bobbybudnick/SFS-Mobile-Internet-Device/WIN_20200922_145150.JPG

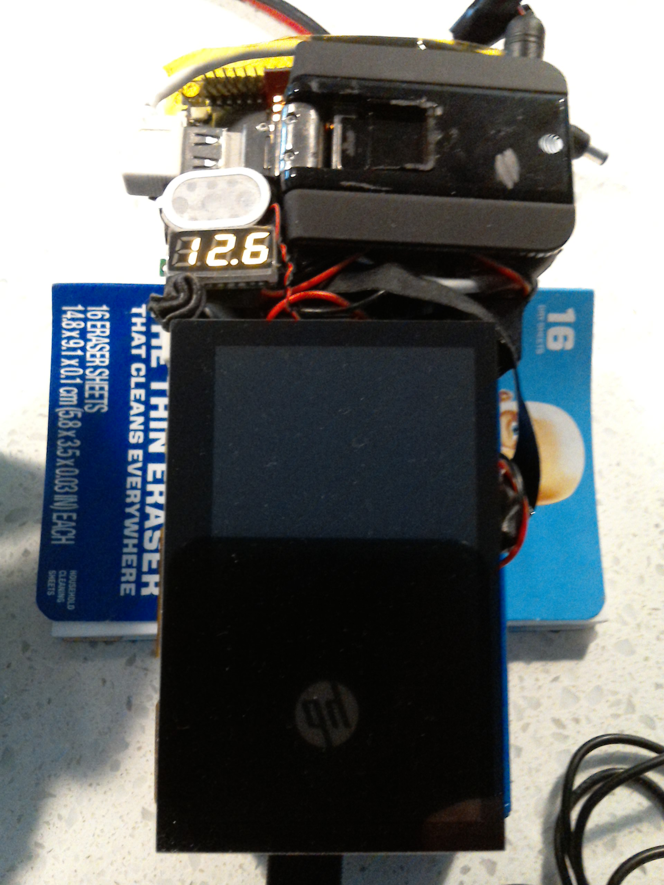
WIN_20200922_145150.JPG
