bobbybudnick/SFS-Mobile-Internet-Device/WIN_20200922_145137.JPG

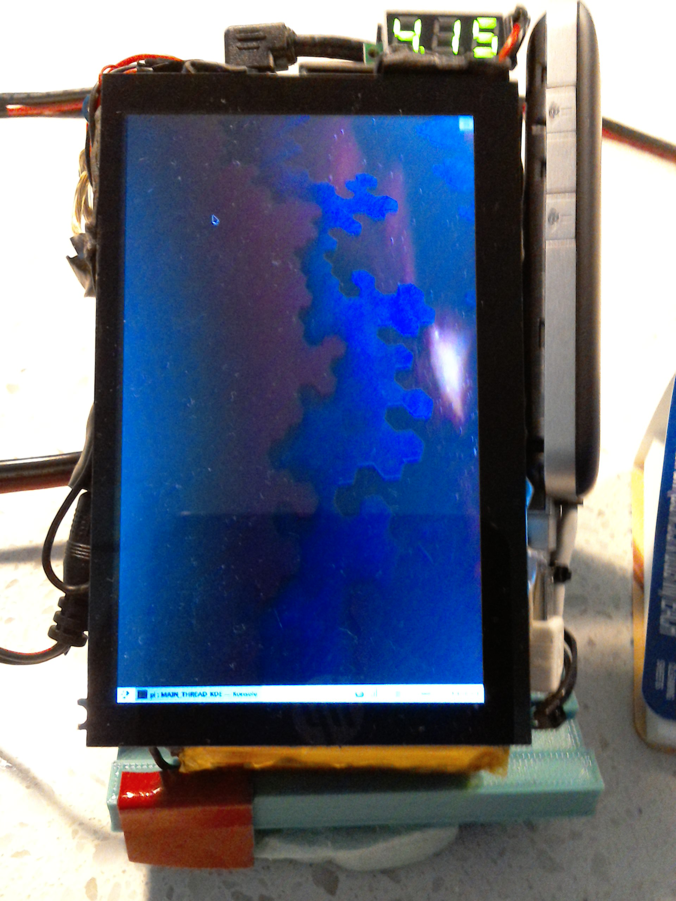
WIN_20200922_145137.JPG
