bobbybudnick/SFS-Mobile-Internet-Device/DIAGRAM1.jpg

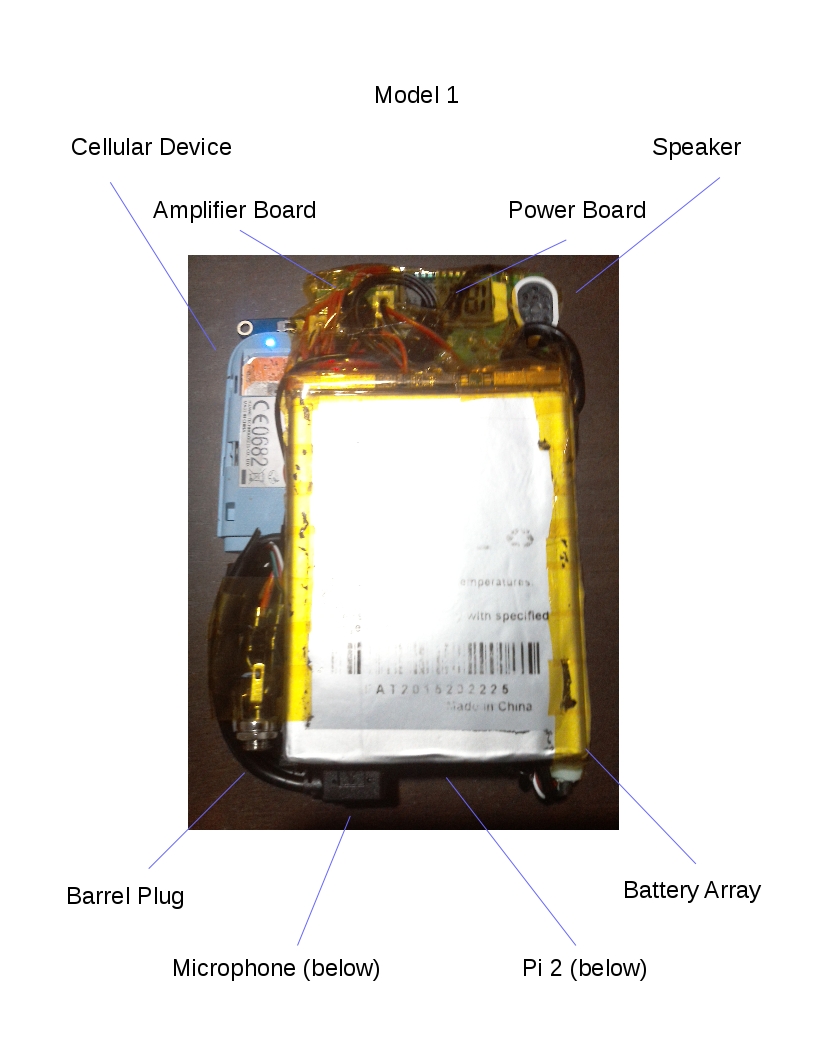
DIAGRAM1.jpg
