bobbybudnick/SFS-Mobile-Internet-Device/DIAGRAM2.jpg

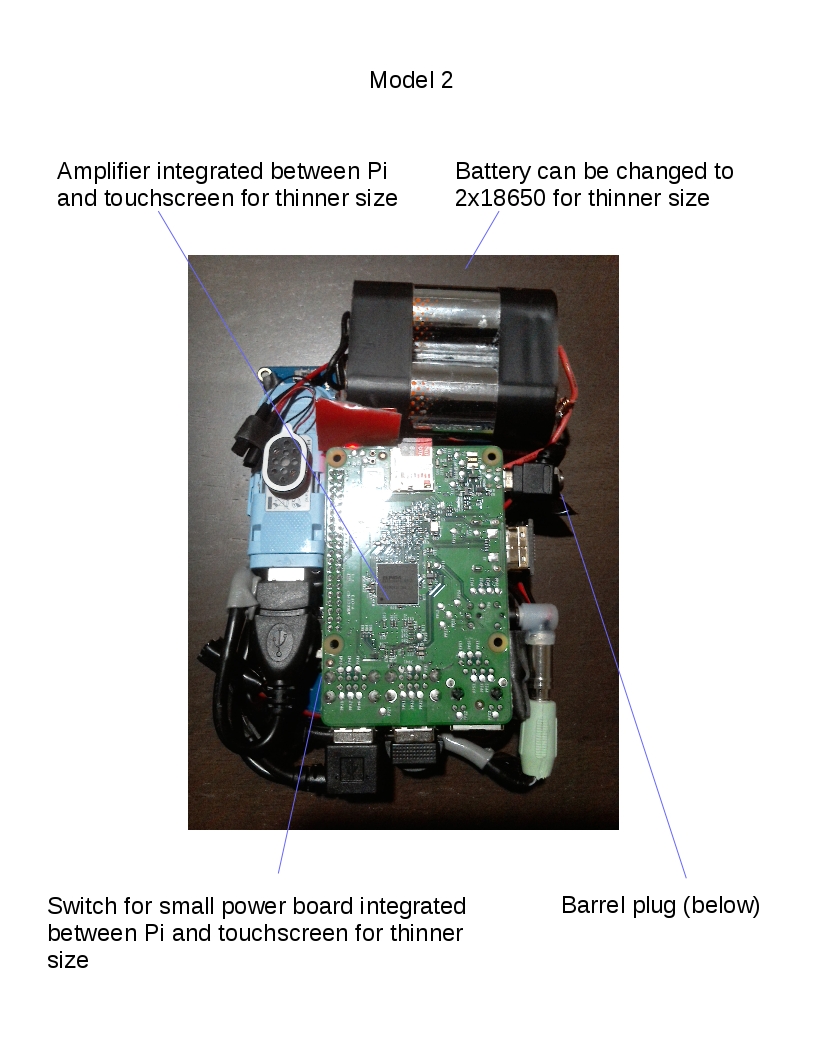
DIAGRAM2.jpg
