bobbybudnick/SFS-Mobile-Internet-Device/DIAGRAM3.jpg

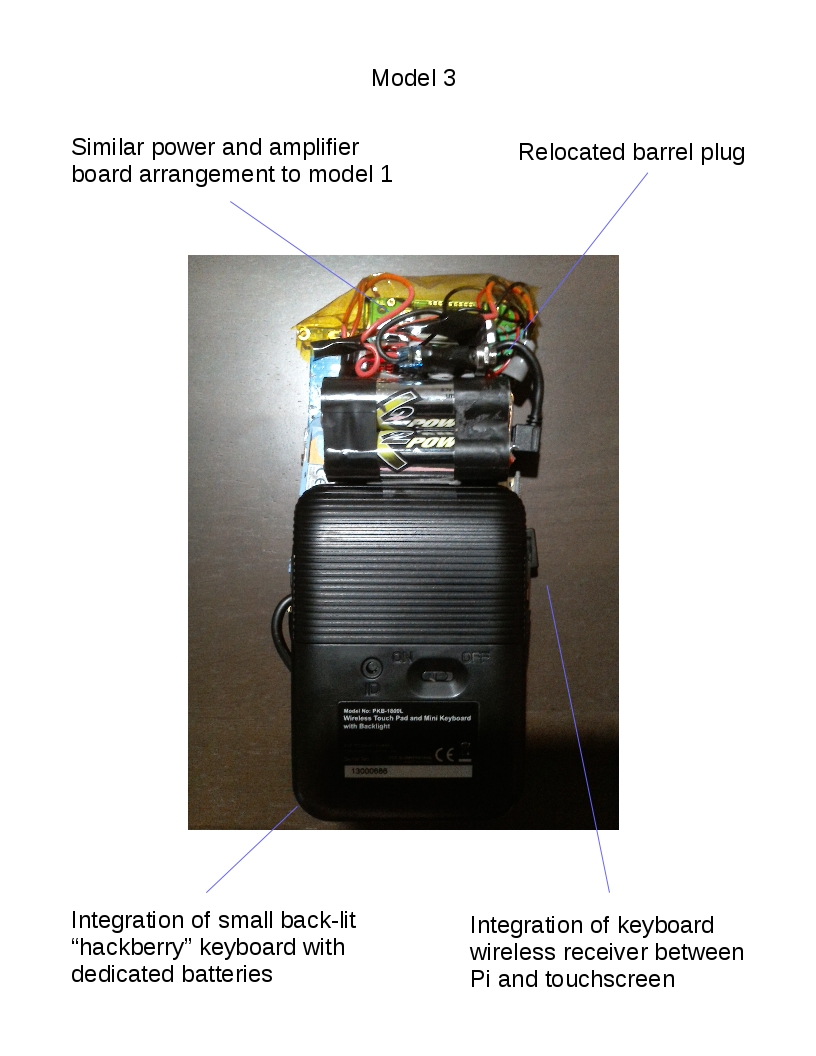
DIAGRAM3.jpg
