bobbybudnick/SFS-Mobile-Internet-Device/DIAGRAM4.jpg

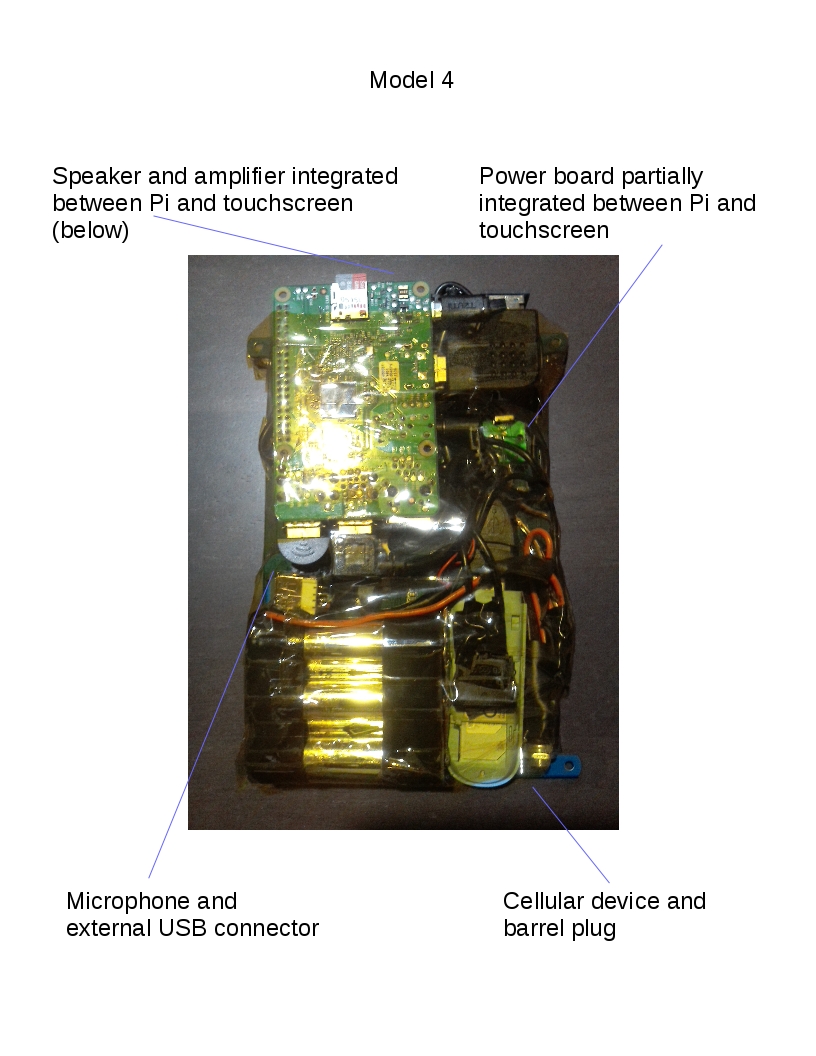
DIAGRAM4.jpg
