bobbybudnick/SFS-Mobile-Internet-Device/DIAGRAM5.jpg

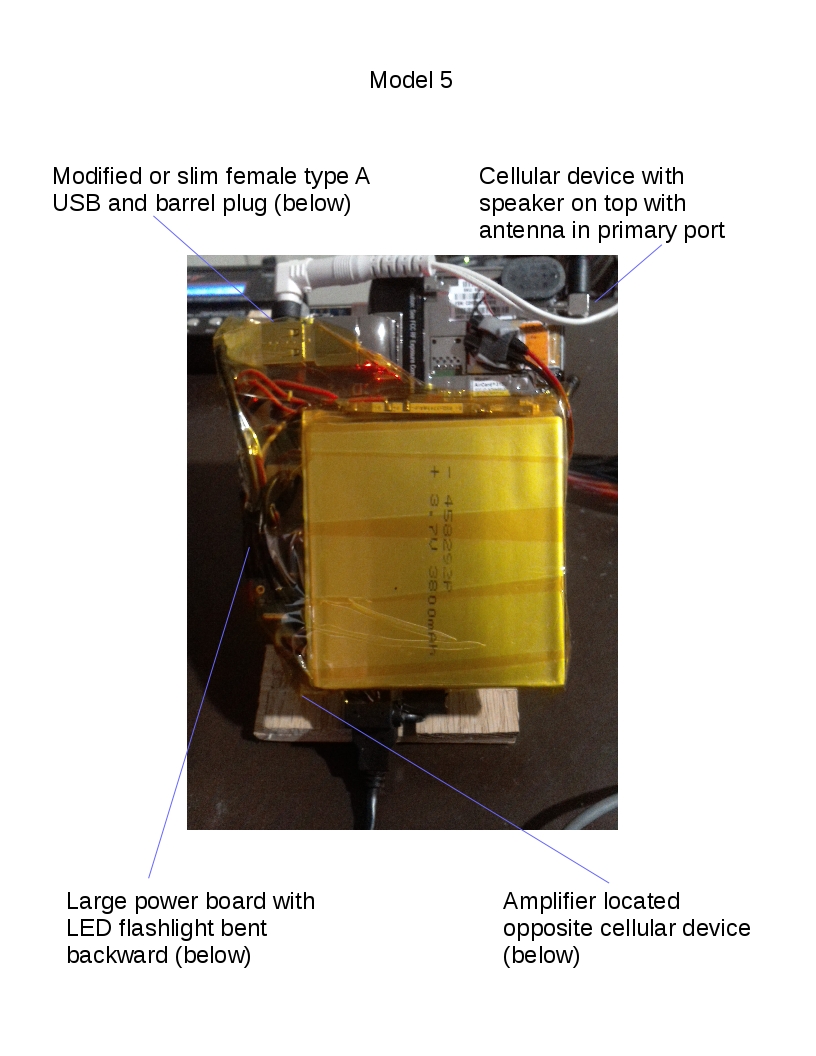
DIAGRAM5.jpg
