bobbybudnick/SFS-Mobile-Internet-Device/DIAGRAM6.jpg

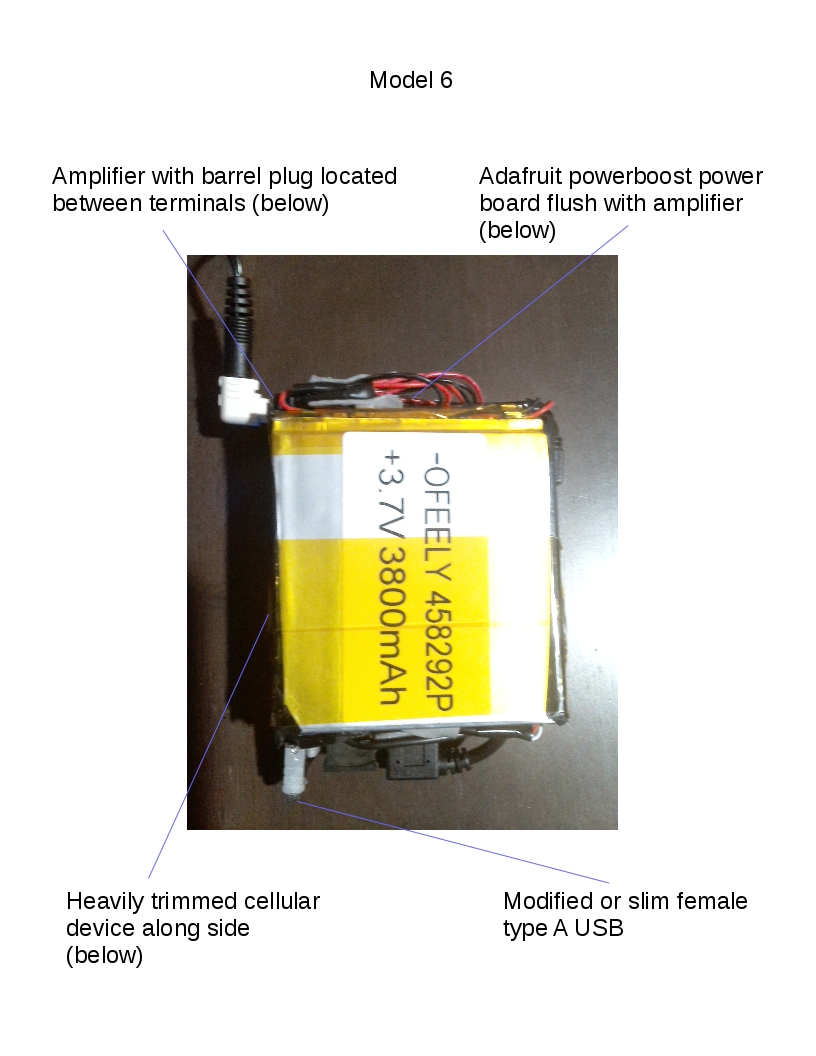
DIAGRAM6.jpg
