bobbybudnick/SFS-Mobile-Internet-Device/DIAGRAM7.jpg

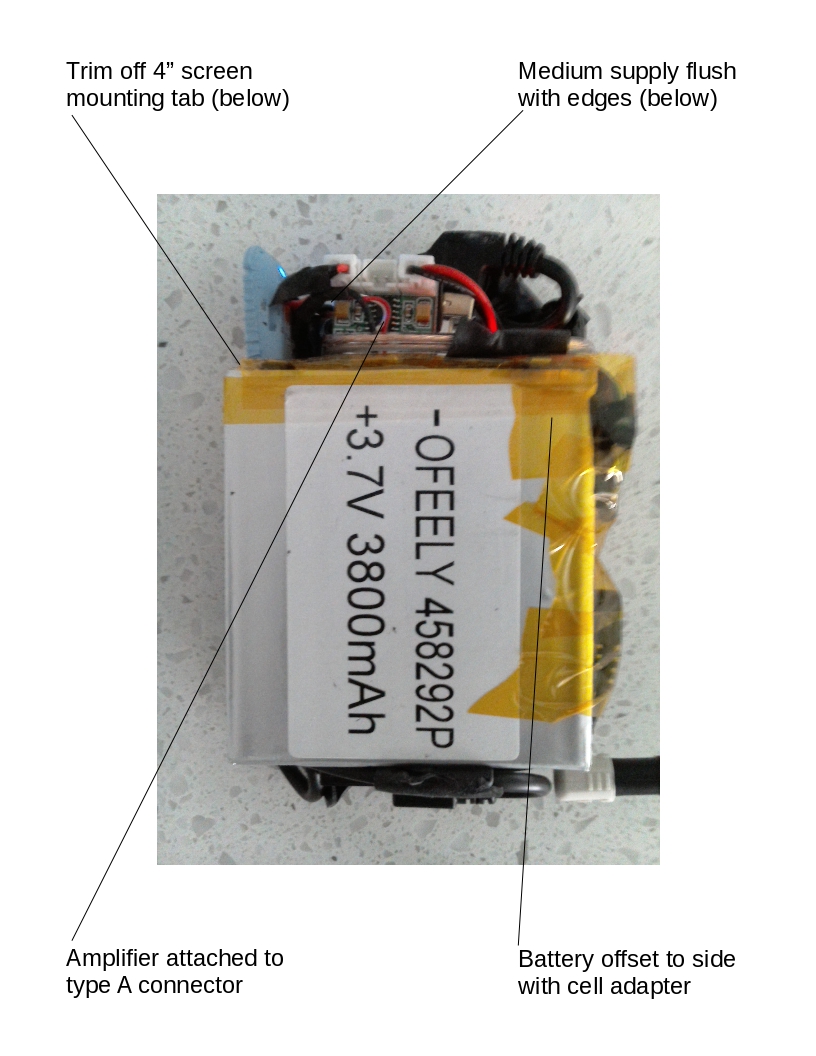
DIAGRAM7.jpg
