bobbybudnick/SFS-Mobile-Internet-Device/DIAGRAM8.jpg

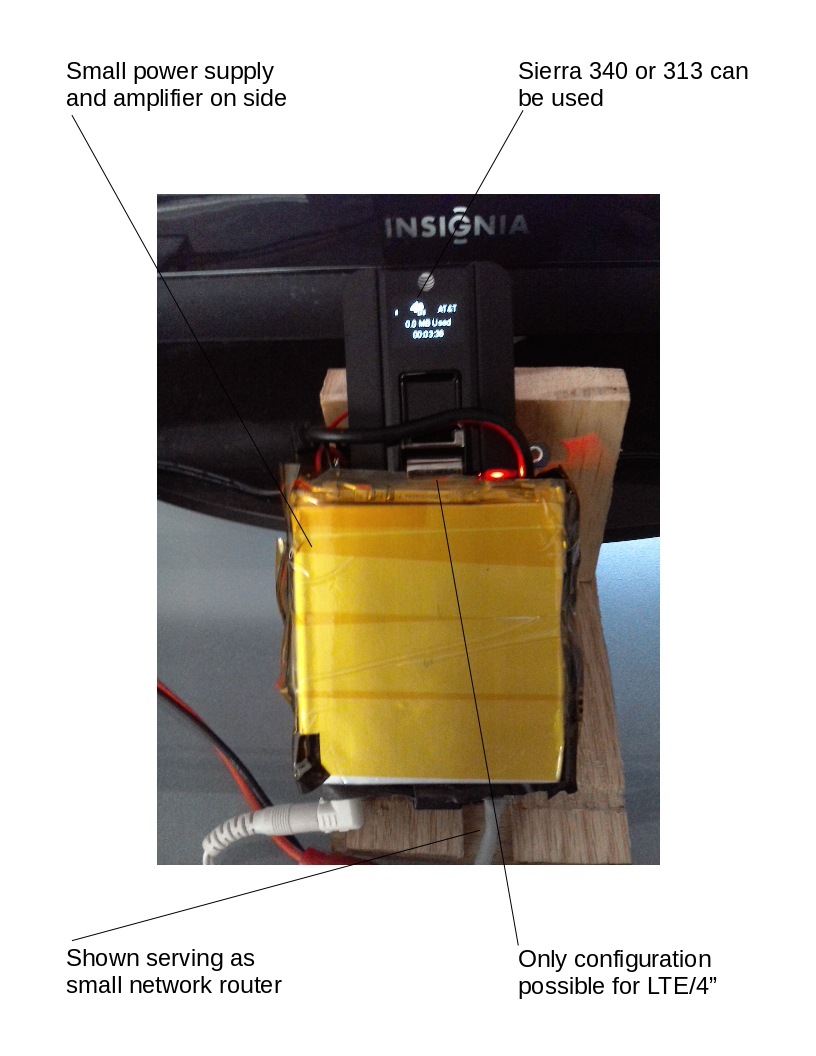
DIAGRAM8.jpg
