bobbybudnick/SFS-Mobile-Internet-Device/IMG_20220620_1944124.jpg

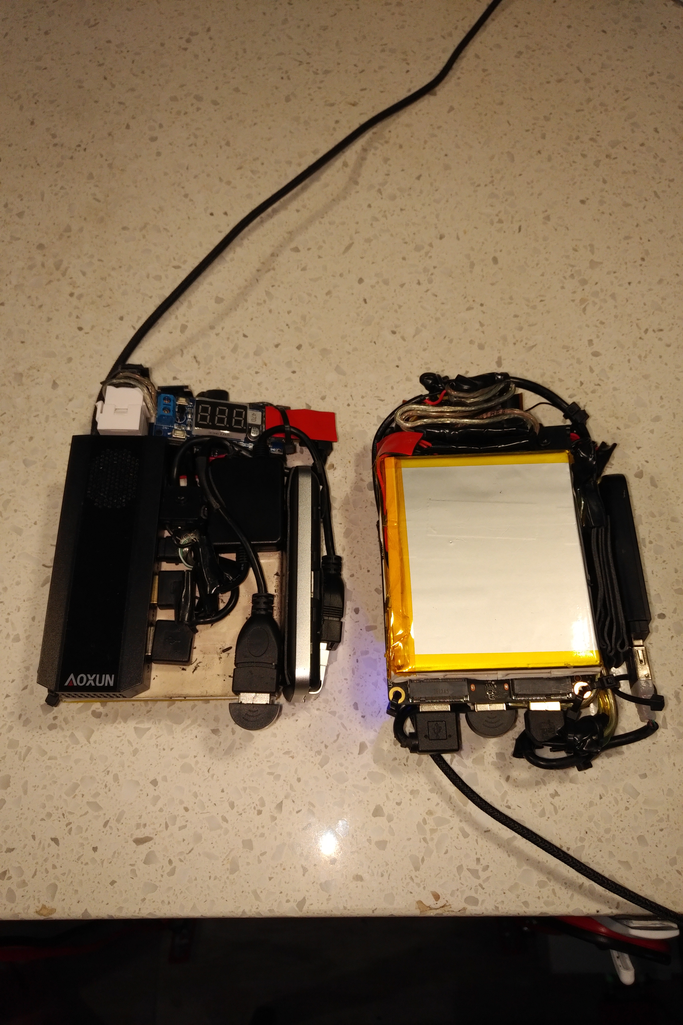
IMG_20220620_1944124.jpg
