bobbybudnick/SFS-Mobile-Internet-Device/IMG_20220621_1832572.jpg

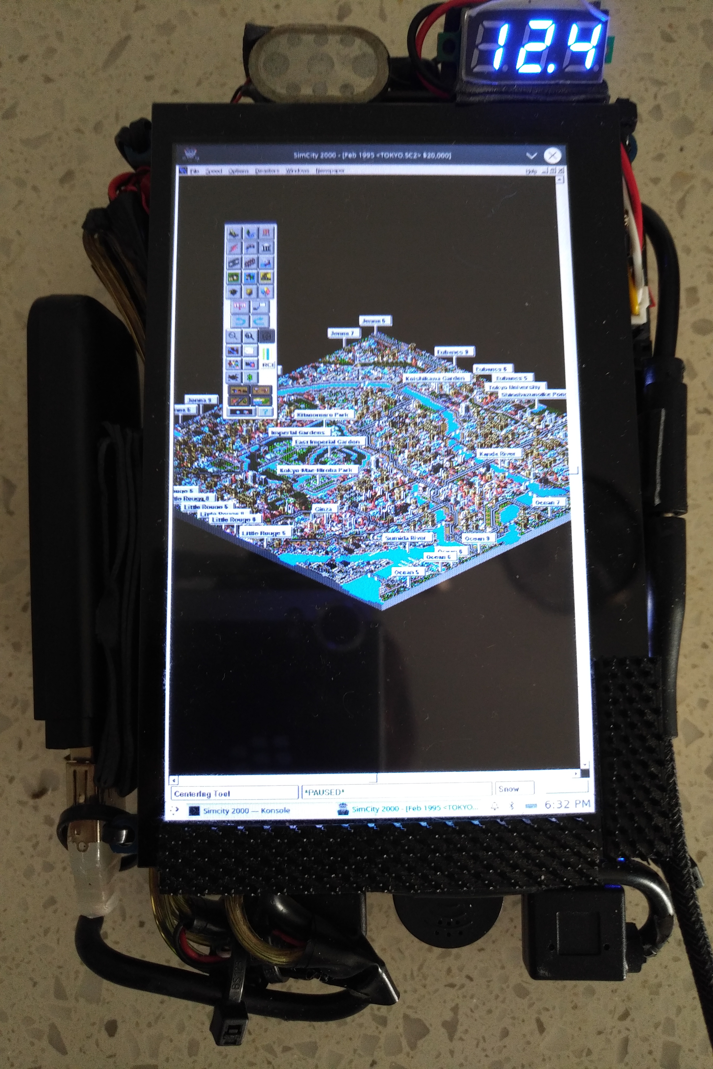
IMG_20220621_1832572.jpg
