bobbybudnick/SFS-Mobile-Internet-Device/IMG_20220621_1836071.jpg

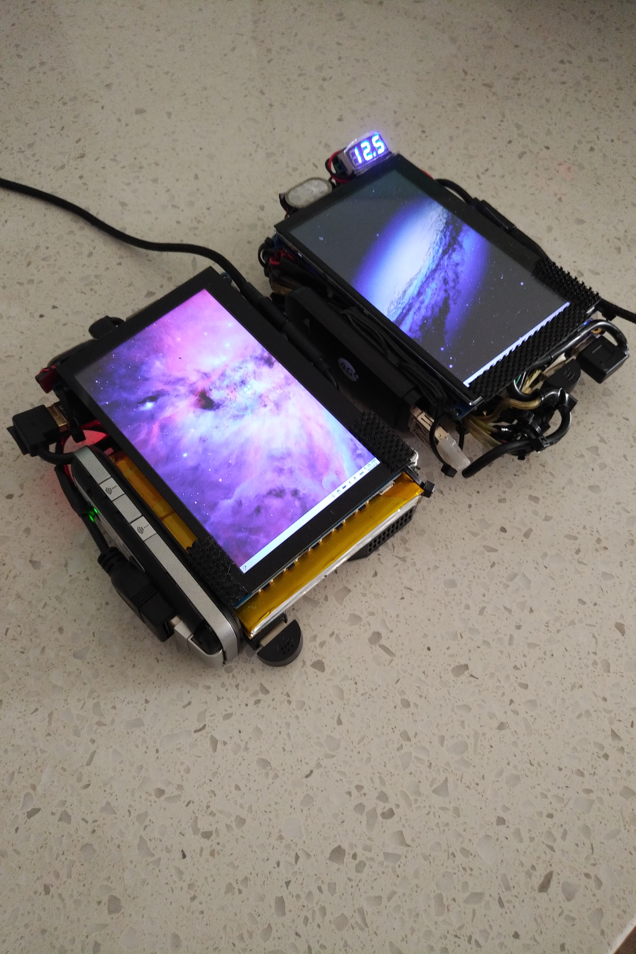
IMG_20220621_1836071.jpg
