bobbybudnick/SFS-Mobile-Internet-Device/IMG_20221021_1317442.jpg

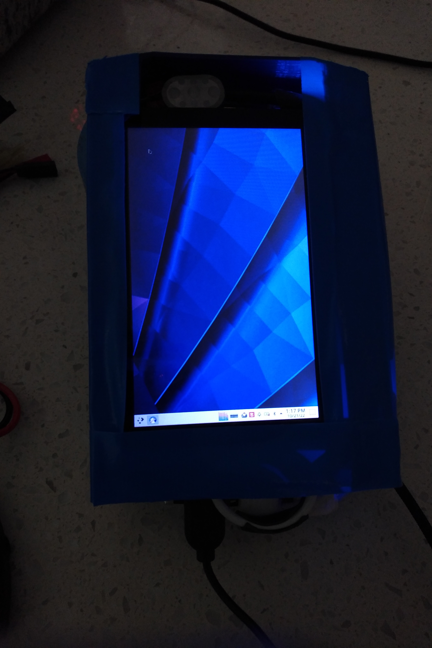
IMG_20221021_1317442.jpg
