bobbybudnick/SFS-Mobile-Internet-Device/IMG_20221023_1338296.jpg

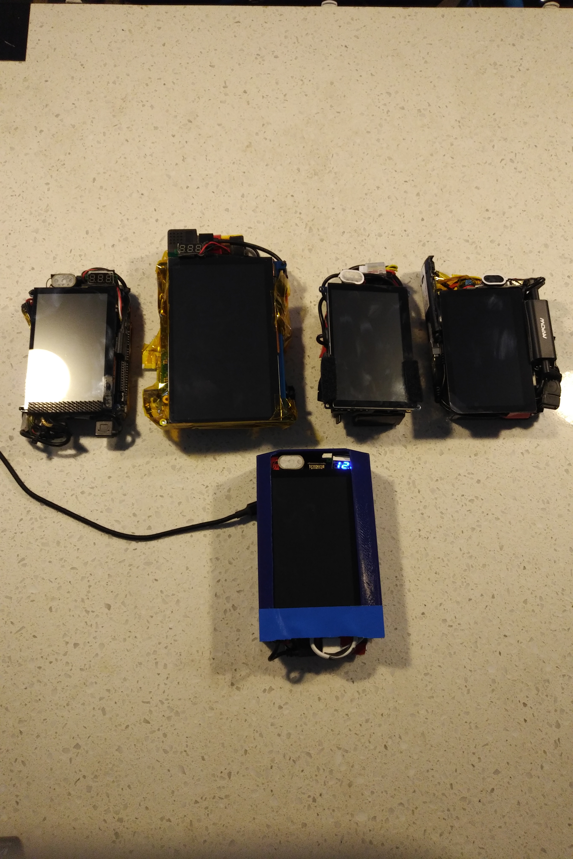
IMG_20221023_1338296.jpg
