bobbybudnick/SFS-Mobile-Internet-Device/IMG_20221023_1338296_CROPPED.jpg

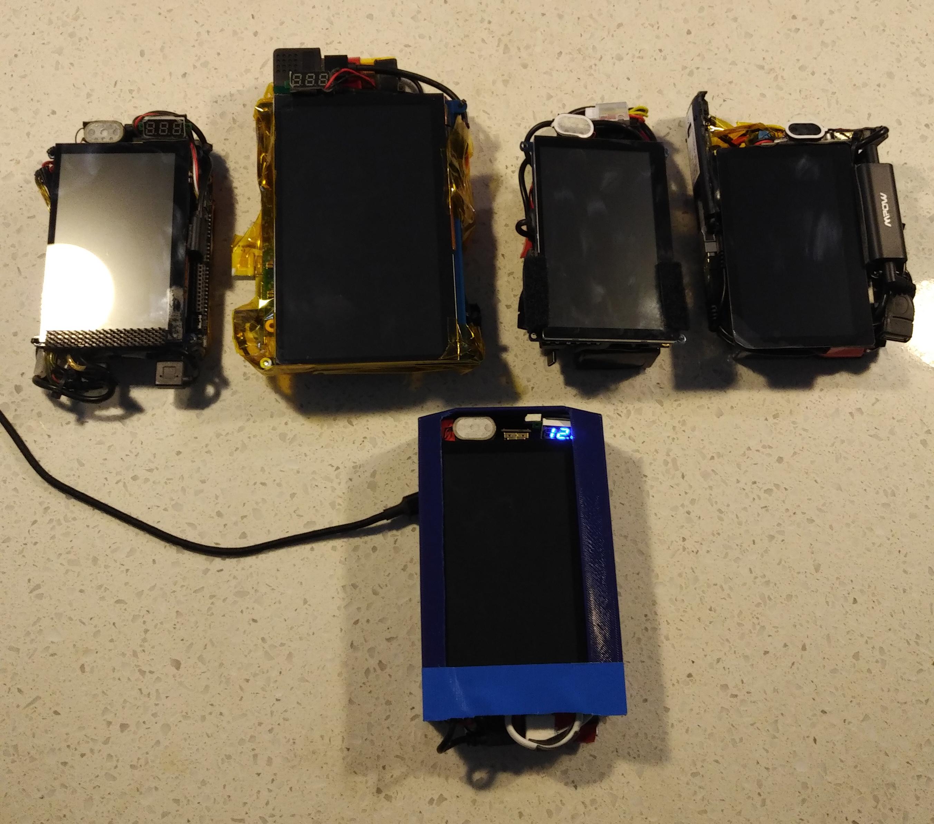
IMG_20221023_1338296_CROPPED.jpg
