bobbybudnick/SFS-Mobile-Internet-Device/IMG_20221023_1340297.jpg

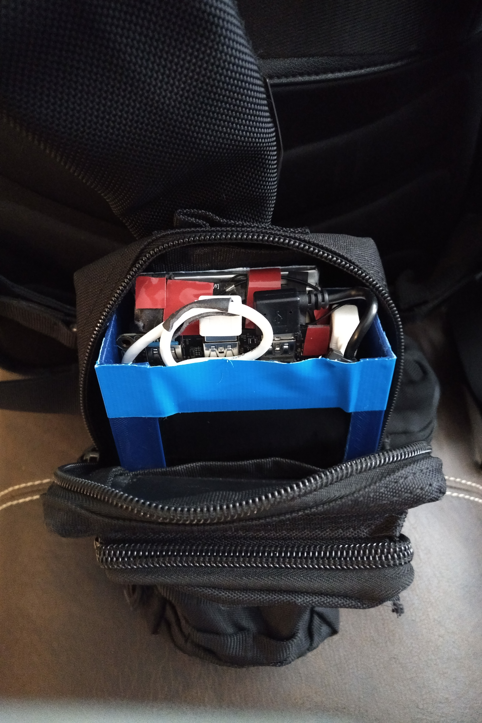
IMG_20221023_1340297.jpg
