bobbybudnick/SFS-Mobile-Internet-Device/IMG_20221023_1343329.jpg

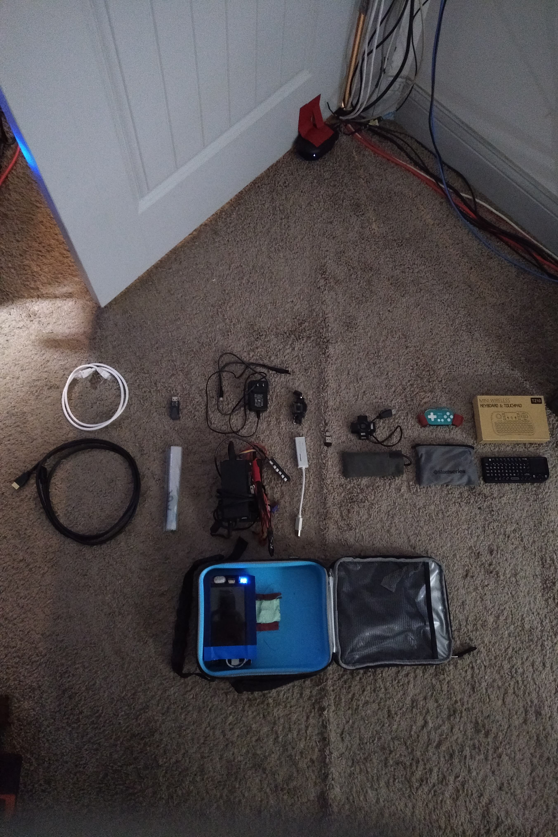
IMG_20221023_1343329.jpg
