bobbybudnick/SFS-Mobile-Internet-Device/IMG_20221023_1811454.jpg

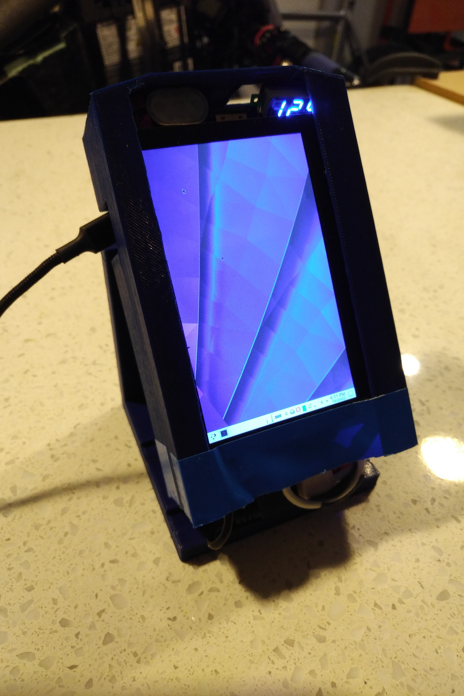
IMG_20221023_1811454.jpg
