bobbybudnick/SFS-Mobile-Internet-Device/IMG_20221119_1745131.jpg

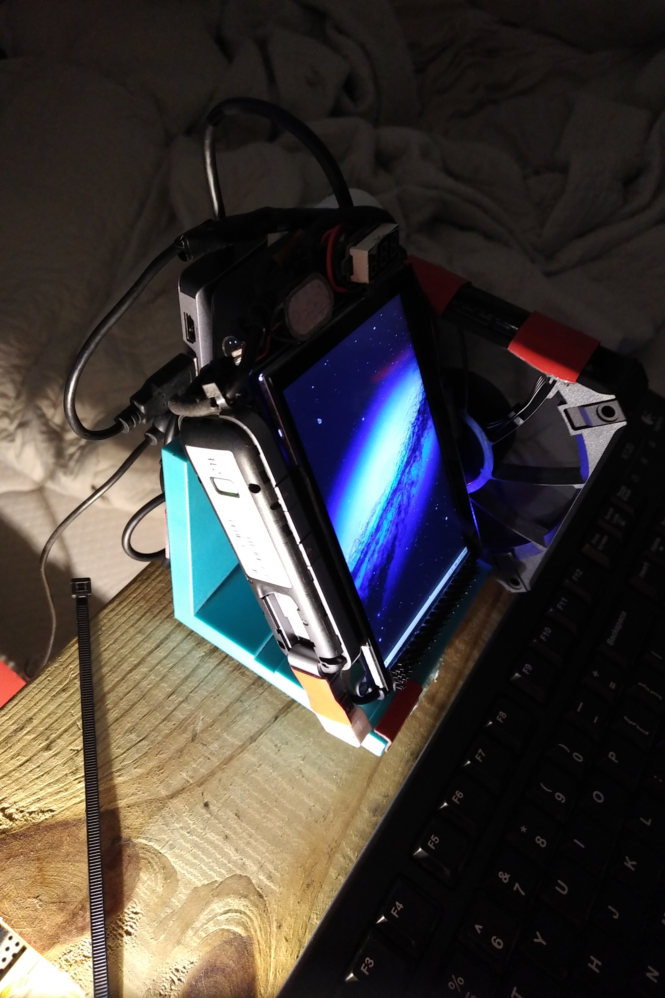
IMG_20221119_1745131.jpg
