bobbybudnick/SFS-Mobile-Internet-Device/IMG_20221130_1039581.jpg

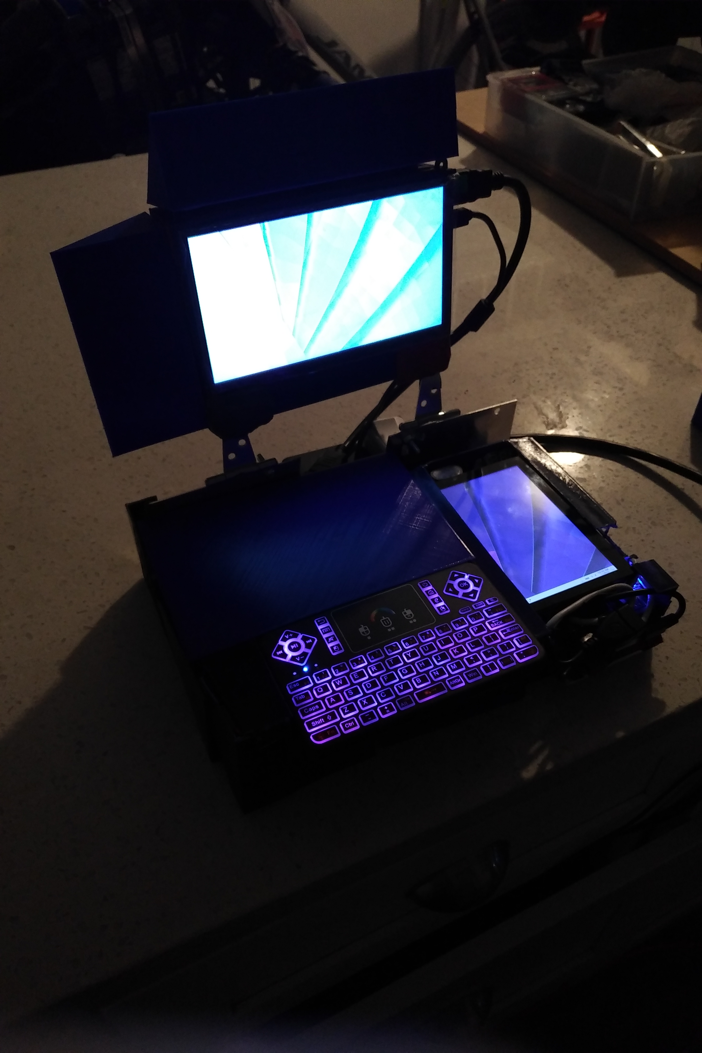
IMG_20221130_1039581.jpg
