bobbybudnick/SFS-Mobile-Internet-Device/IMG_20221130_1324098.jpg

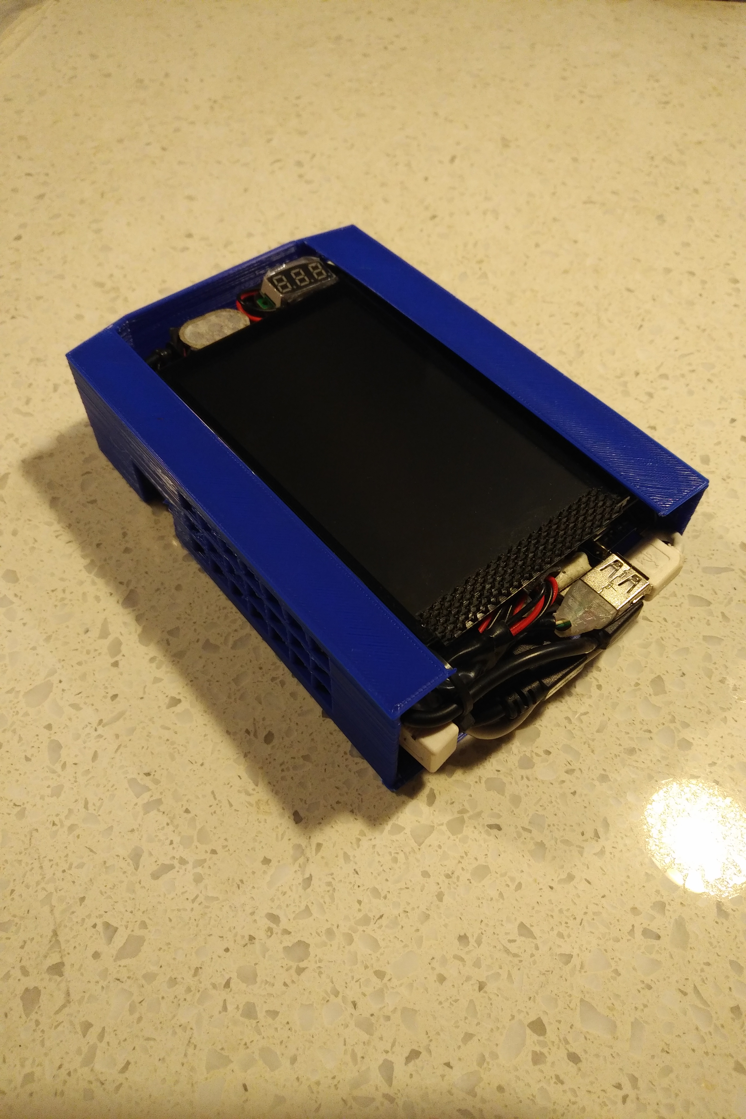
IMG_20221130_1324098.jpg
