bobbybudnick/SFS-Mobile-Internet-Device/IMG_20230730_1251246.jpg

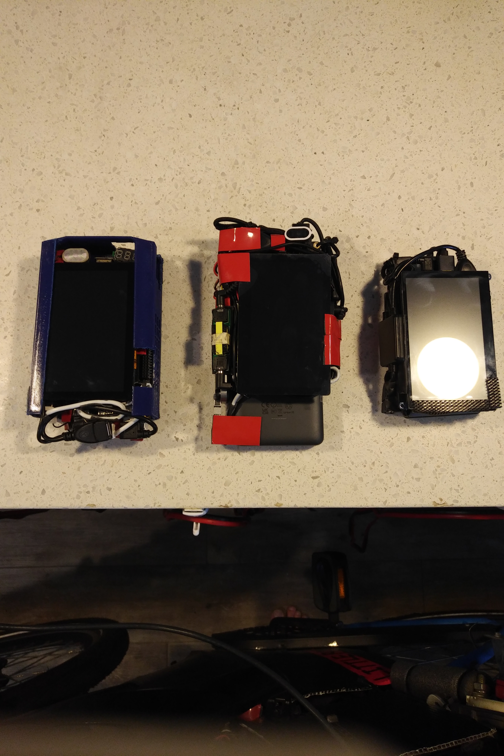
IMG_20230730_1251246.jpg
