bobbybudnick/SFS-Mobile-Internet-Device/IMG_20230730_1541438.jpg

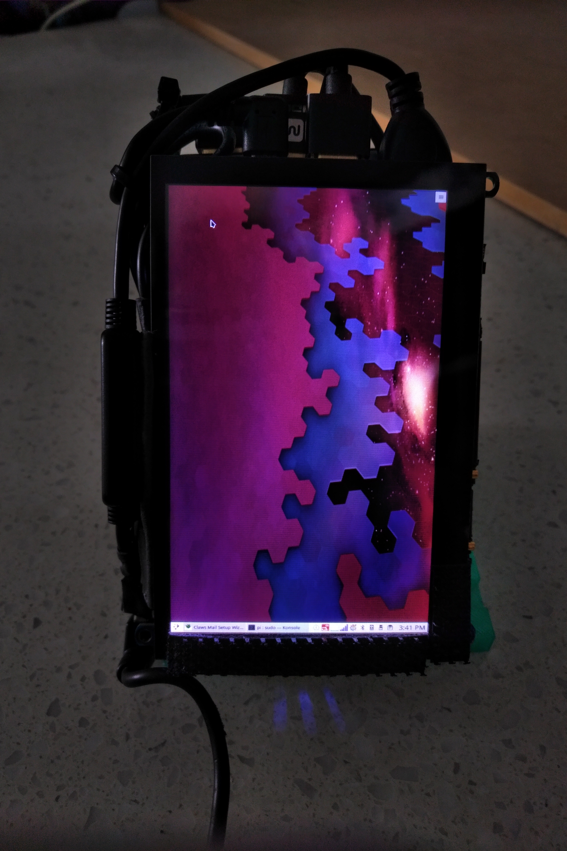
IMG_20230730_1541438.jpg
