bobbybudnick/SFS-Mobile-Internet-Device/IMG_20230812_1313022.jpg

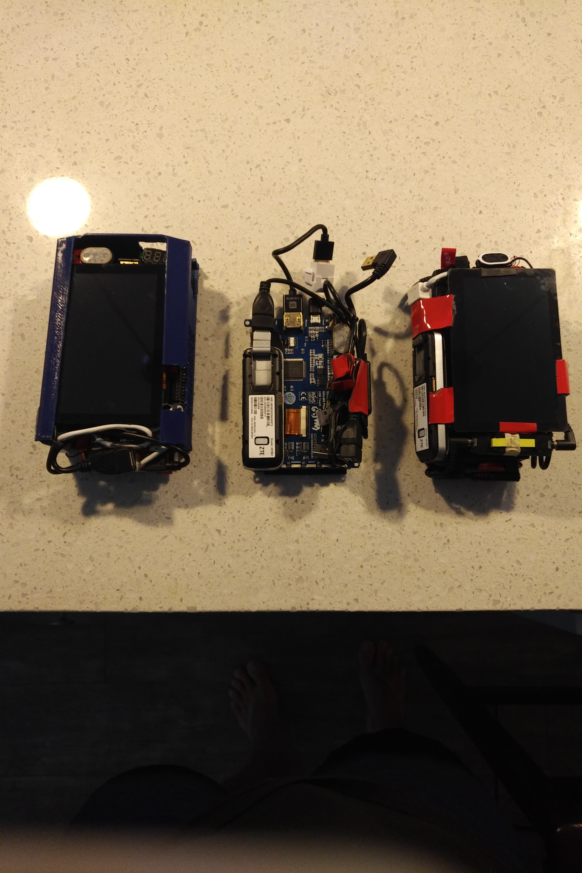
IMG_20230812_1313022.jpg
