bobbybudnick/SFS-Mobile-Internet-Device/IMG_20230812_1506374.jpg

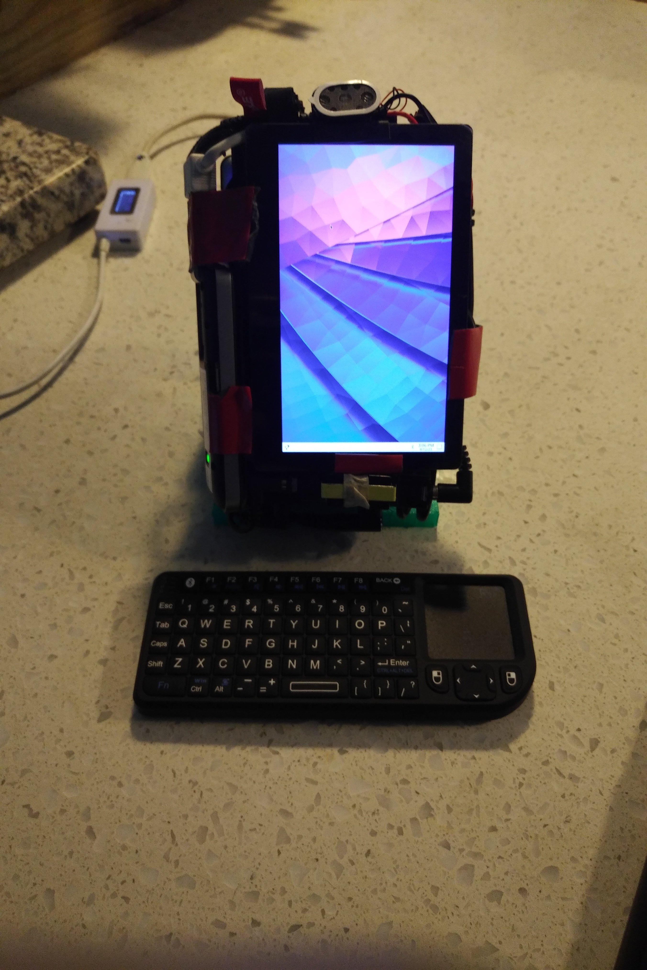
IMG_20230812_1506374.jpg
