bobbybudnick/SFS-Mobile-Internet-Device/MODEL_9.jpg

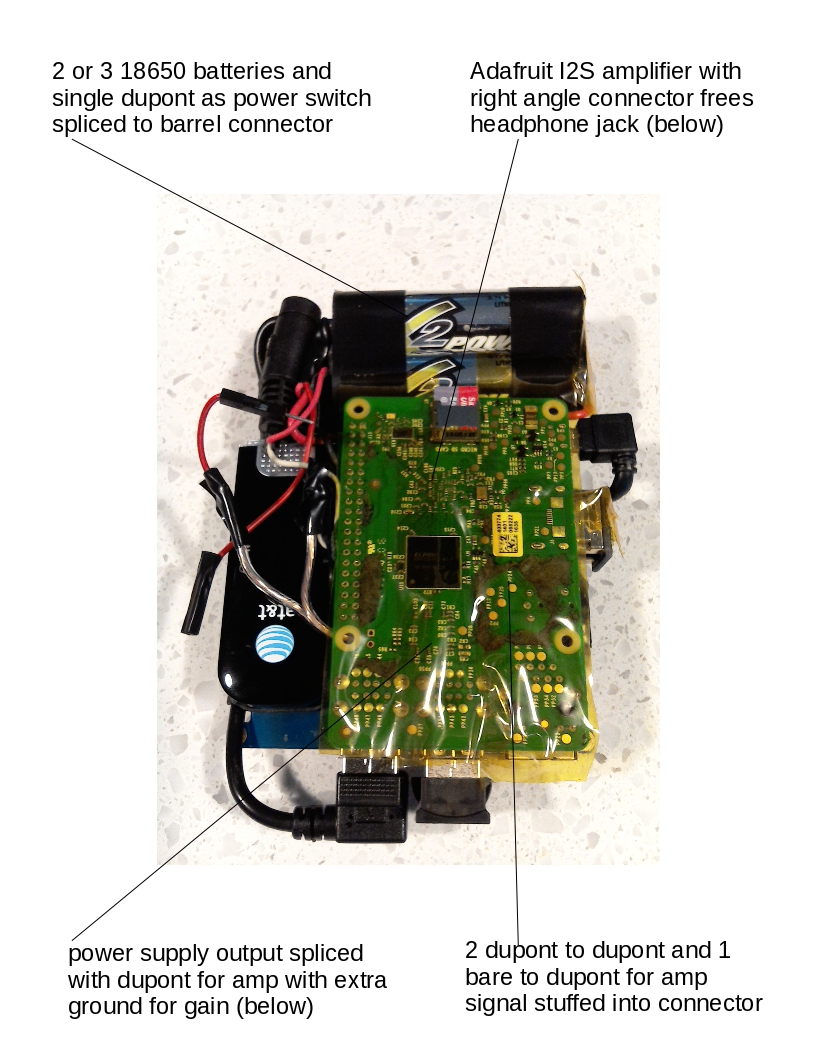
MODEL_9.jpg
