bobbybudnick/SFS-Mobile-Internet-Device/MODEL_ZERO.jpg

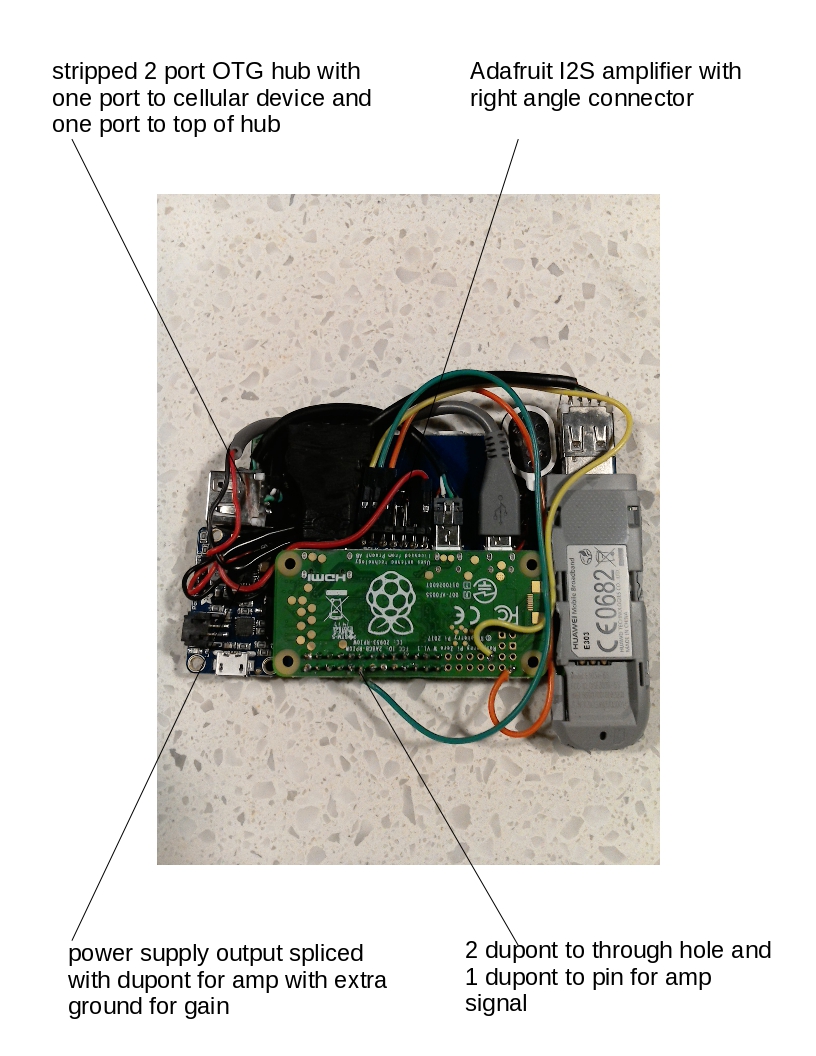
MODEL_ZERO.jpg
