bobbybudnick/SFS-Mobile-Internet-Device/WELCOME4.jpg

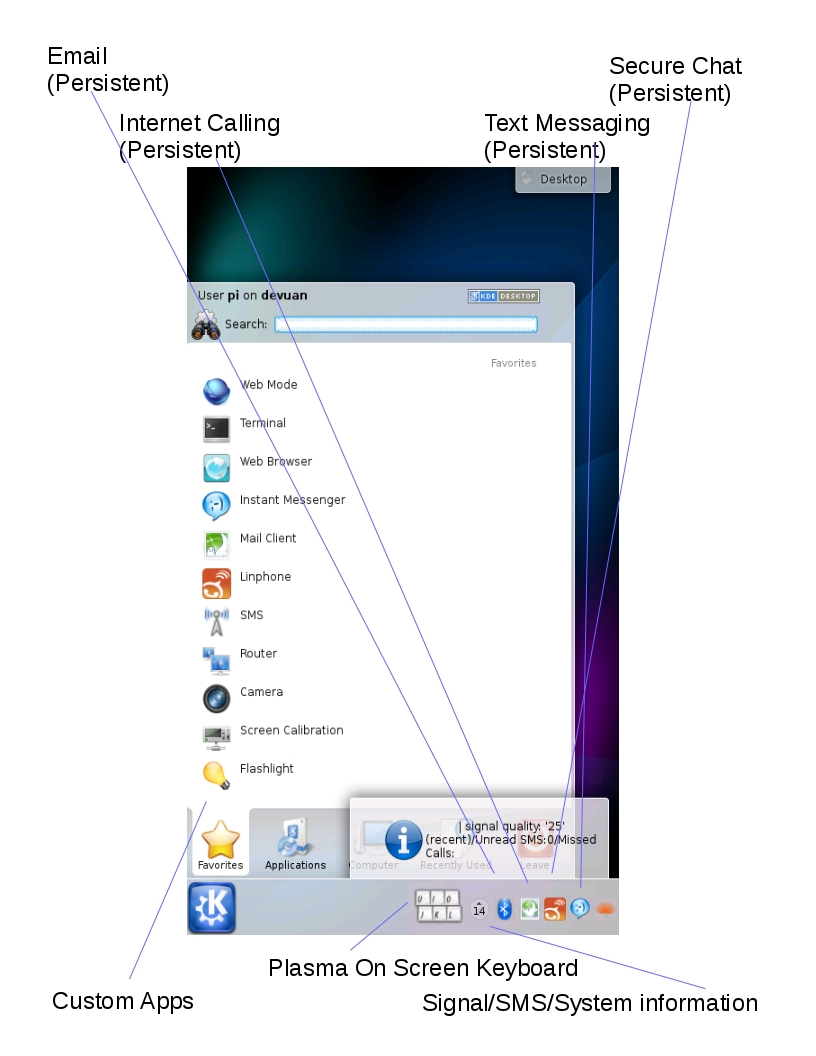
WELCOME4.jpg
