bobbybudnick/SFS-Mobile-Internet-Device/WELCOME5.jpg

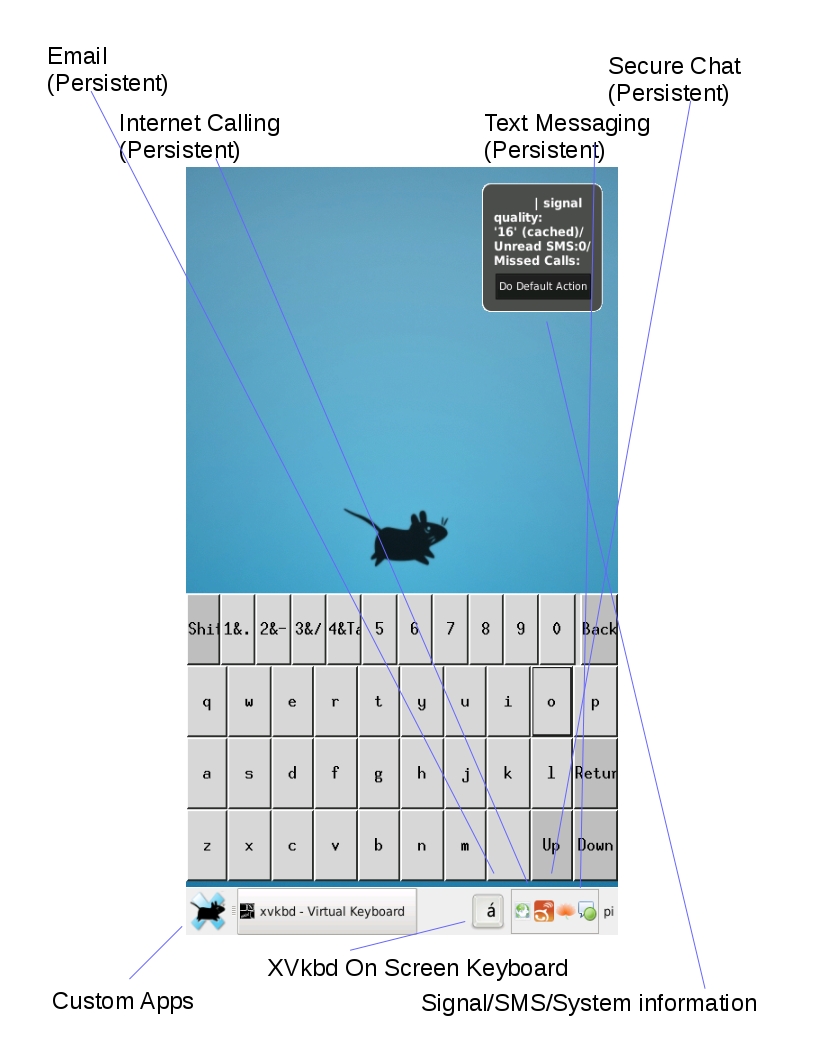
WELCOME5.jpg
