bobbybudnick/SFS-Mobile-Internet-Device/WELCOME_KDE_SMALL_1.jpg

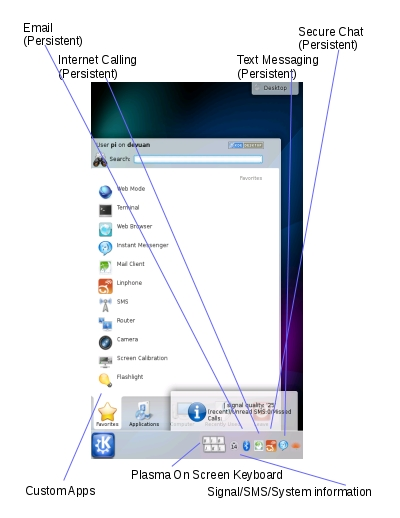
WELCOME_KDE_SMALL_1.jpg
