bobbybudnick/SFS-Mobile-Internet-Device/WIN_20161006_074420.JPG

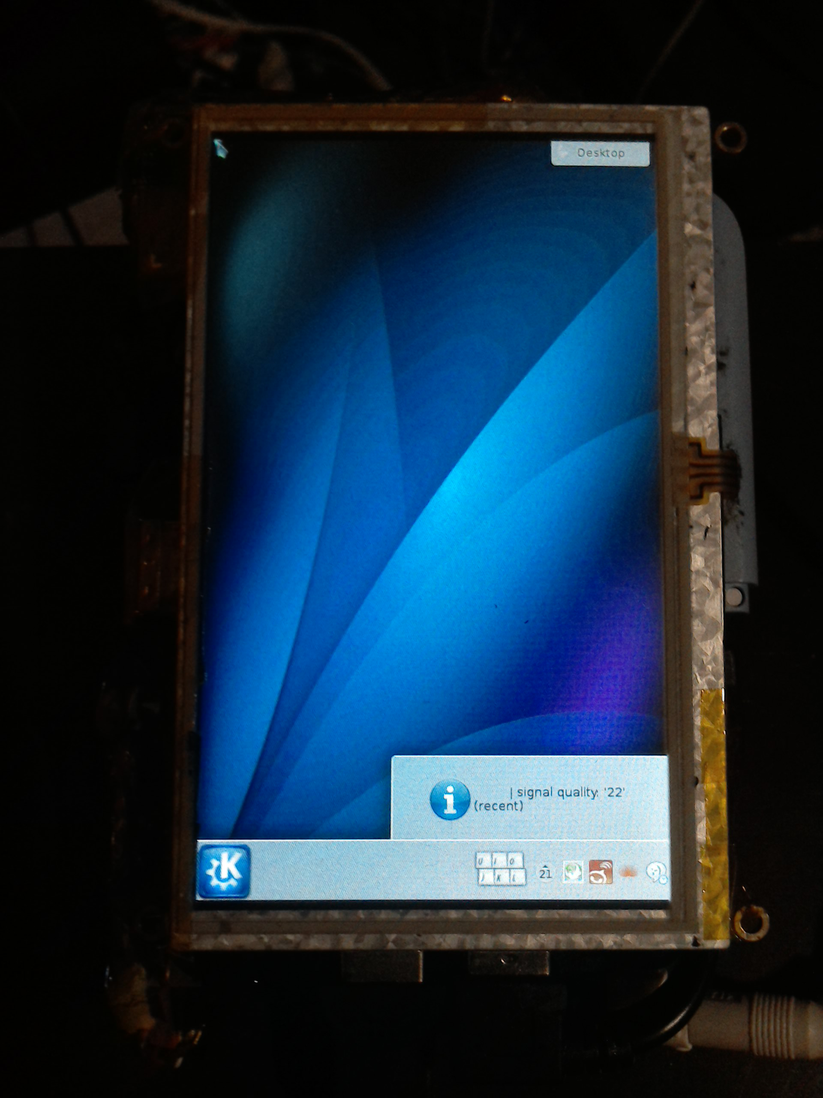
WIN_20161006_074420.JPG
