bobbybudnick/SFS-Mobile-Internet-Device/WIN_20161006_080020.JPG

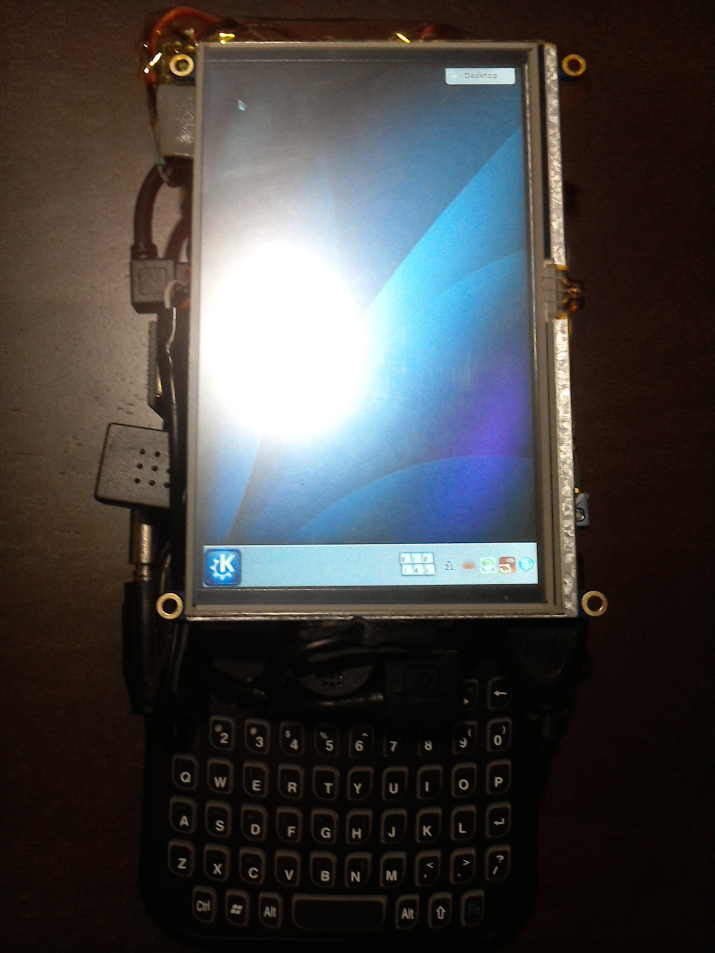
WIN_20161006_080020.JPG
