bobbybudnick/SFS-Mobile-Internet-Device/WIN_20161006_080313.JPG

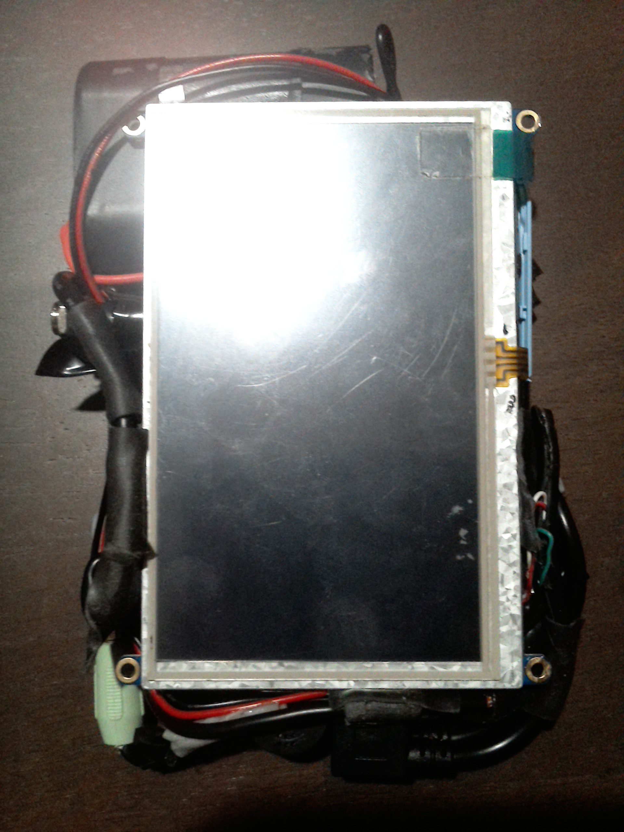
WIN_20161006_080313.JPG
