bobbybudnick/SFS-Mobile-Internet-Device/WIN_20161006_080540.JPG

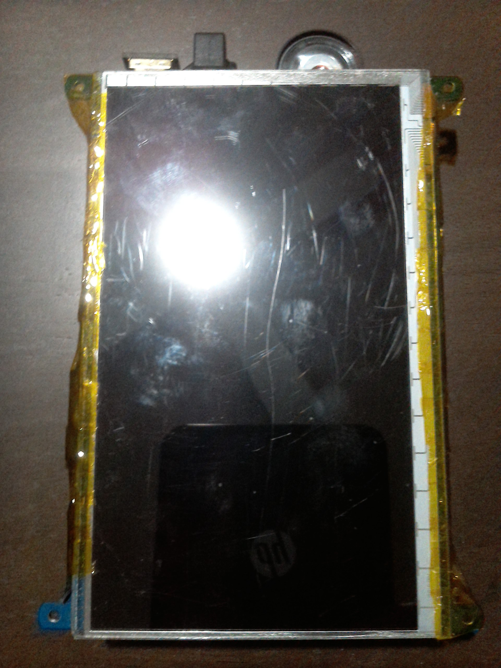
WIN_20161006_080540.JPG
