bobbybudnick/SFS-Mobile-Internet-Device/WIN_20161006_080806.JPG

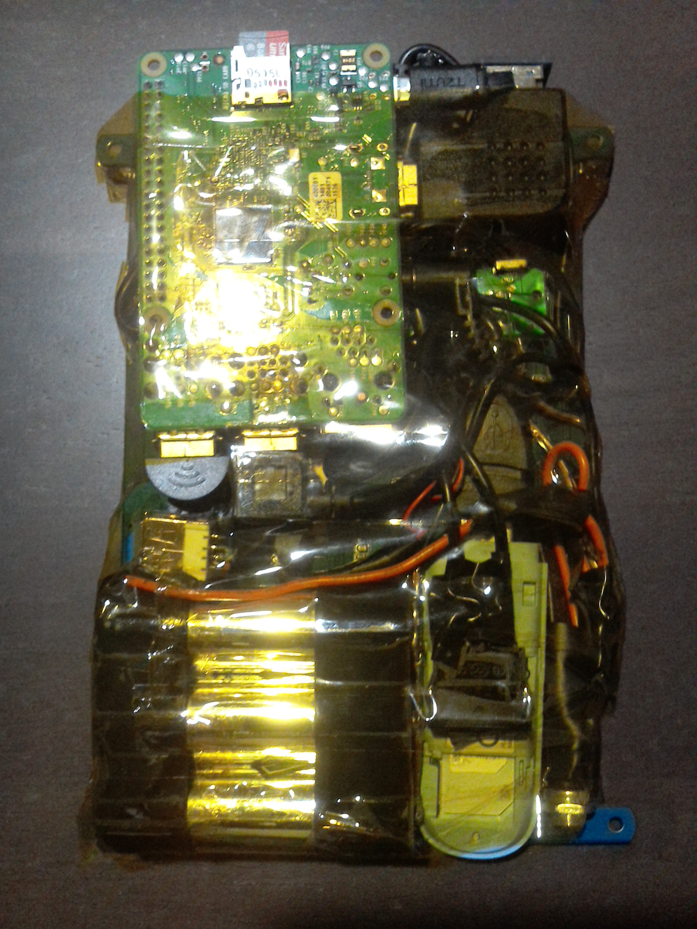
WIN_20161006_080806.JPG
