bobbybudnick/SFS-Mobile-Internet-Device/WIN_20161015_141846.JPG

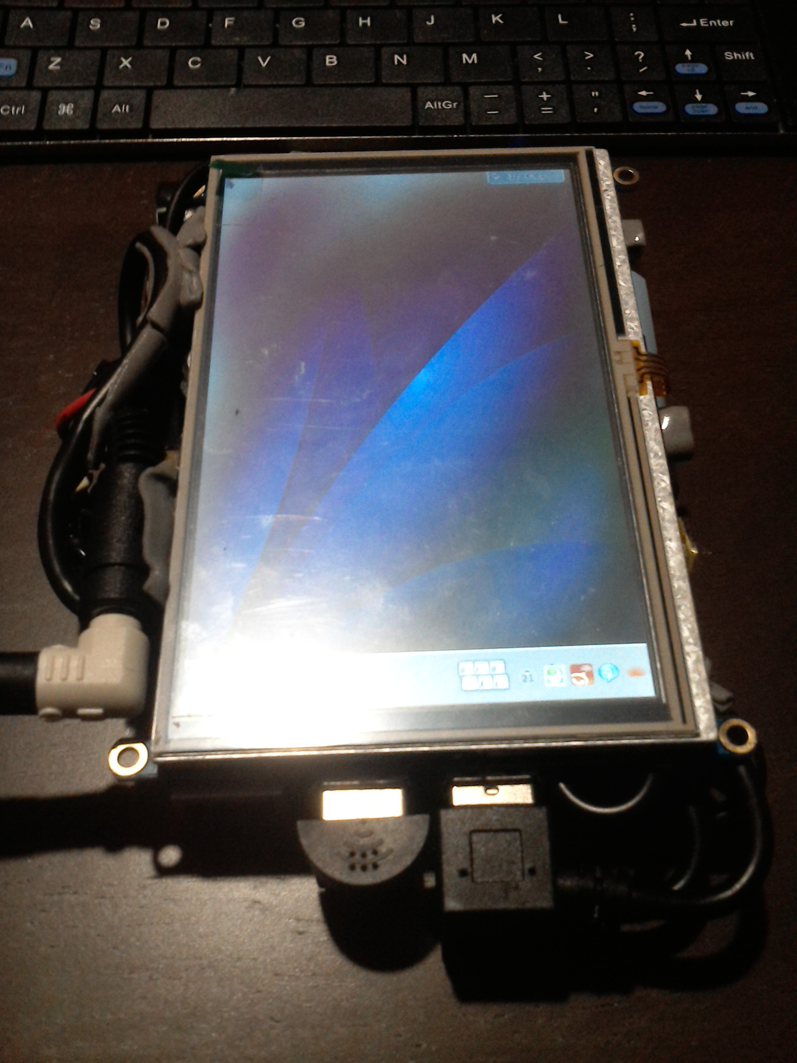
WIN_20161015_141846.JPG
