bobbybudnick/SFS-Mobile-Internet-Device/WIN_20161016_093545.JPG

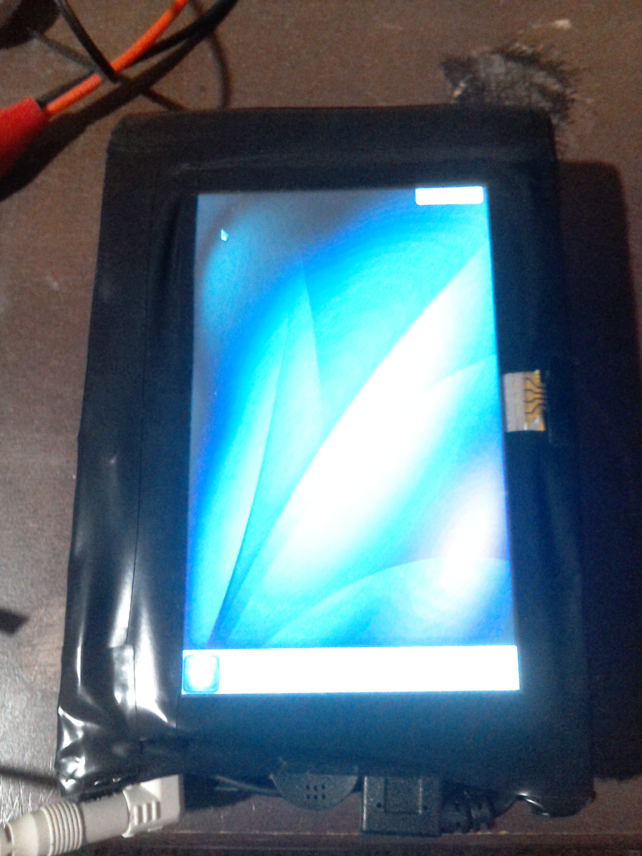
WIN_20161016_093545.JPG
