bobbybudnick/SFS-Mobile-Internet-Device/WIN_20161102_094452.JPG

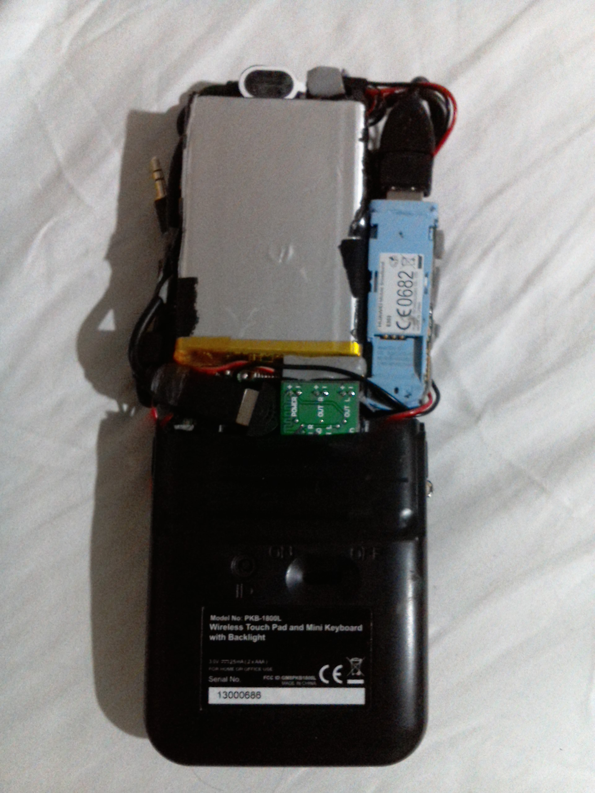
WIN_20161102_094452.JPG
