bobbybudnick/SFS-Mobile-Internet-Device/WIN_20161102_094508.JPG

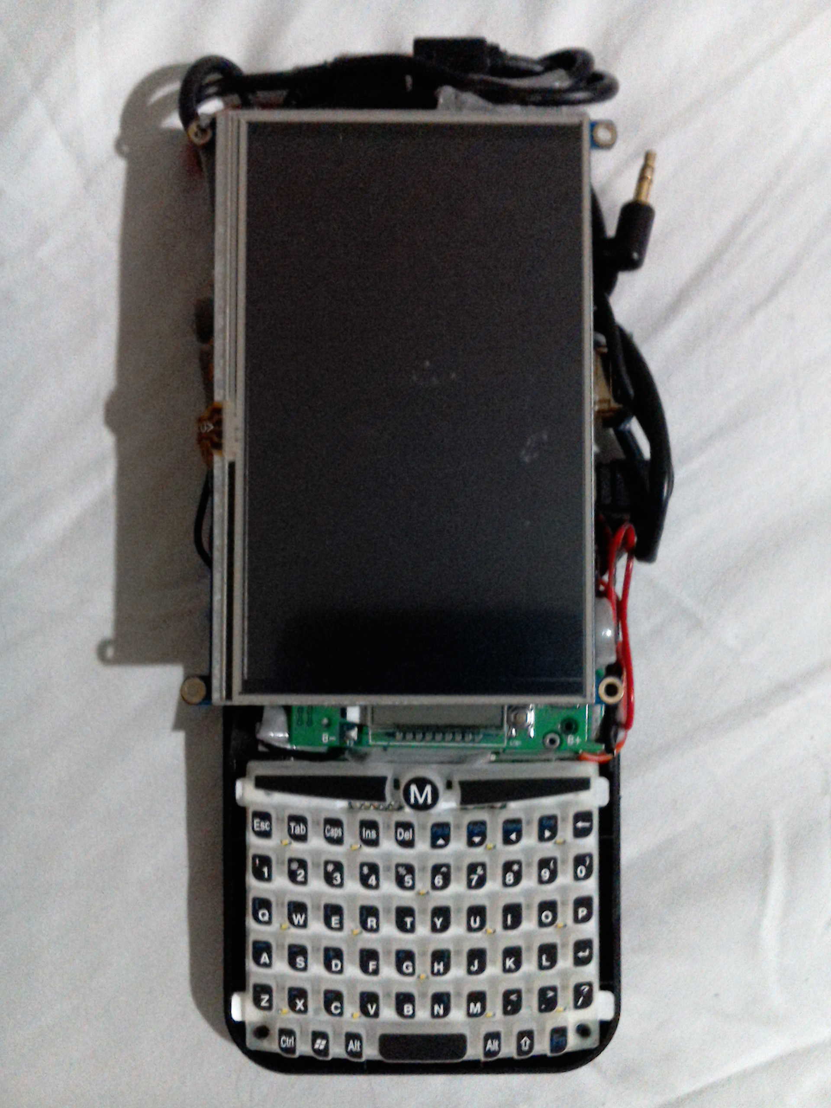
WIN_20161102_094508.JPG
