bobbybudnick/SFS-Mobile-Internet-Device/WIN_20161123_112157.JPG

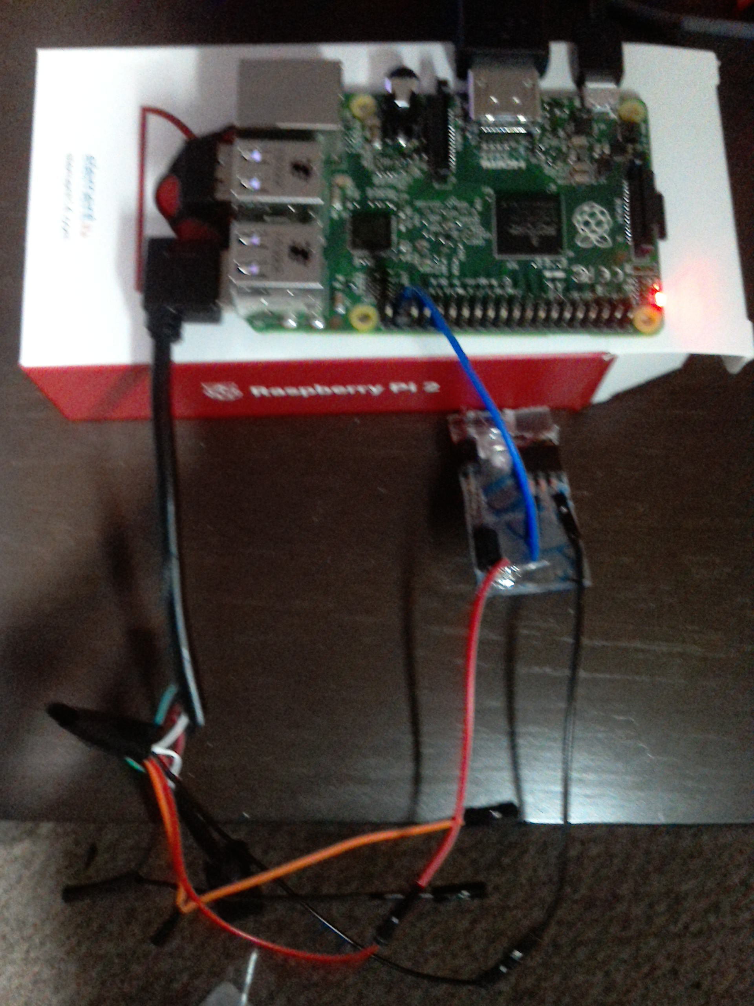
WIN_20161123_112157.JPG
