bobbybudnick/SFS-Mobile-Internet-Device/WIN_20161123_112224.JPG

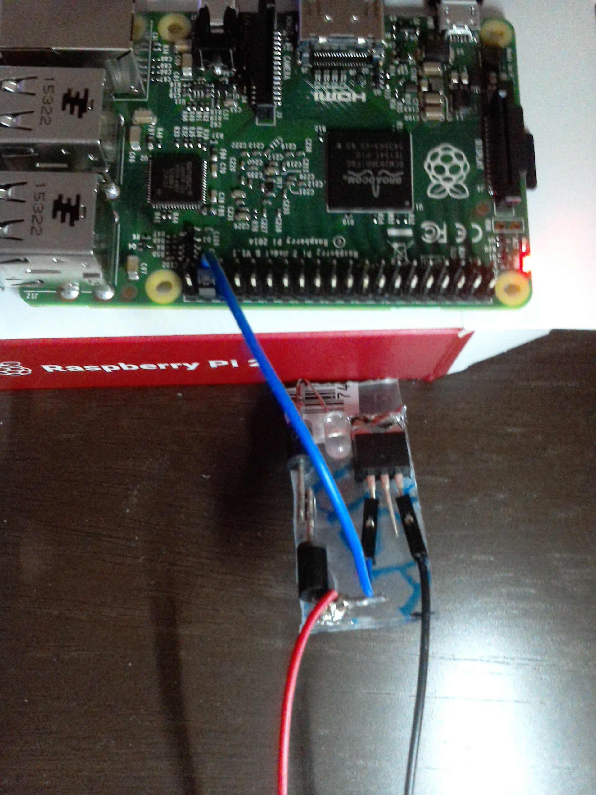
WIN_20161123_112224.JPG
