bobbybudnick/SFS-Mobile-Internet-Device/WIN_20161127_074002.JPG

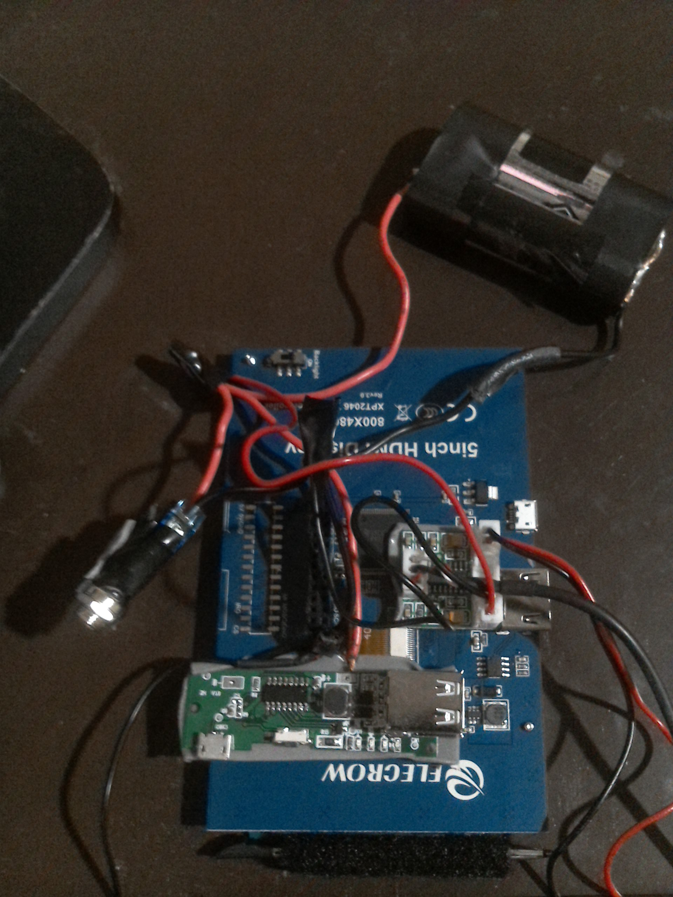
WIN_20161127_074002.JPG
