bobbybudnick/SFS-Mobile-Internet-Device/WIN_20161223_085916.JPG

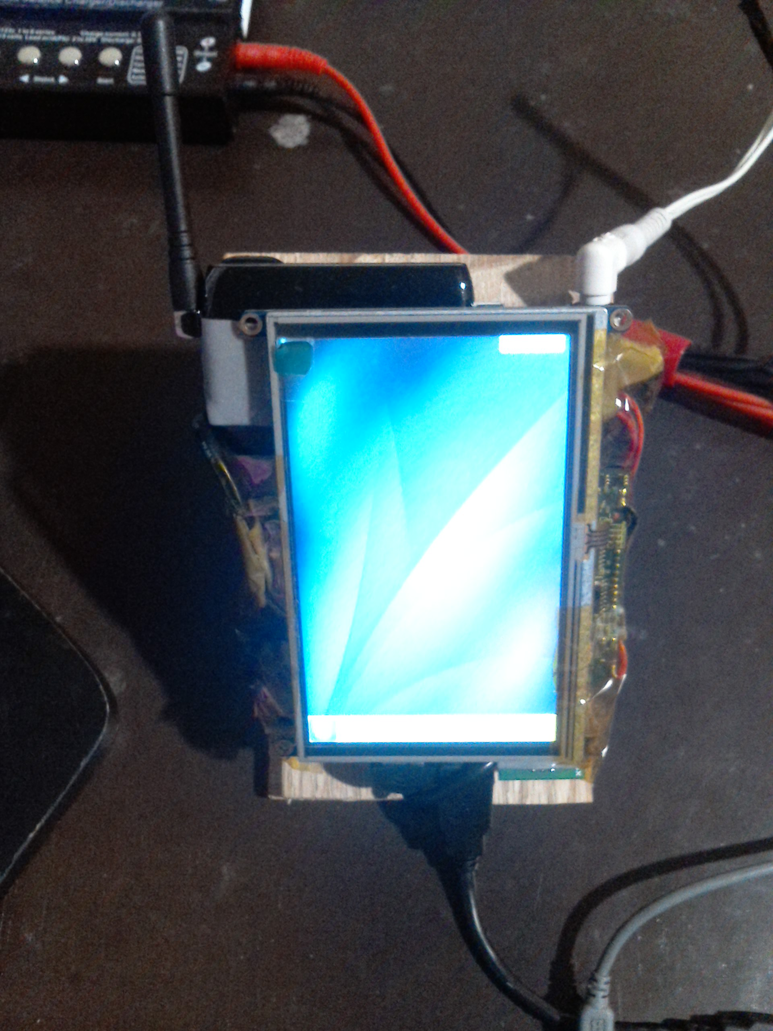
WIN_20161223_085916.JPG
