bobbybudnick/SFS-Mobile-Internet-Device/WIN_20161223_090108.JPG

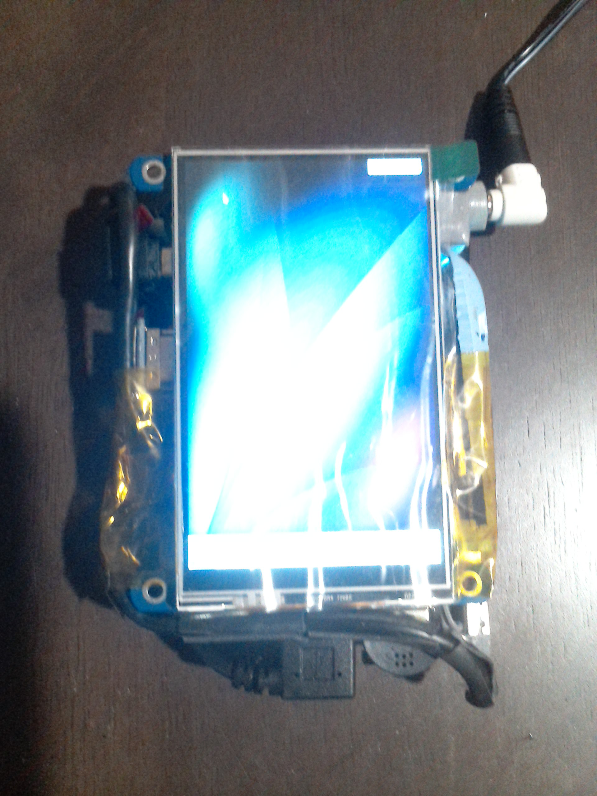
WIN_20161223_090108.JPG
