bobbybudnick/SFS-Mobile-Internet-Device/WIN_20161223_090702.JPG

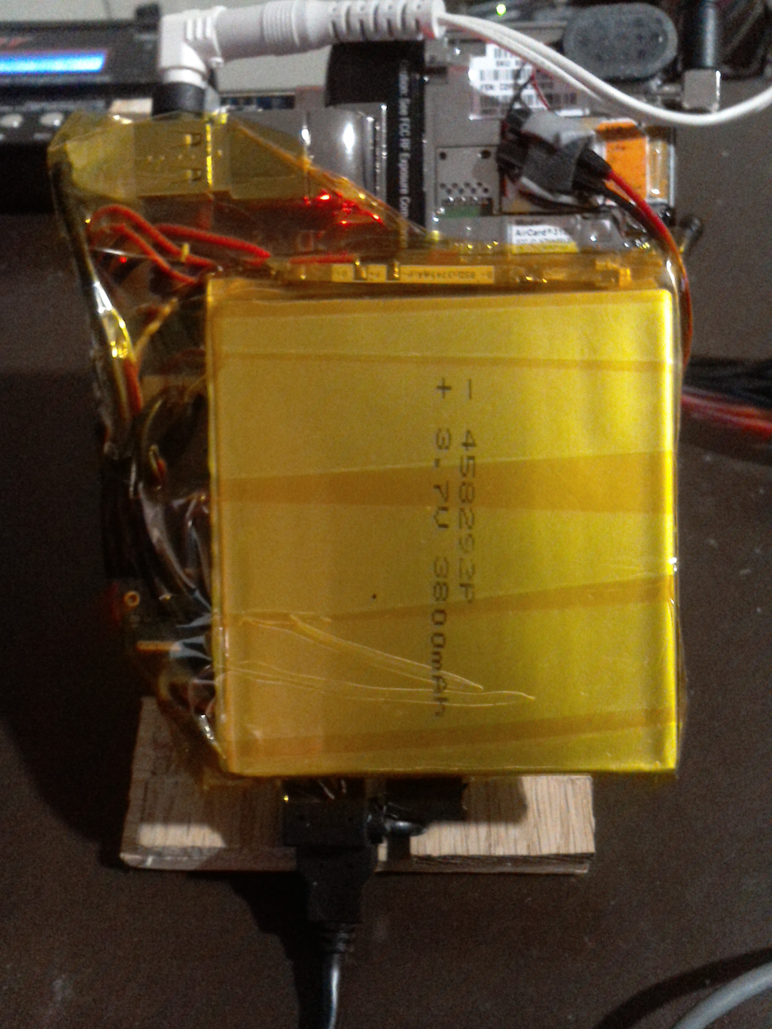
WIN_20161223_090702.JPG
