bobbybudnick/SFS-Mobile-Internet-Device/WIN_20161223_091032.JPG

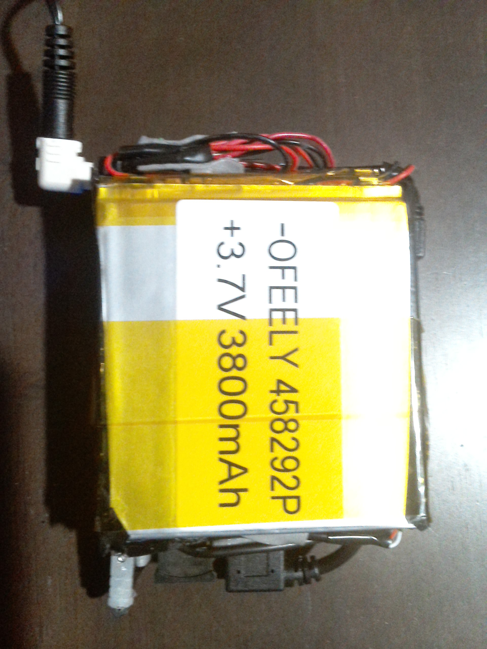
WIN_20161223_091032.JPG
