bobbybudnick/SFS-Mobile-Internet-Device/WIN_20170604_051233.JPG

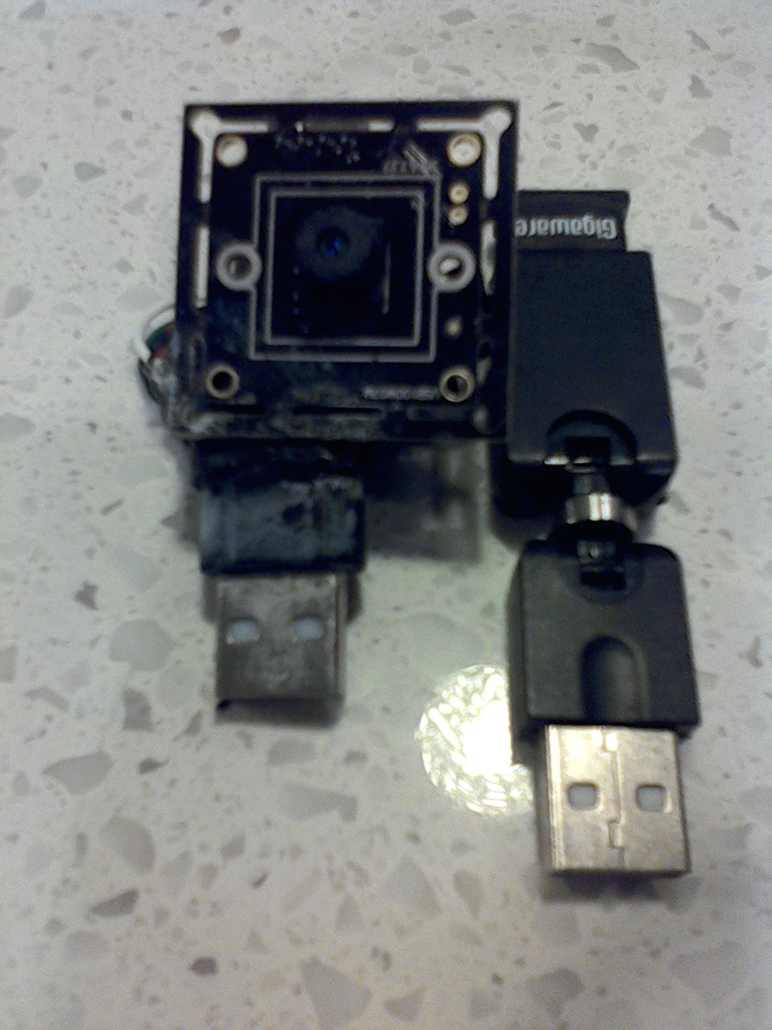
WIN_20170604_051233.JPG
