bobbybudnick/SFS-Mobile-Internet-Device/WIN_20170718_175225.JPG

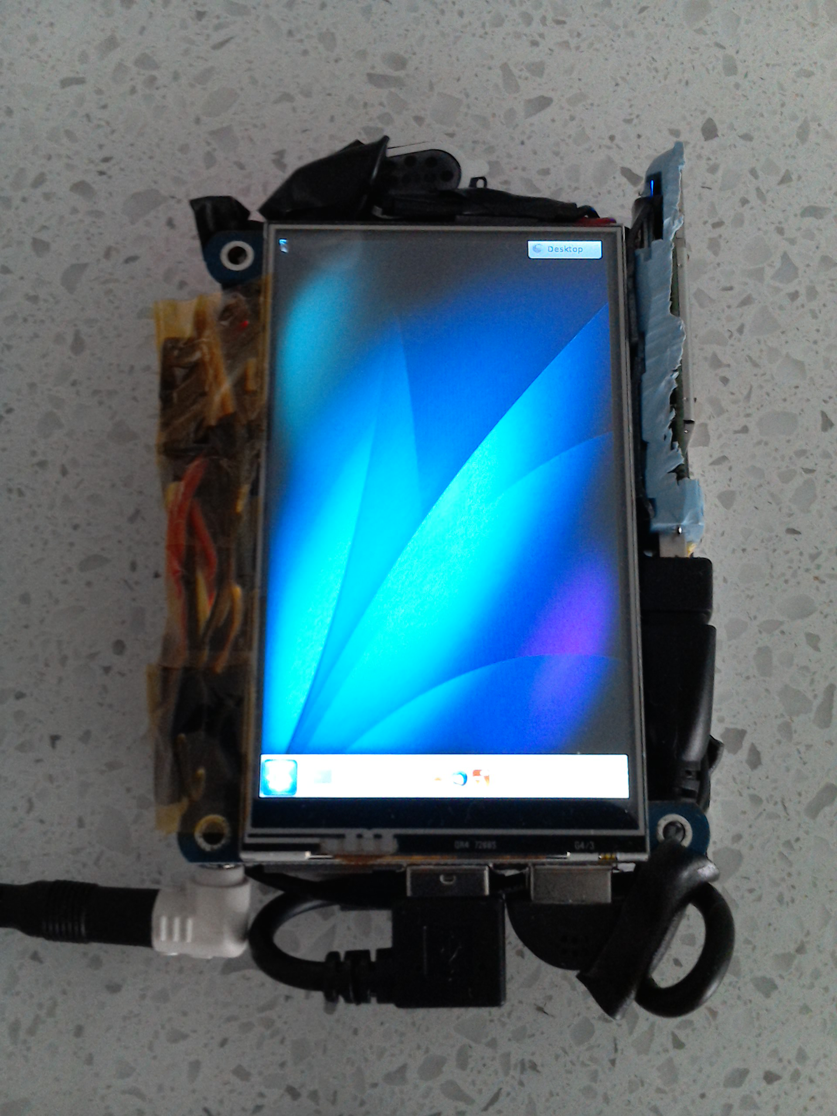
WIN_20170718_175225.JPG
