bobbybudnick/SFS-Mobile-Internet-Device/WIN_20170718_175434.JPG

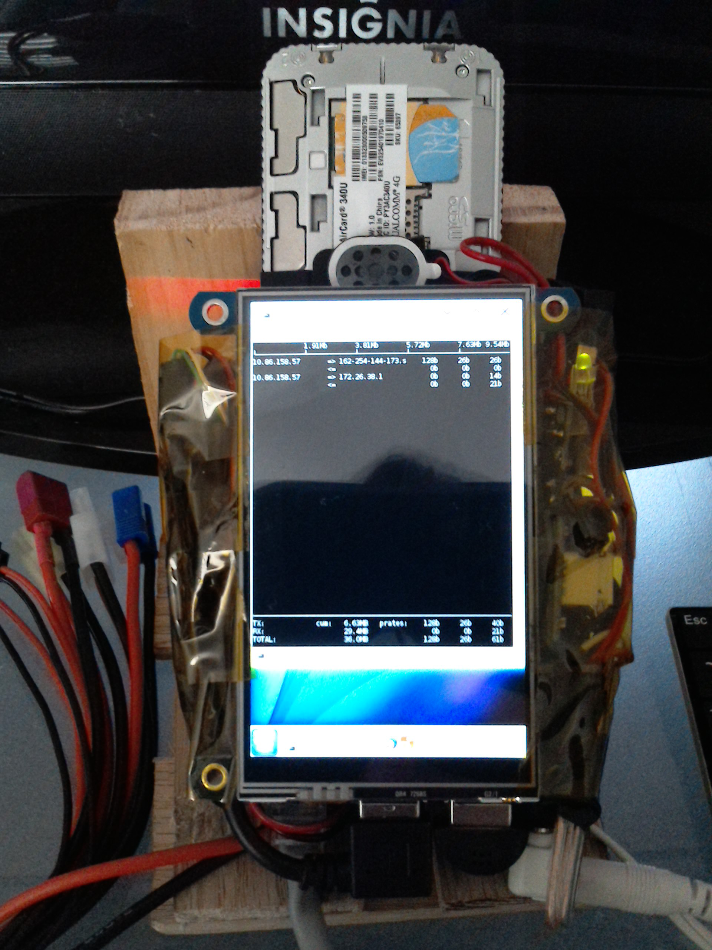
WIN_20170718_175434.JPG
