bobbybudnick/SFS-Mobile-Internet-Device/WIN_20170818_142657.JPG

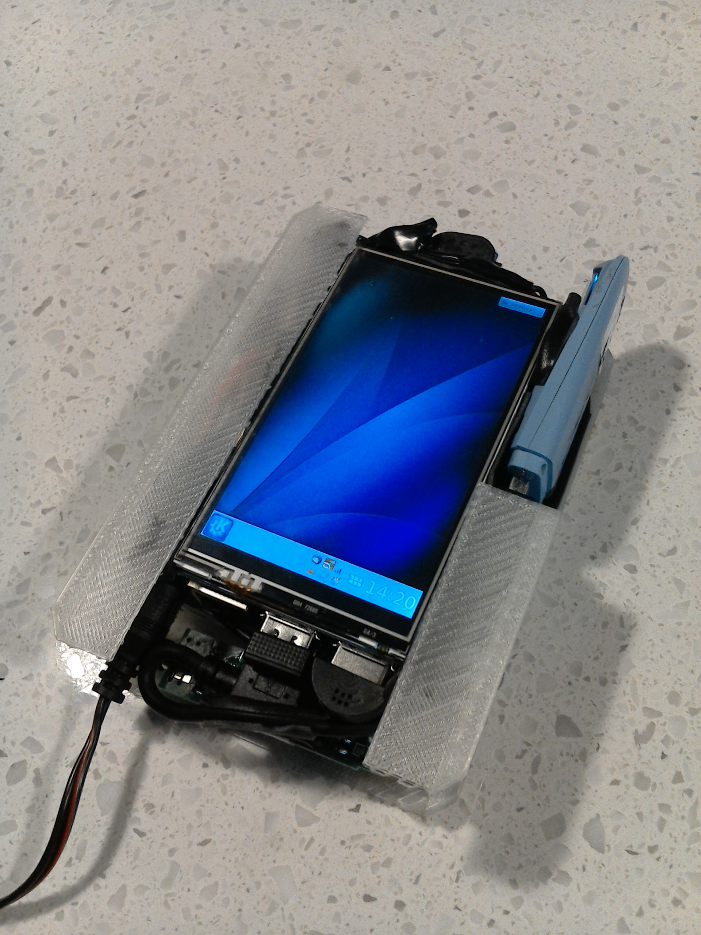
WIN_20170818_142657.JPG
