bobbybudnick/SFS-Mobile-Internet-Device/WIN_20170912_115811.JPG

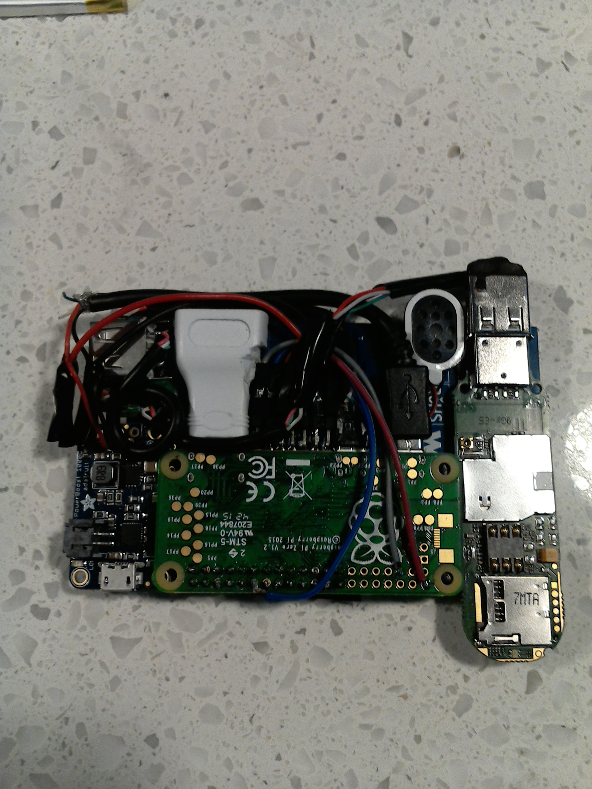
WIN_20170912_115811.JPG
