bobbybudnick/SFS-Mobile-Internet-Device/WIN_20170920_002017.JPG

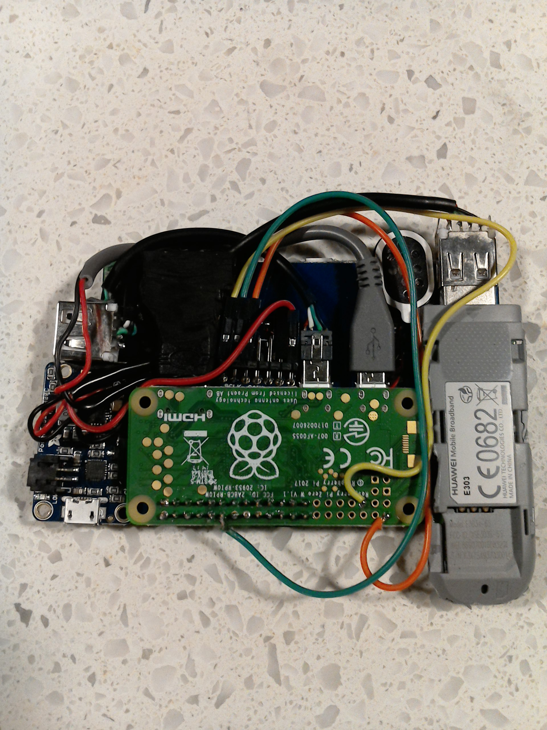
WIN_20170920_002017.JPG
