bobbybudnick/SFS-Mobile-Internet-Device/WIN_20171002_105616.JPG

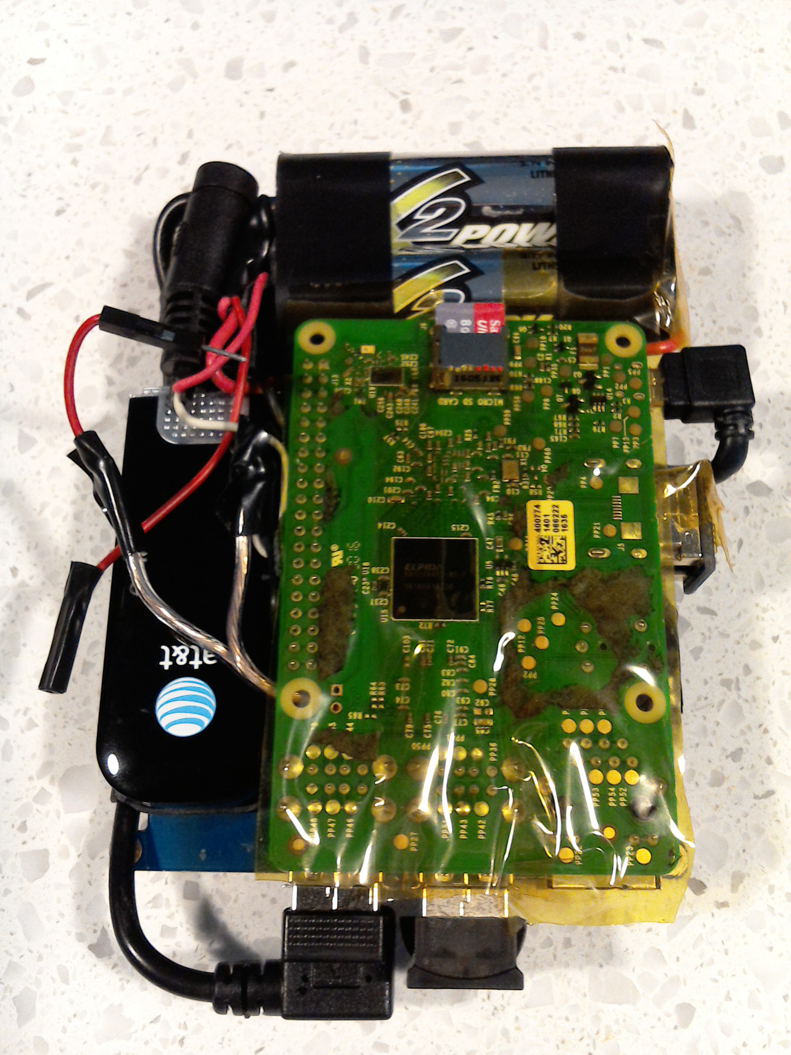
WIN_20171002_105616.JPG
