bobbybudnick/SFS-Mobile-Internet-Device/WIN_20171002_110022.JPG

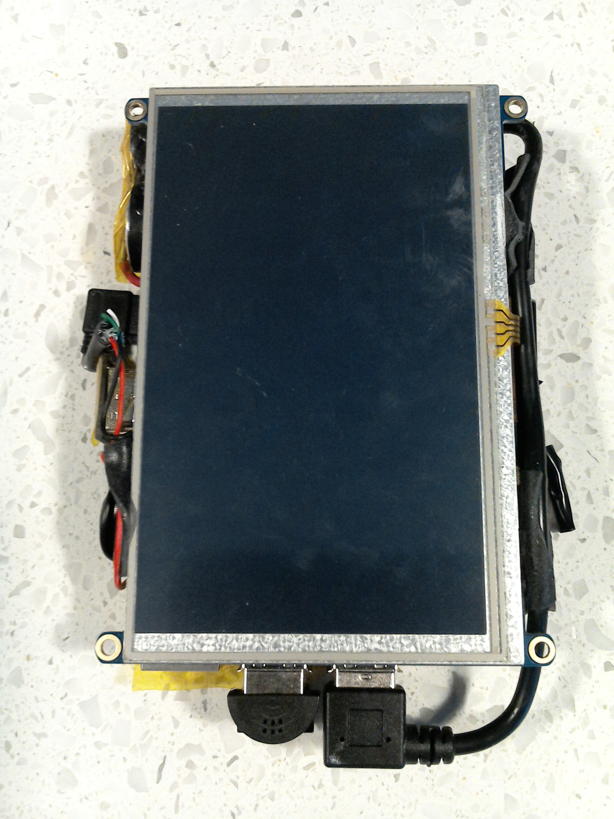
WIN_20171002_110022.JPG
