bobbybudnick/SFS-Mobile-Internet-Device/WIN_20171002_110128.JPG

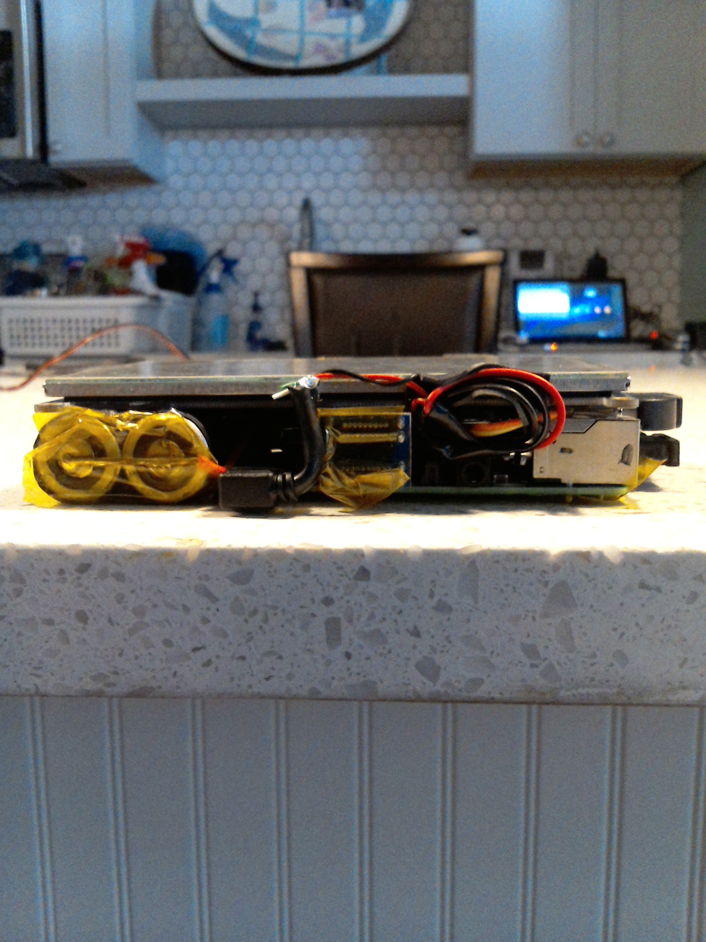
WIN_20171002_110128.JPG
