bobbybudnick/SFS-Mobile-Internet-Device/WIN_20171002_110232.JPG

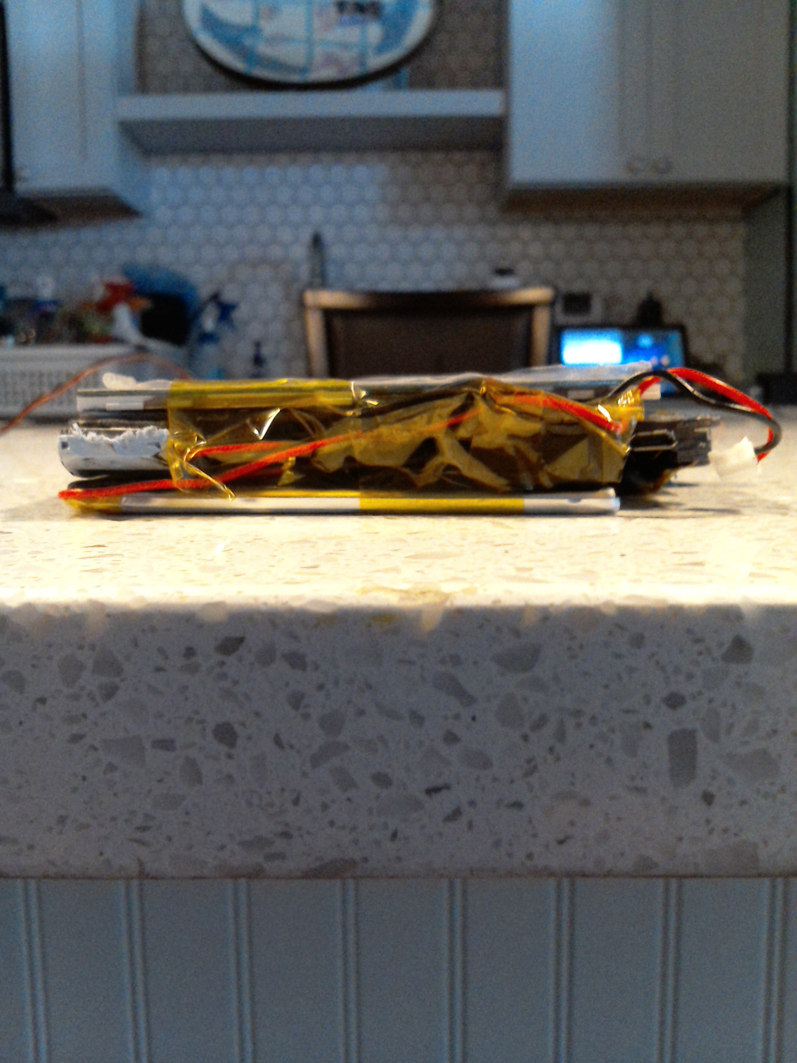
WIN_20171002_110232.JPG
