bobbybudnick/SFS-Mobile-Internet-Device/WIN_20171002_110243.JPG

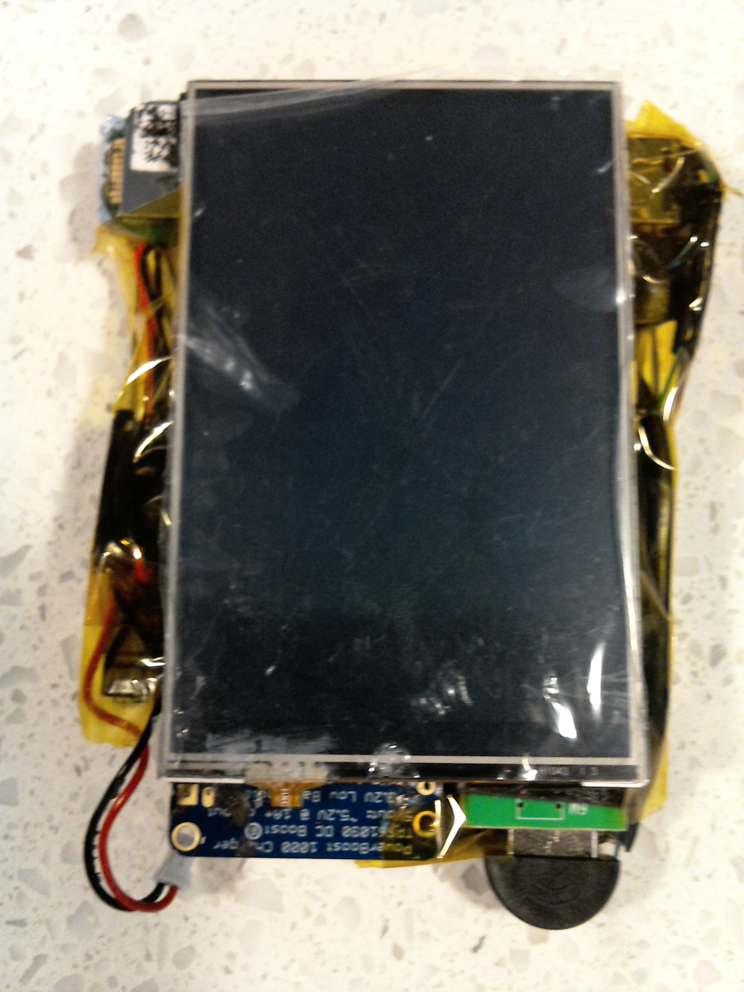
WIN_20171002_110243.JPG
