bobbybudnick/SFS-Mobile-Internet-Device/WIN_20171002_110304.JPG

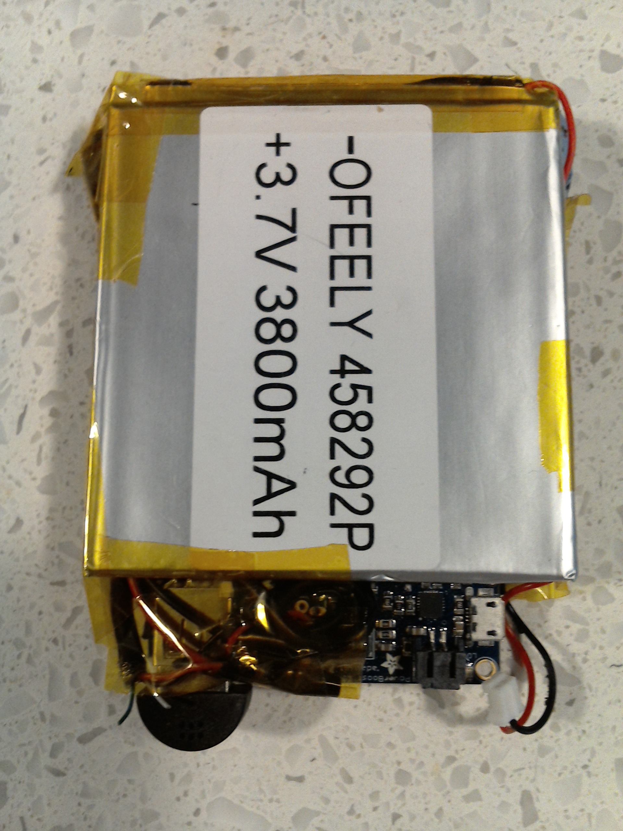
WIN_20171002_110304.JPG
