bobbybudnick/SFS-Mobile-Internet-Device/WIN_20171002_110418.JPG

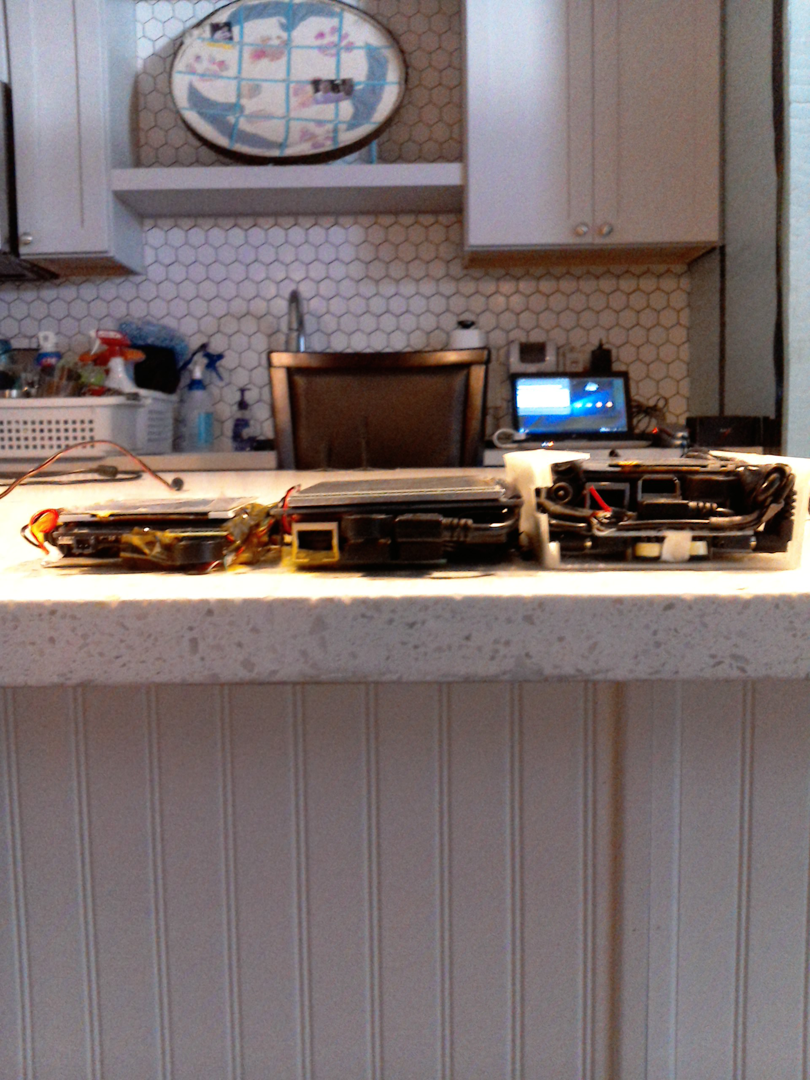
WIN_20171002_110418.JPG
