bobbybudnick/SFS-Mobile-Internet-Device/WIN_20171010_165143.JPG

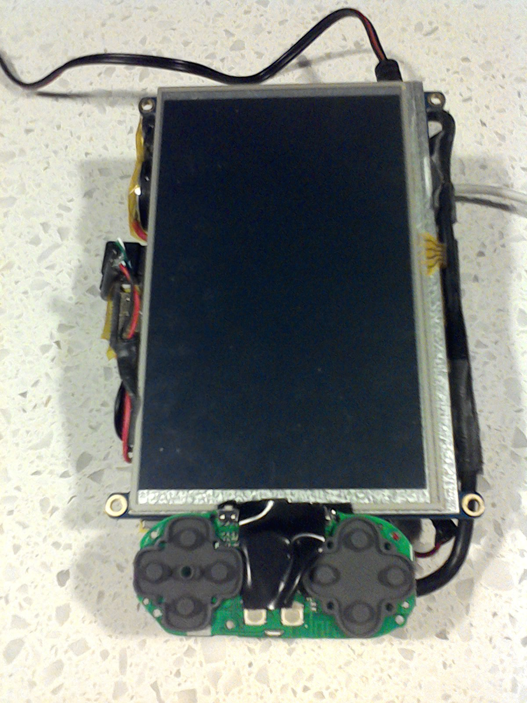
WIN_20171010_165143.JPG
