bobbybudnick/SFS-Mobile-Internet-Device/WIN_20171013_165723.JPG

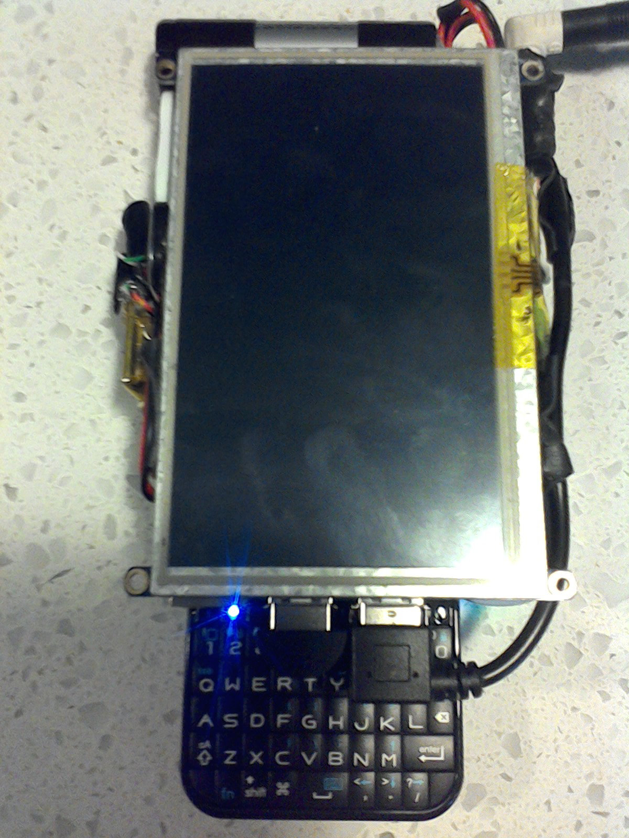
WIN_20171013_165723.JPG
