bobbybudnick/SFS-Mobile-Internet-Device/WIN_20180714_173837.JPG

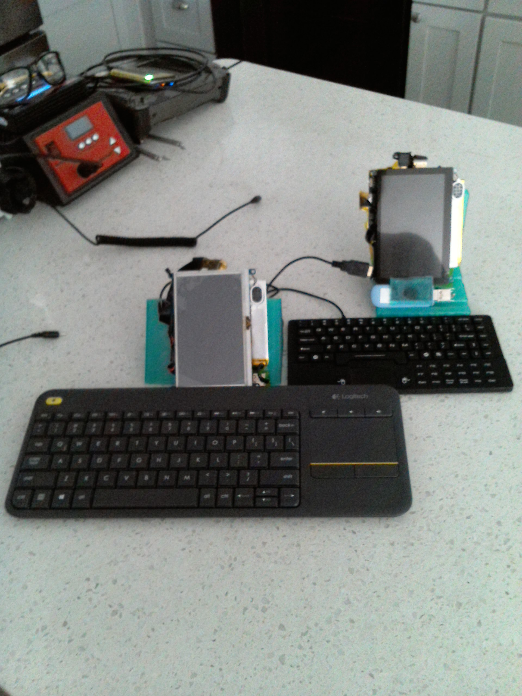
WIN_20180714_173837.JPG
