bobbybudnick/SFS-Mobile-Internet-Device/WIN_20180714_173955.JPG

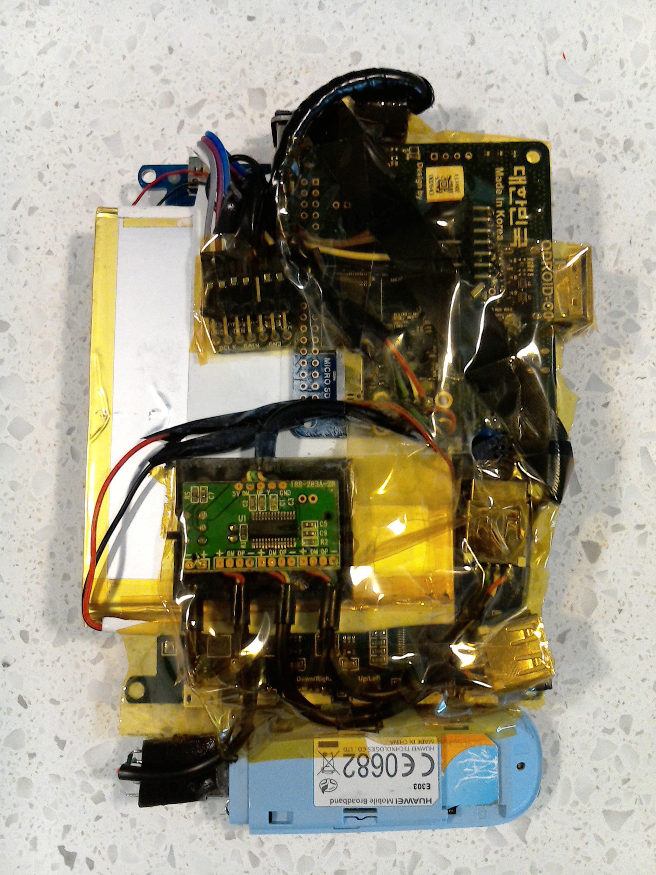
WIN_20180714_173955.JPG
