bobbybudnick/SFS-Mobile-Internet-Device/WIN_20180714_174012.JPG

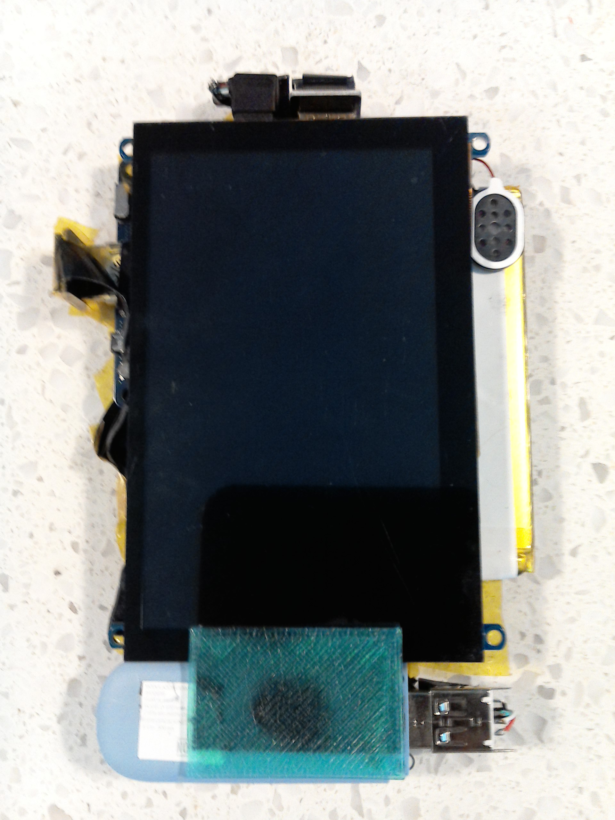
WIN_20180714_174012.JPG
