bobbybudnick/SFS-Mobile-Internet-Device/WIN_20180721_133201.JPG

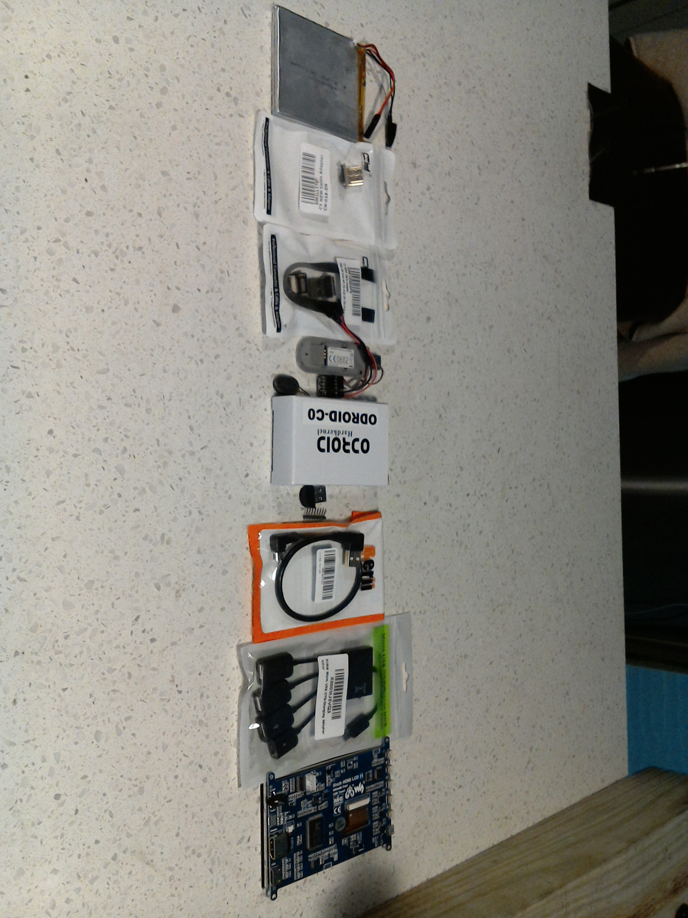
WIN_20180721_133201.JPG
