bobbybudnick/SFS-Mobile-Internet-Device/WIN_20190204_201020.JPG

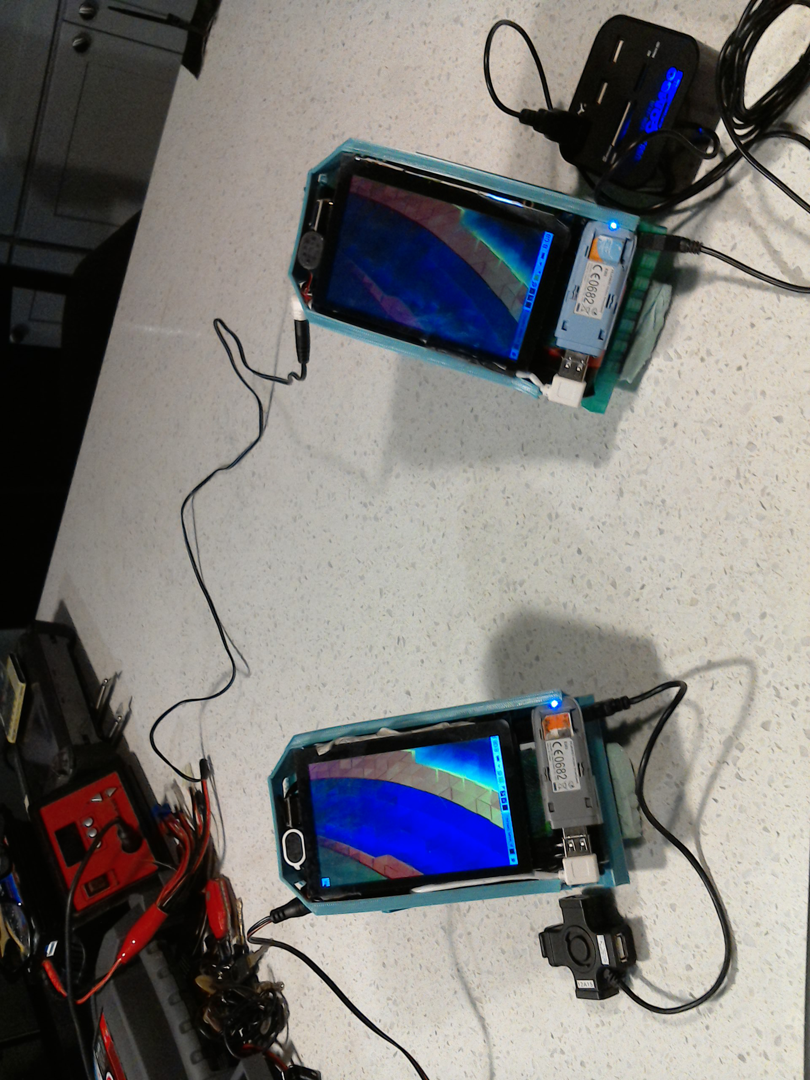
WIN_20190204_201020.JPG
