bobbybudnick/SFS-Mobile-Internet-Device/WIN_20190221_121509.JPG

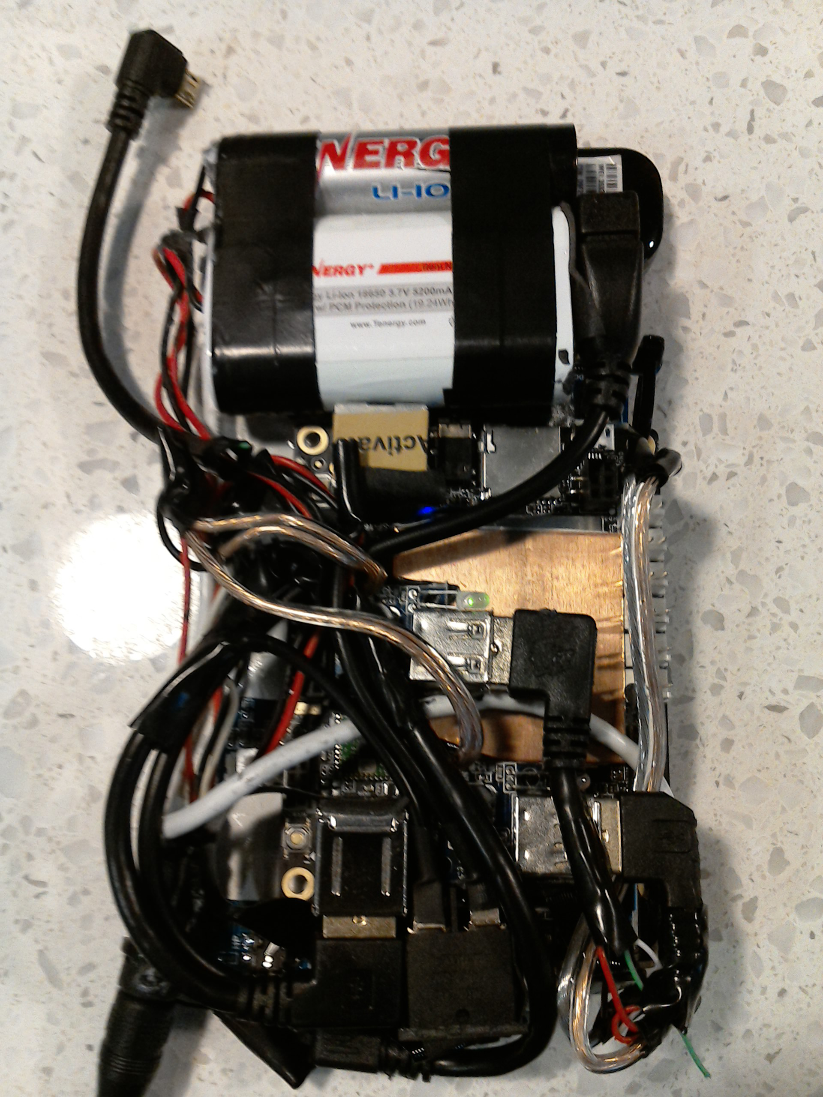
WIN_20190221_121509.JPG
