bobbybudnick/SFS-Mobile-Internet-Device/WIN_20190306_192250.JPG

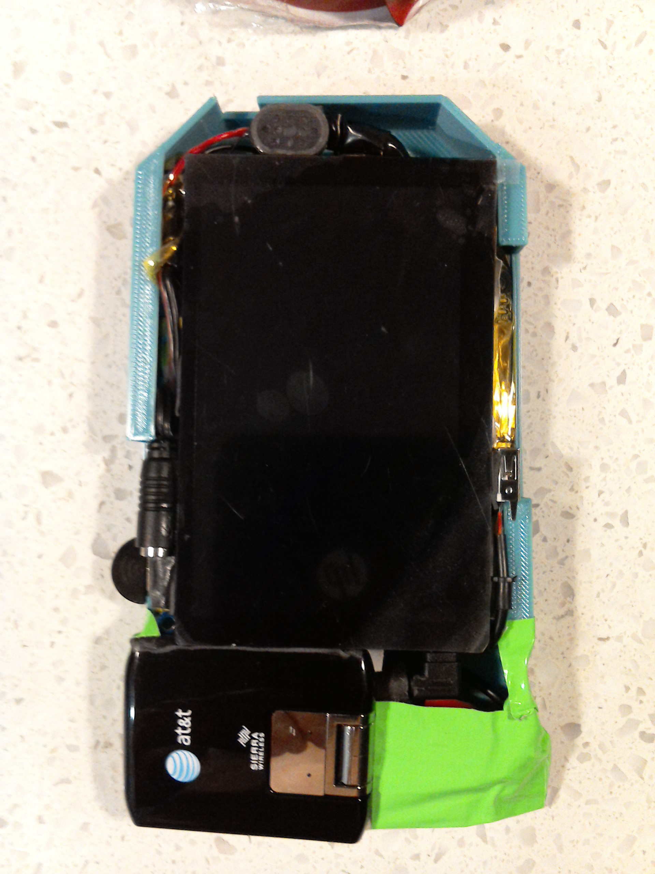
WIN_20190306_192250.JPG
