bobbybudnick/SFS-Mobile-Internet-Device/WIN_20190307_002143.JPG

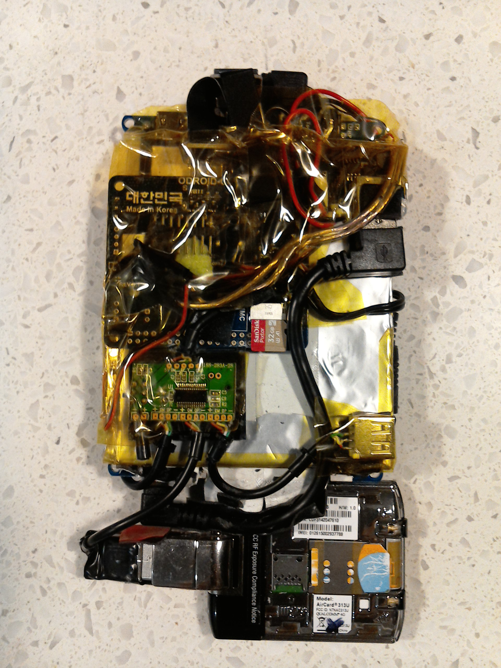
WIN_20190307_002143.JPG
