bobbybudnick/SFS-Mobile-Internet-Device/WIN_20190307_174925.JPG

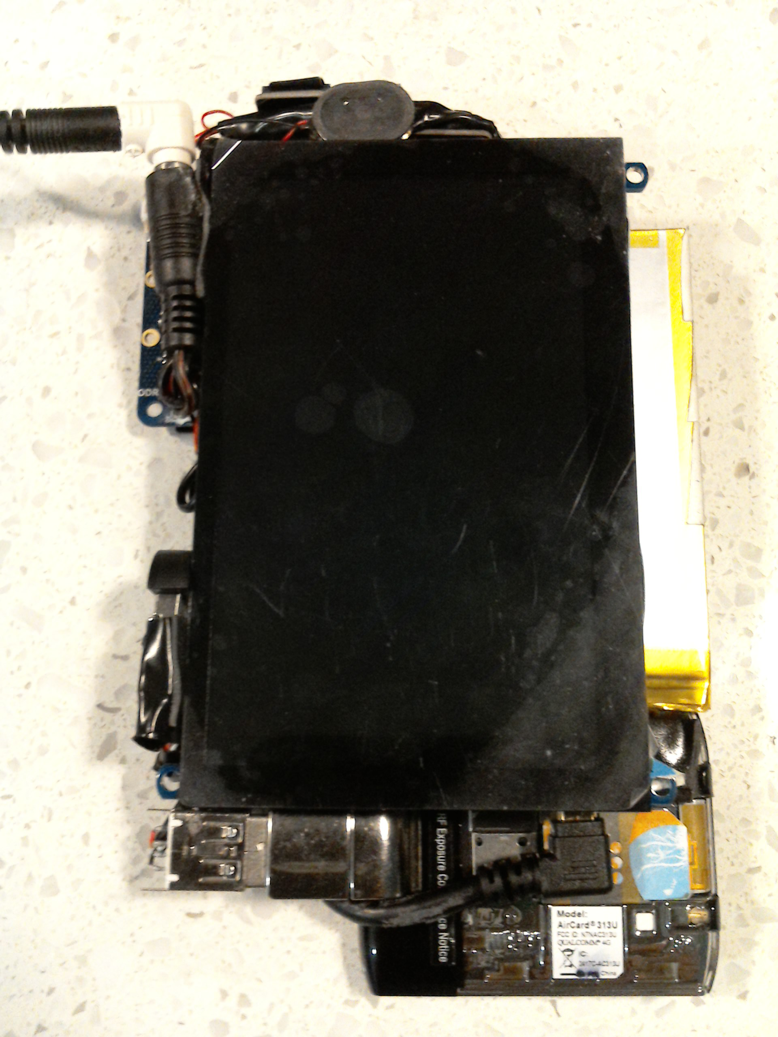
WIN_20190307_174925.JPG
