bobbybudnick/SFS-Mobile-Internet-Device/WIN_20190307_174952.JPG

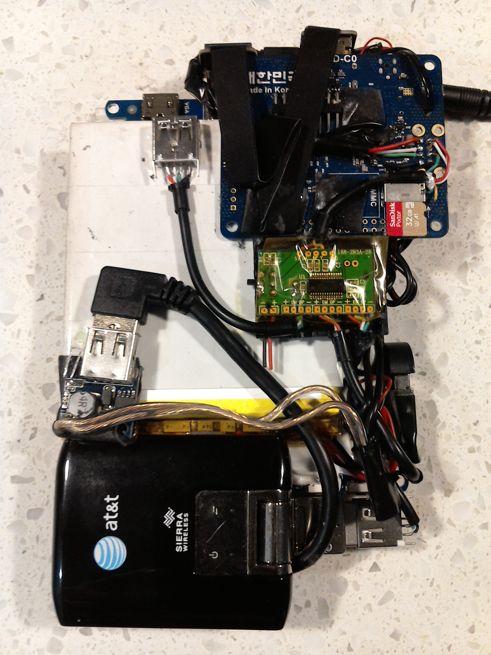
WIN_20190307_174952.JPG
