bobbybudnick/SFS-Mobile-Internet-Device/WIN_20190310_133245.JPG

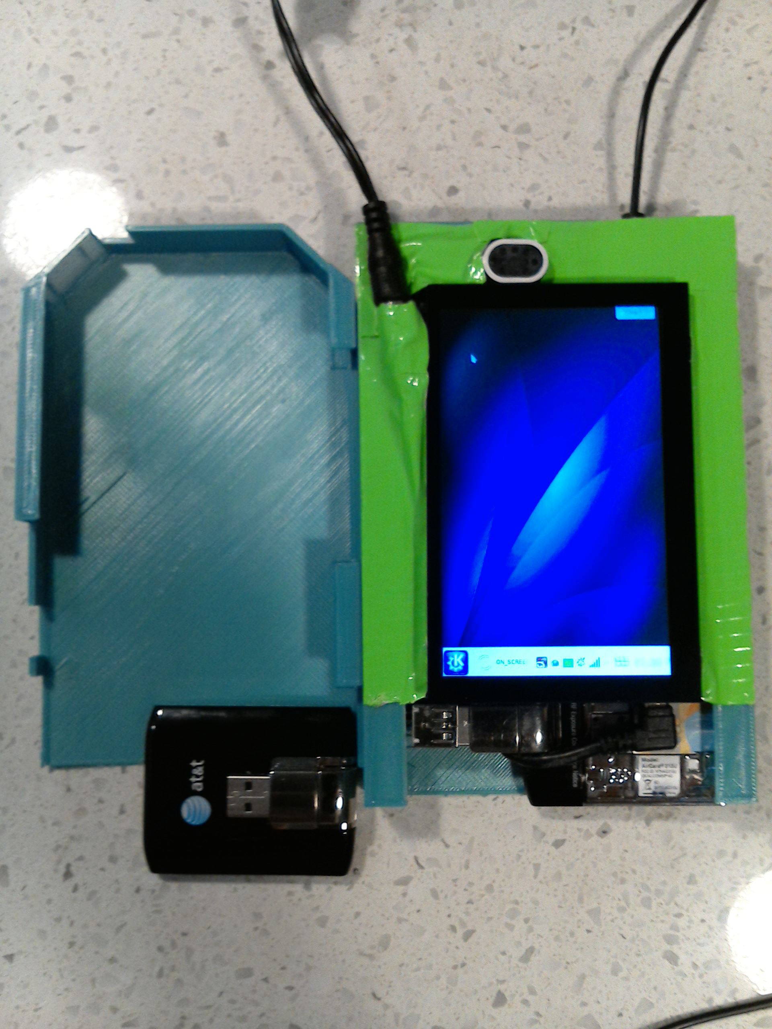
WIN_20190310_133245.JPG
