bobbybudnick/SFS-Mobile-Internet-Device/WIN_20190311_135925.JPG

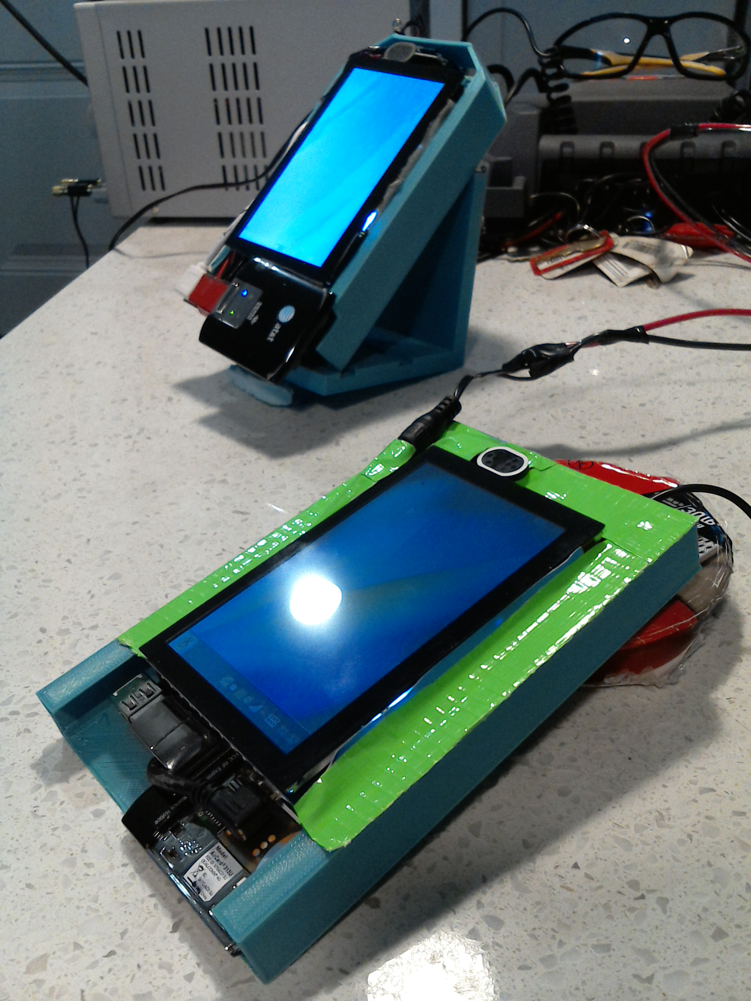
WIN_20190311_135925.JPG
