bobbybudnick/SFS-Mobile-Internet-Device/WIN_20190806_081439.JPG

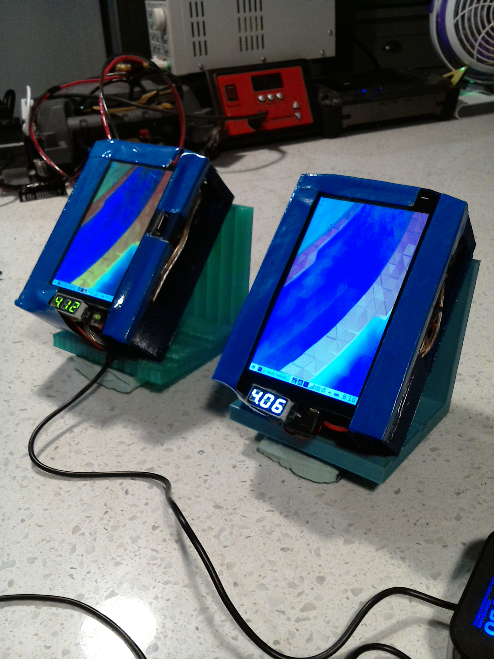
WIN_20190806_081439.JPG
