bobbybudnick/SFS-Mobile-Internet-Device/WIN_20190806_081915.JPG

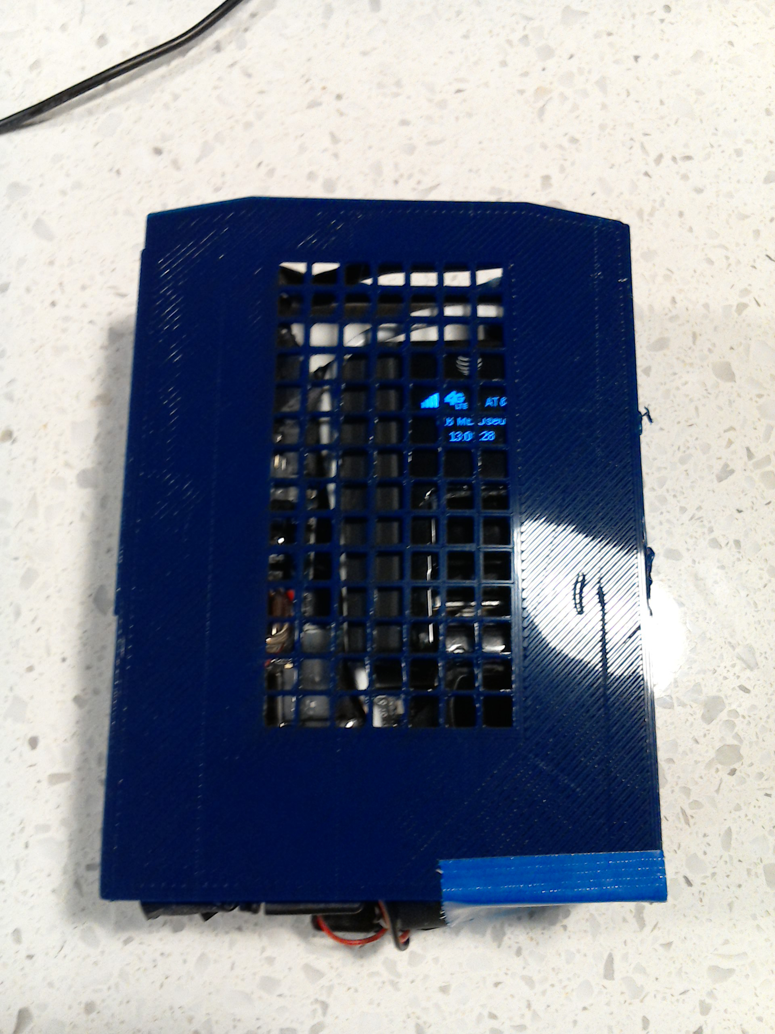
WIN_20190806_081915.JPG
