bobbybudnick/SFS-Mobile-Internet-Device/WIN_20190806_081951.JPG

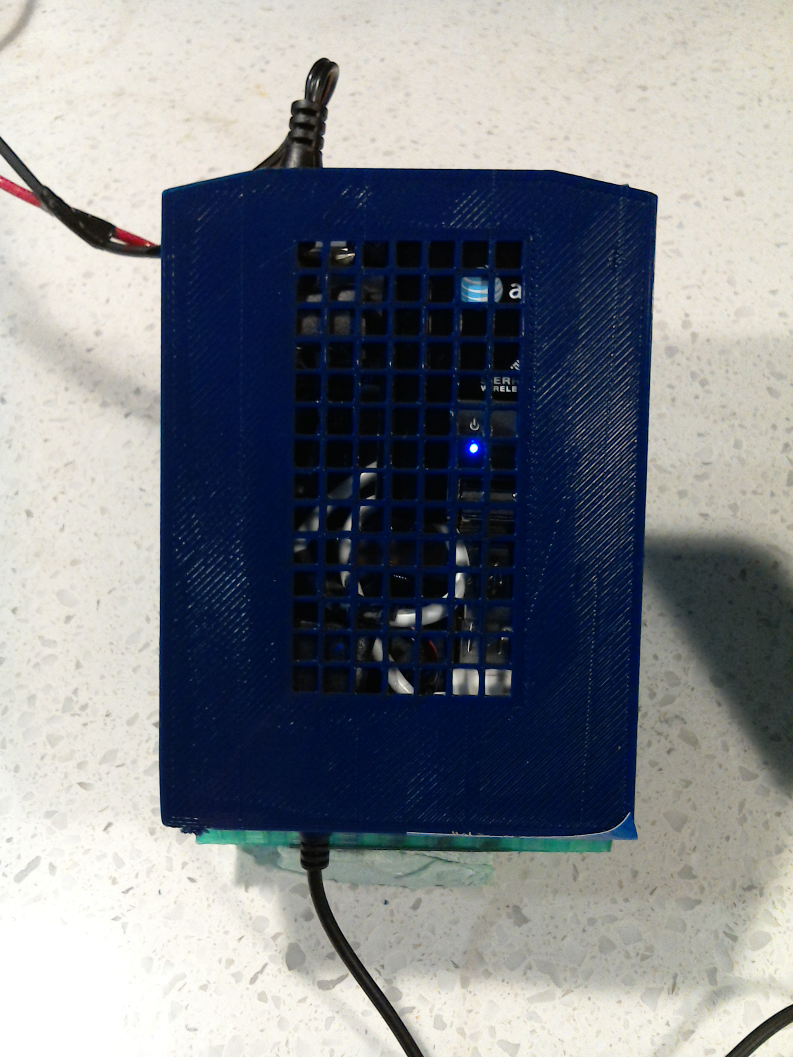
WIN_20190806_081951.JPG
