bobbybudnick/SFS-Mobile-Internet-Device/WIN_20200922_145201.JPG

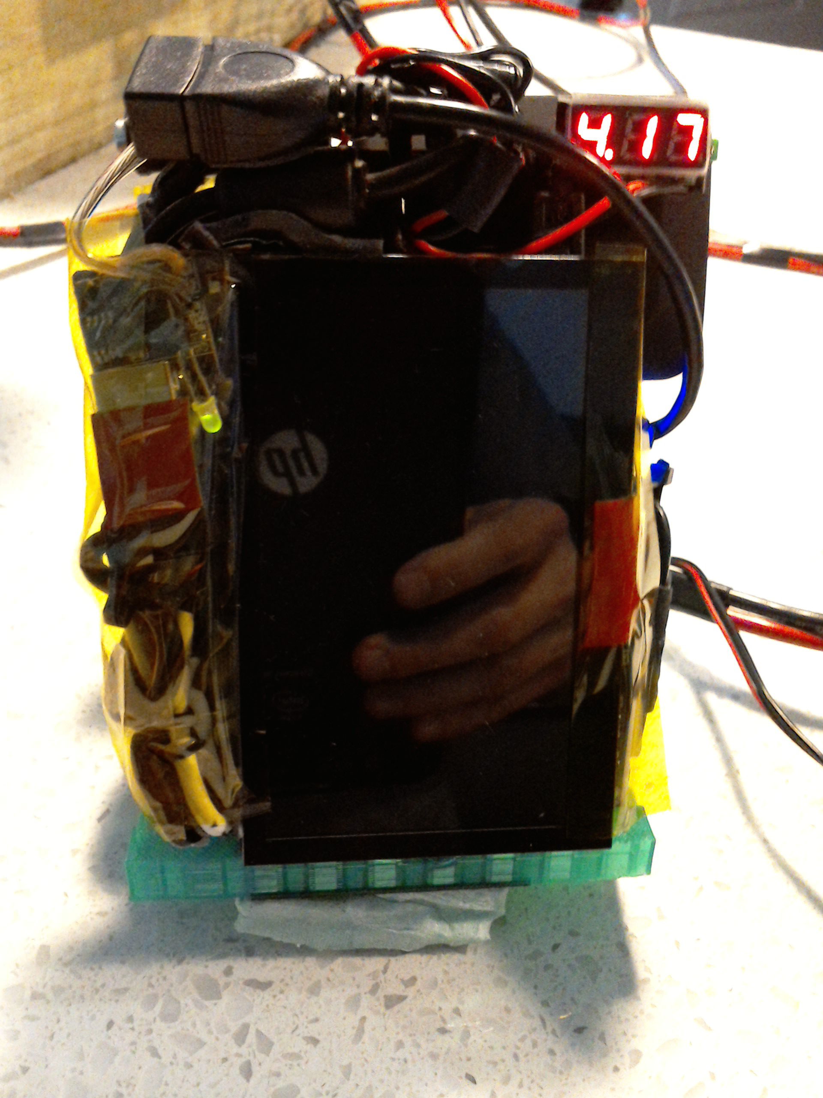
WIN_20200922_145201.JPG
