bobbybudnick/SFS-Mobile-Internet-Device/WIN_20200923_145852.JPG

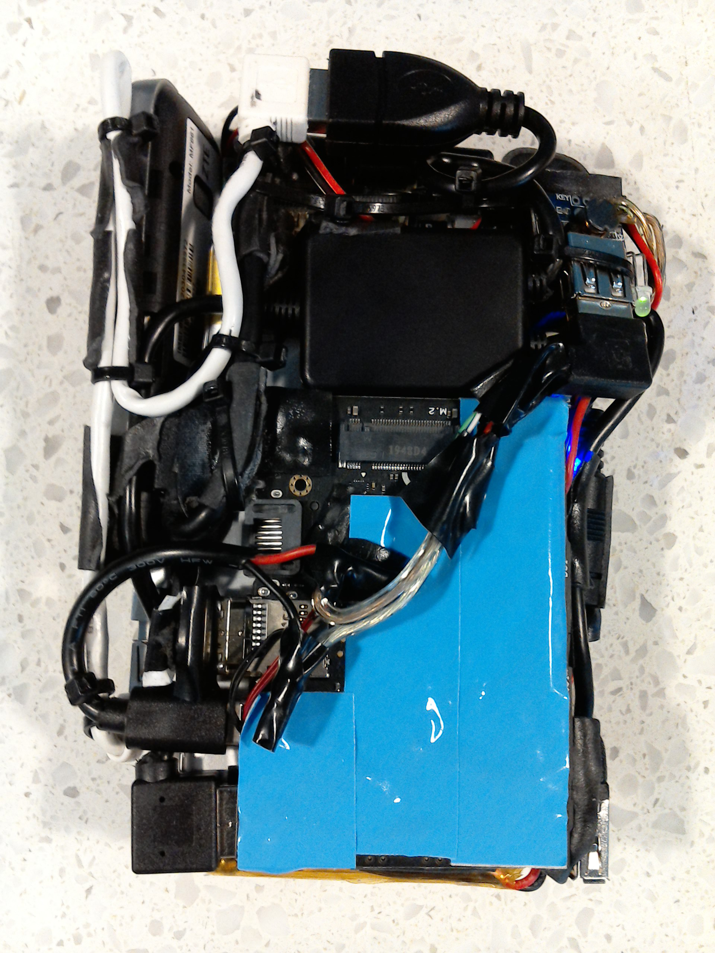
WIN_20200923_145852.JPG
