bobbybudnick/SFS-Mobile-Internet-Device/WIN_20200923_145908.JPG

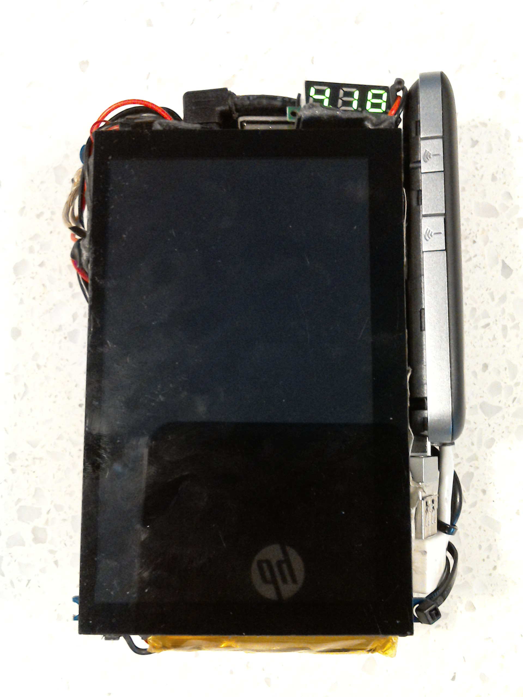
WIN_20200923_145908.JPG
