bobbybudnick/SFS-Mobile-Internet-Device/WIN_20200925_004045.JPG

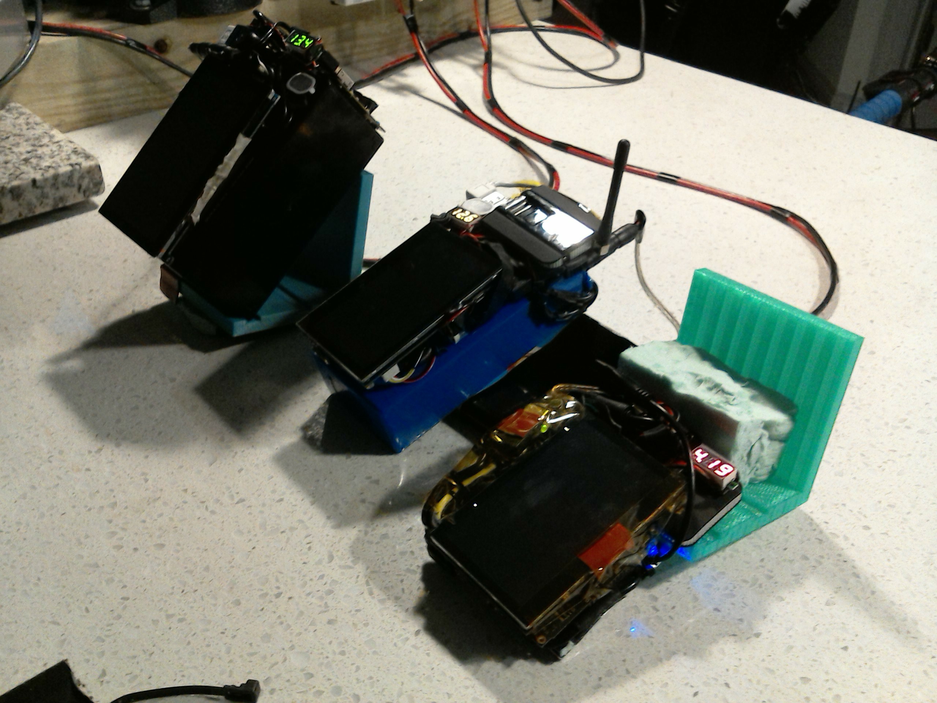
WIN_20200925_004045.JPG
