bobbybudnick/SFS-Mobile-Internet-Device/WIN_20200925_004627.JPG

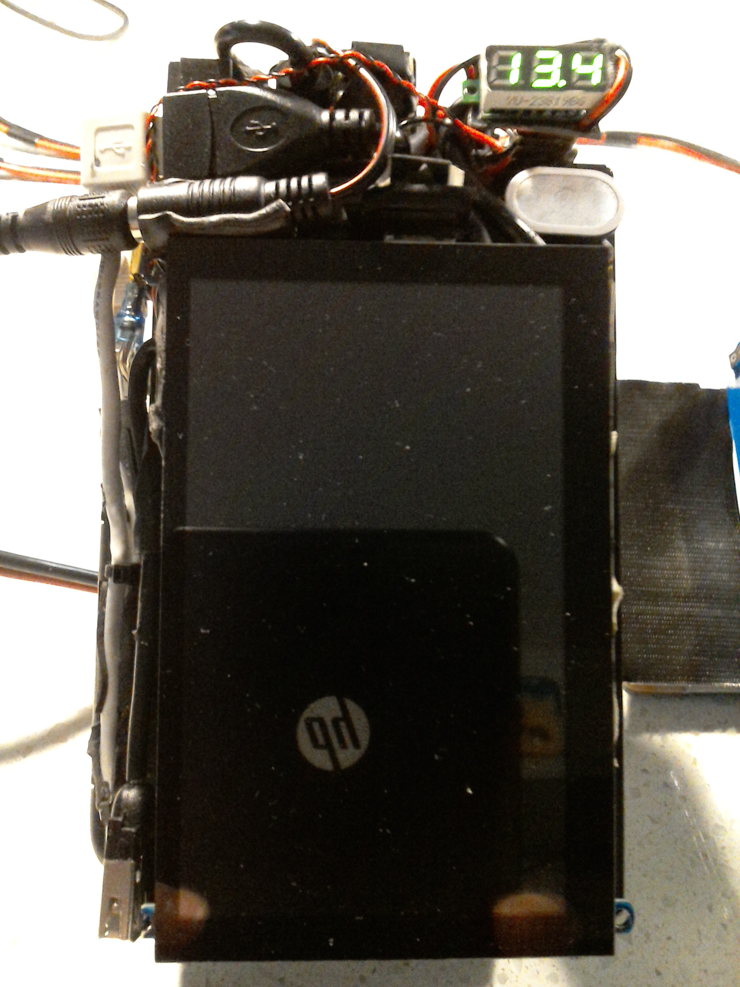
WIN_20200925_004627.JPG
