bobbybudnick/SFS-Mobile-Internet-Device/WIN_20201012_180020.JPG

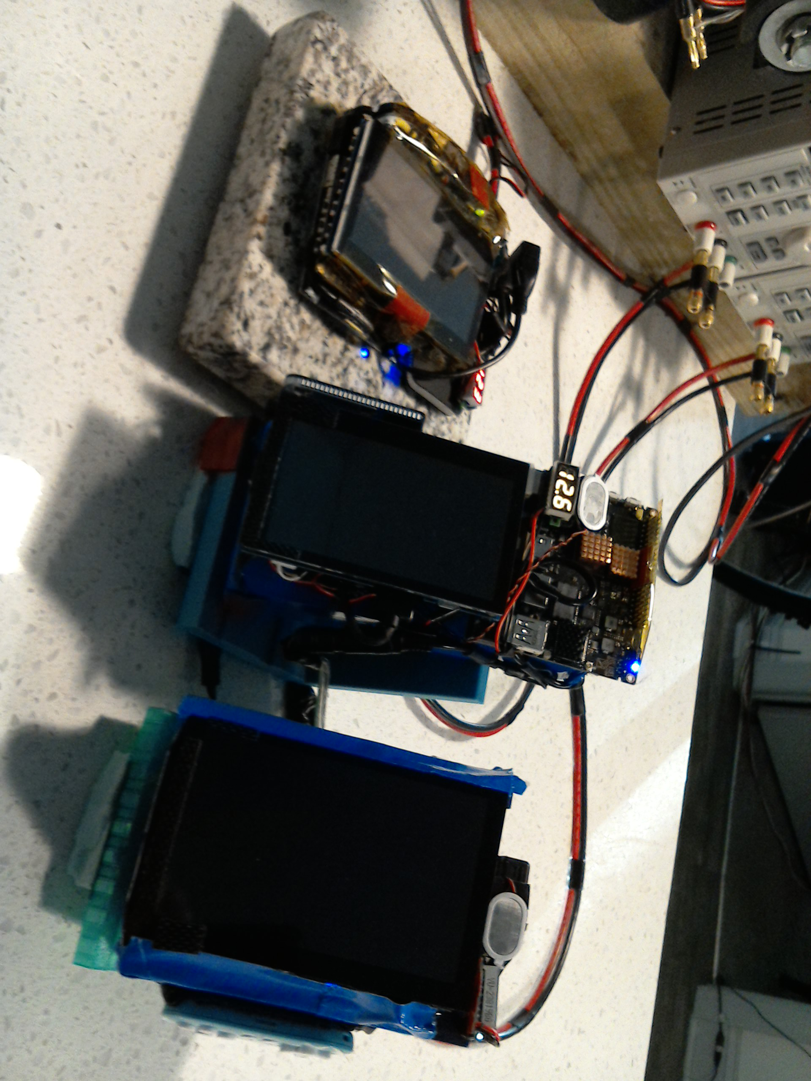
WIN_20201012_180020.JPG
