bobbybudnick/SFS-Mobile-Internet-Device/WIN_20201012_180219.JPG

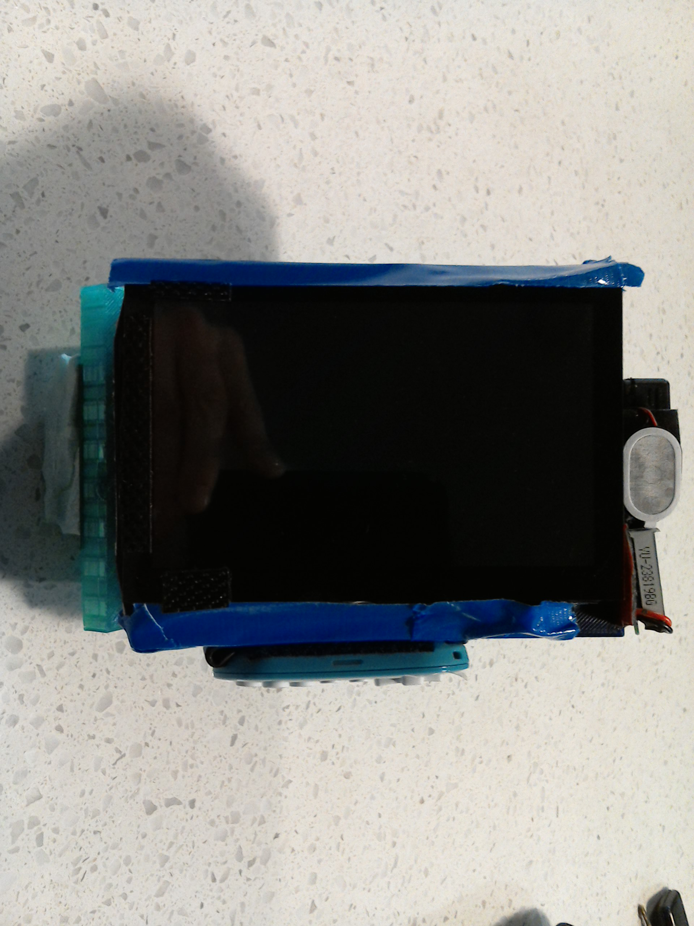
WIN_20201012_180219.JPG
