bobbybudnick/SFS-Mobile-Internet-Device/WIN_20210915_121535.JPG

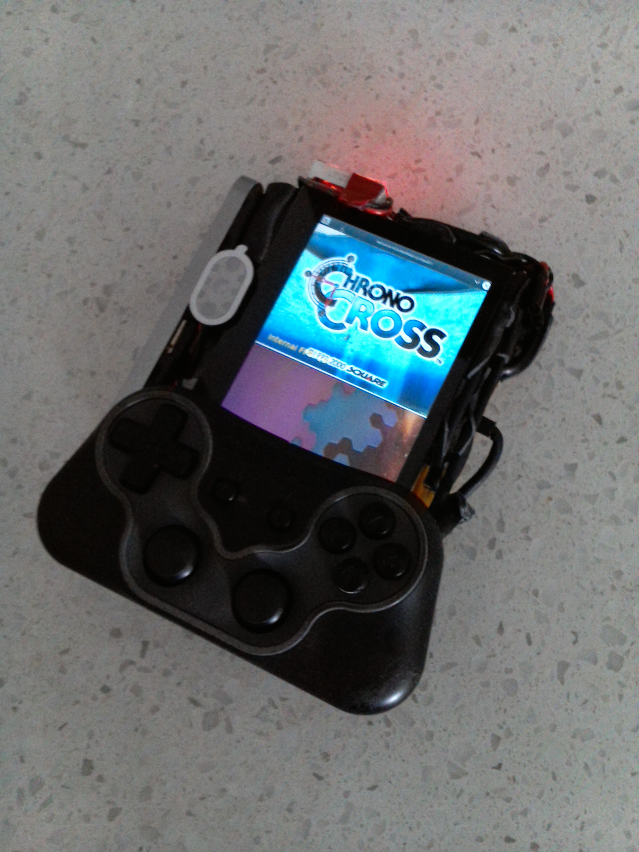
WIN_20210915_121535.JPG
