bobbybudnick/SFS-Mobile-Internet-Device/WIN_20210915_123304.JPG

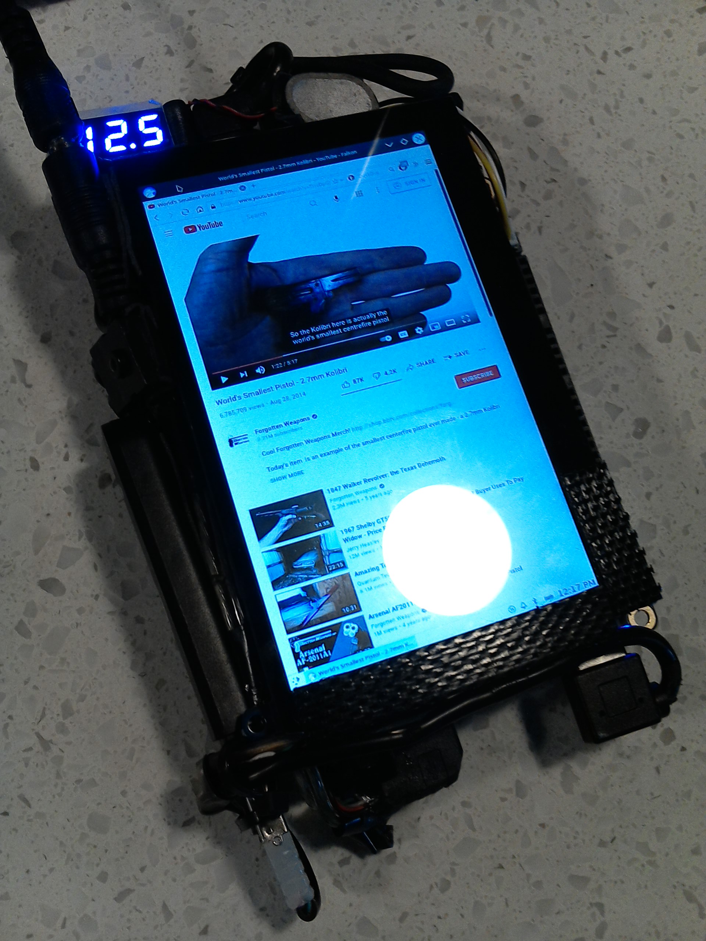
WIN_20210915_123304.JPG
