bobbybudnick/SFS-Mobile-Internet-Device/WIN_20210915_123852.JPG

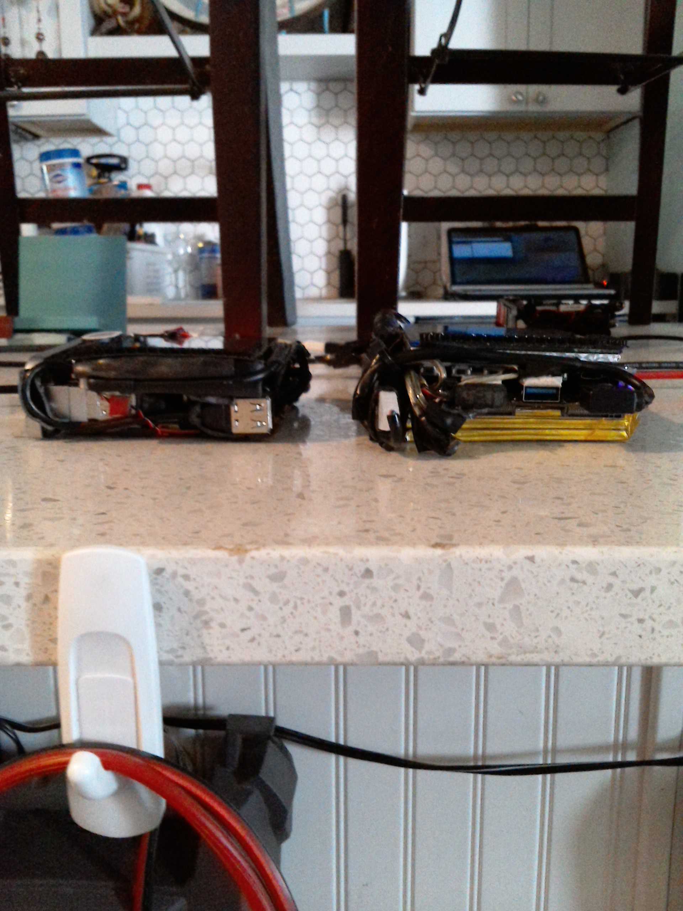
WIN_20210915_123852.JPG
