bobbybudnick/SFS-Mobile-Internet-Device/WIN_20210915_124346.JPG

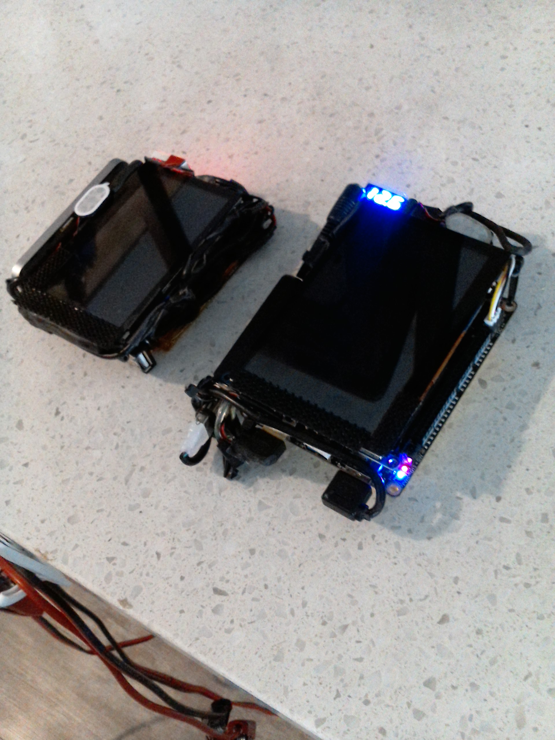
WIN_20210915_124346.JPG
