bobbybudnick/SFS-Mobile-Internet-Device/WIN_20210920_110715.JPG

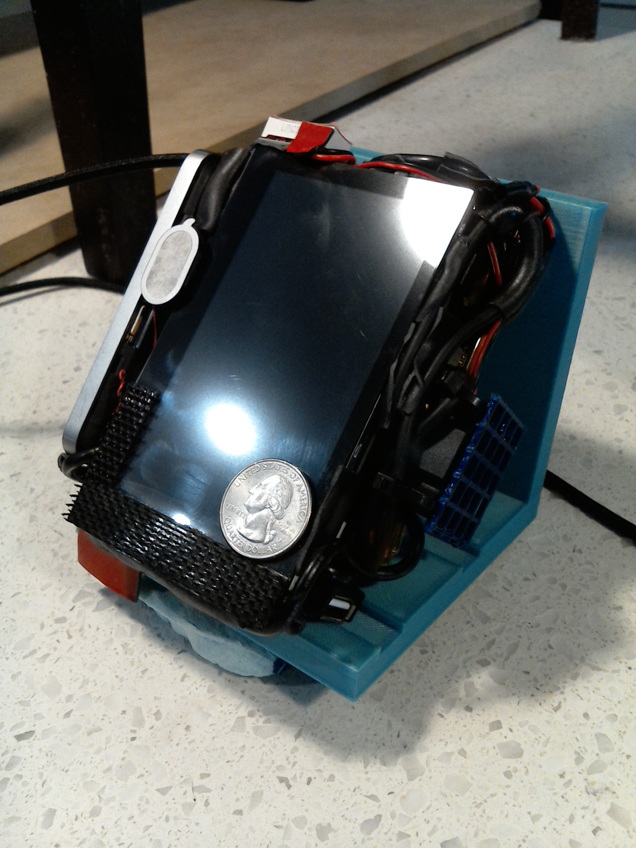
WIN_20210920_110715.JPG
