bobbybudnick/SFS-Mobile-Internet-Device/Shell-15-1.stl

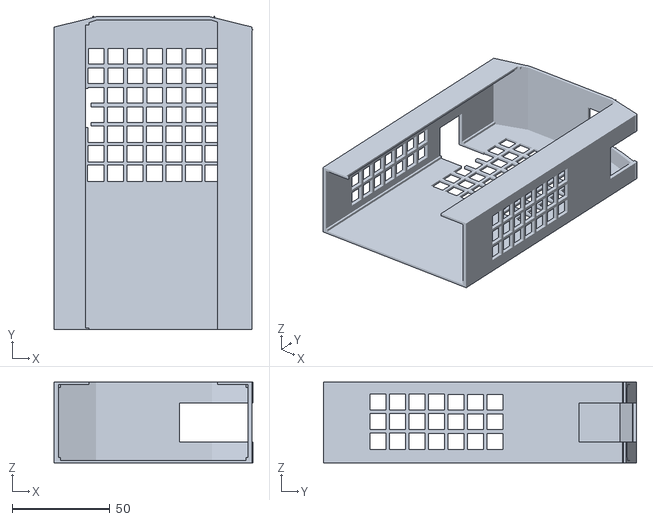
[picture p90: CAD file, 2022-11-30]
Shell-15-1.stl
101.6 x 160.0 x 41.4
