bobbybudnick/SFS-Mobile-Internet-Device/Shell-14-4.stl

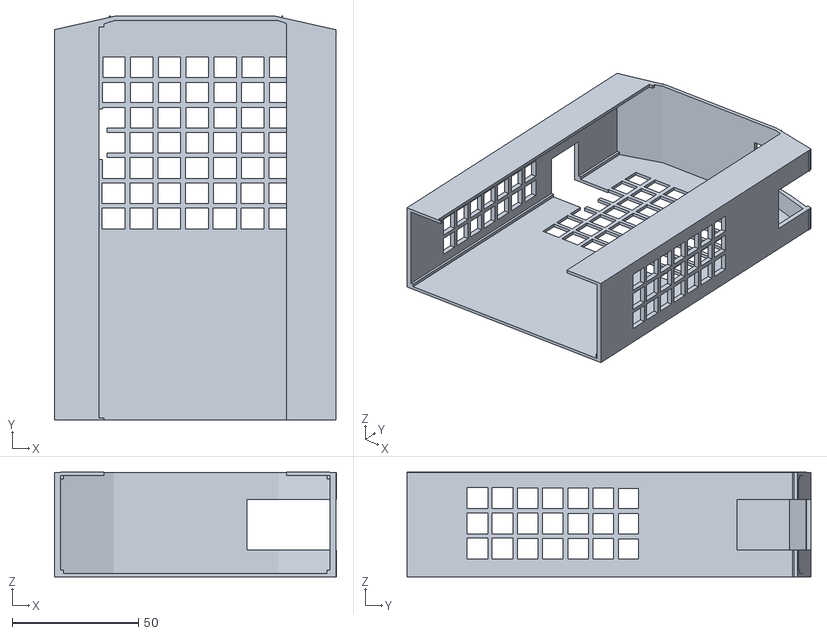
[picture p91: CAD file, 2022-11-30]
Shell-14-4.stl
111.8 x 160.0 x 41.4
