bobbybudnick/SFS-Mobile-Internet-Device/Shell-9-3.stl

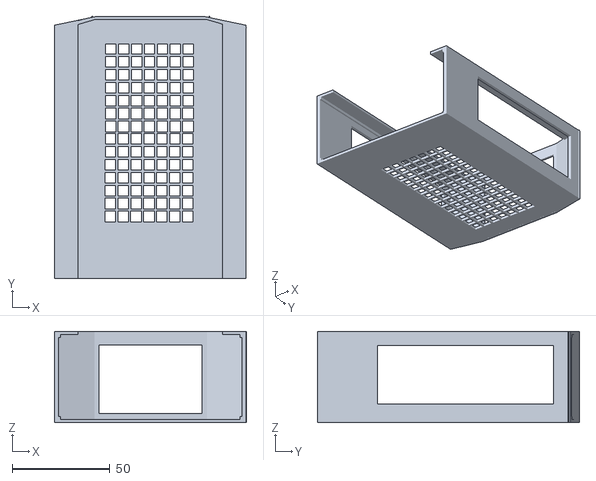
[picture p92: CAD file, 2019-08-04]
Shell-9-3.stl
98.3 x 133.9 x 46.6
