bobbybudnick/SFS-Mobile-Internet-Device/Shell-5-3.stl

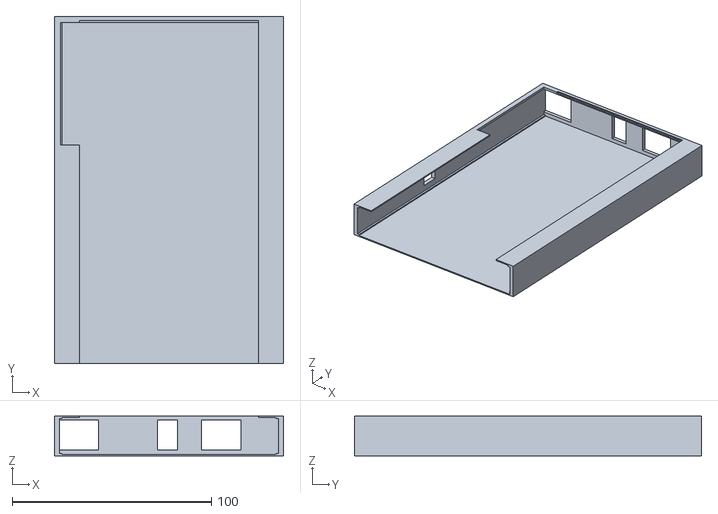
[picture p93: CAD file, 2019-03-11]
Shell-5-3.stl
115.0 x 174.5 x 20.0
