bobbybudnick/SFS-Mobile-Internet-Device/Shell-4-2.stl

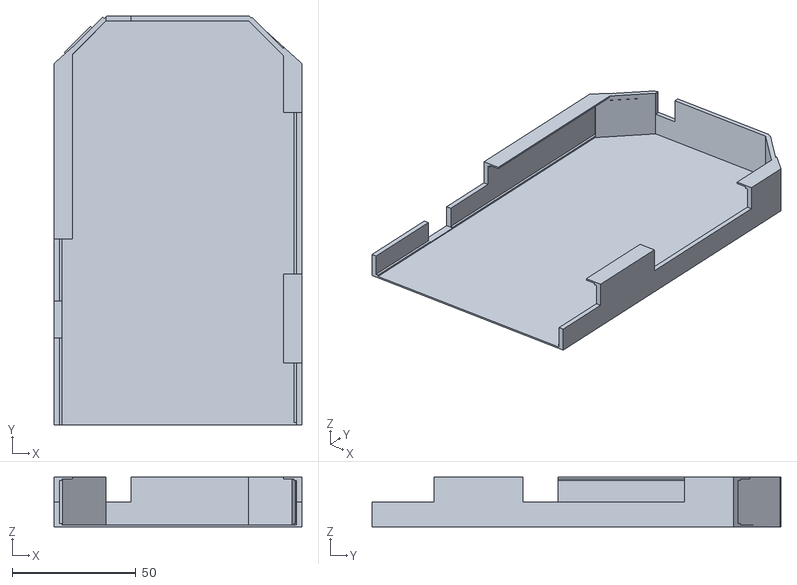
[picture p94: CAD file, 2019-03-11]
Shell-4-2.stl
100.0 x 165.0 x 20.0
