bobbybudnick/SFS-Mobile-Internet-Device/Shell-3-3.stl

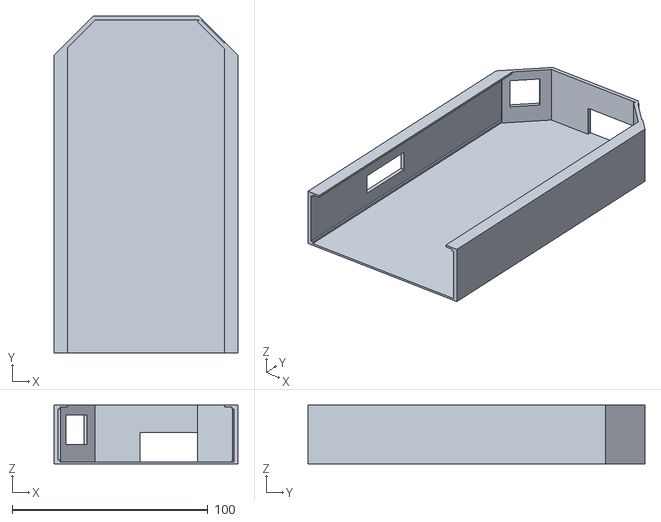
[picture p95: CAD file, 2019-02-04]
Shell-3-3.stl
94.0 x 172.0 x 30.0
