bobbybudnick/SFS-Mobile-Internet-Device/FLASHLIGHT_WIRING.jpg

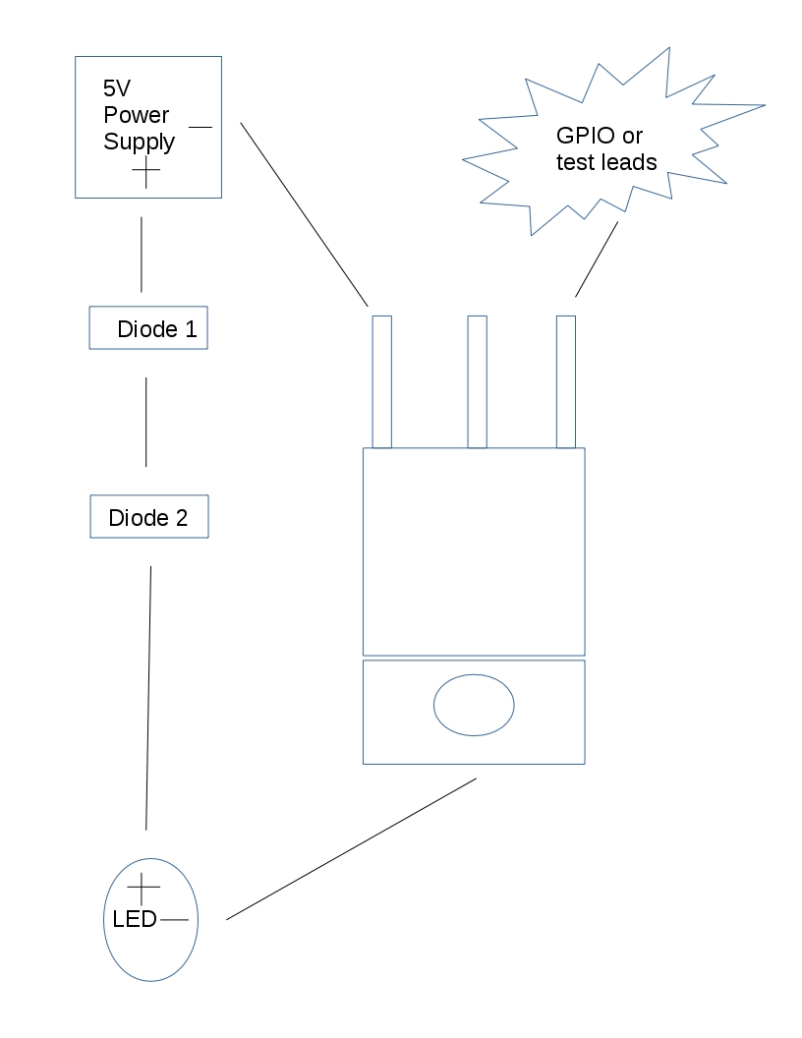
FLASHLIGHT_WIRING.jpg
