bobbybudnick/SFS-Mobile-Internet-Device/POWER_ASSEMBLY_WIRING.jpg

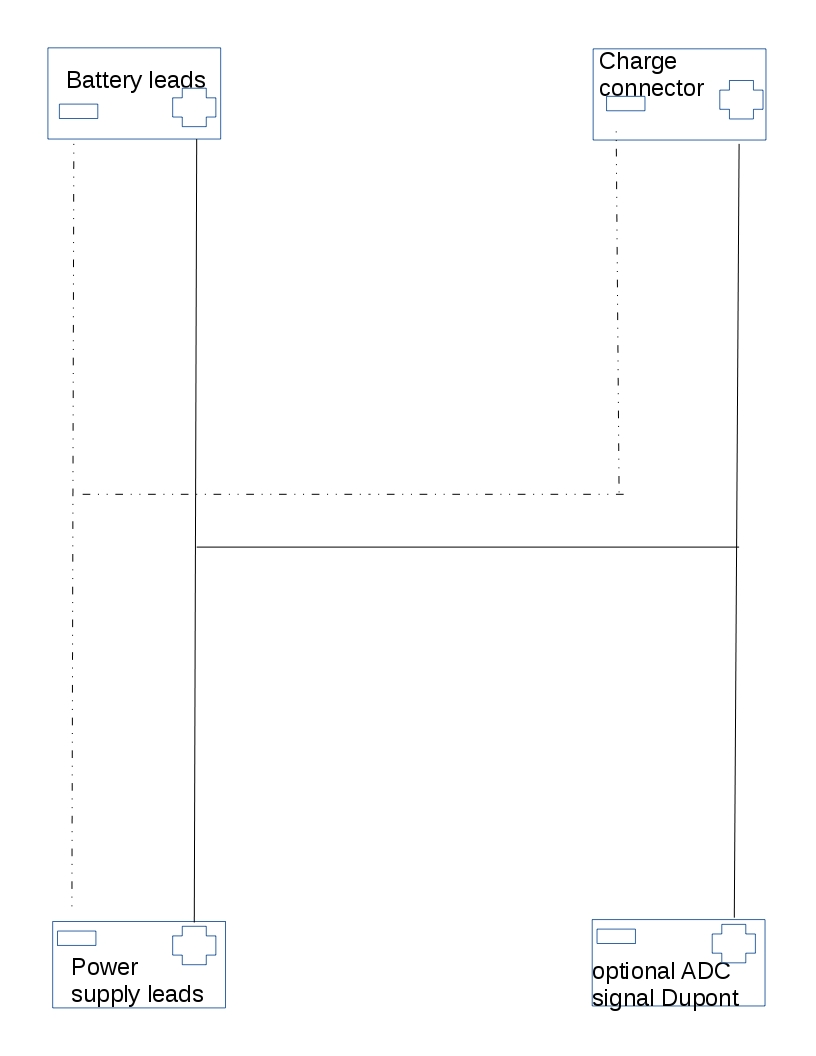
POWER_ASSEMBLY_WIRING.jpg
