bobbybudnick/SFS-Mobile-Internet-Device/SPECIALIZED_USB_WIRING.jpg

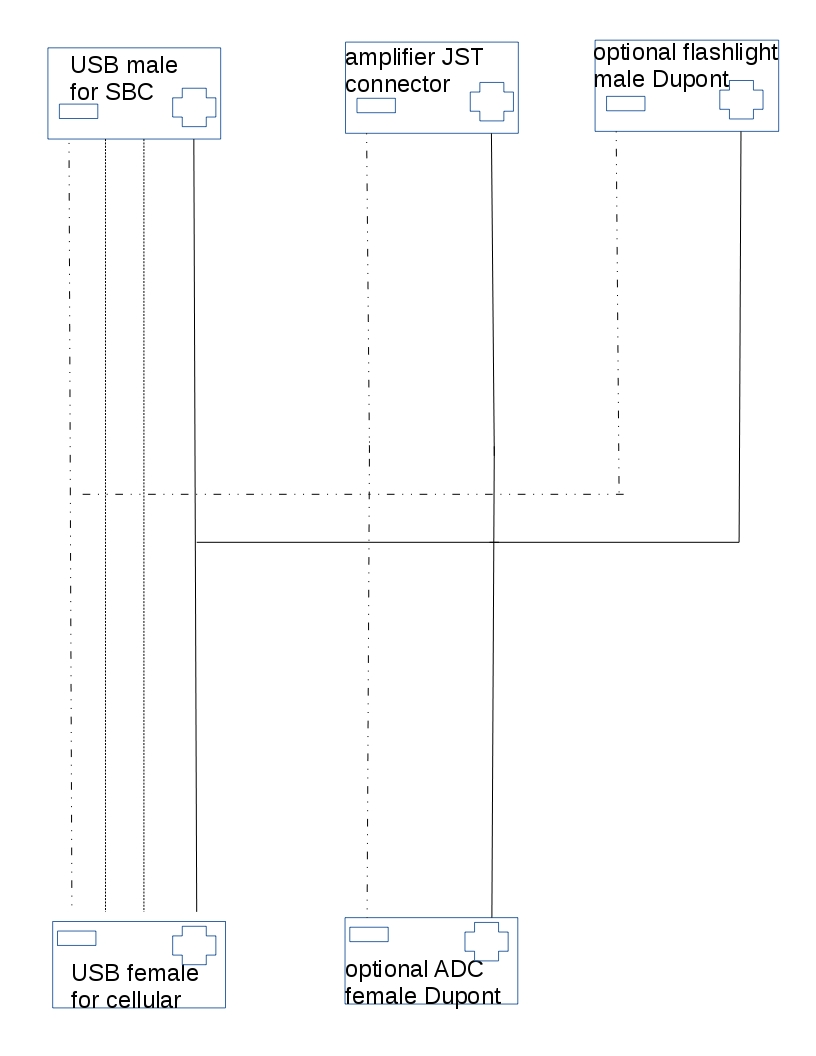
SPECIALIZED_USB_WIRING.jpg
