bobbybudnick/SFS-Mobile-Internet-Device/USB_WIRING_1.jpg

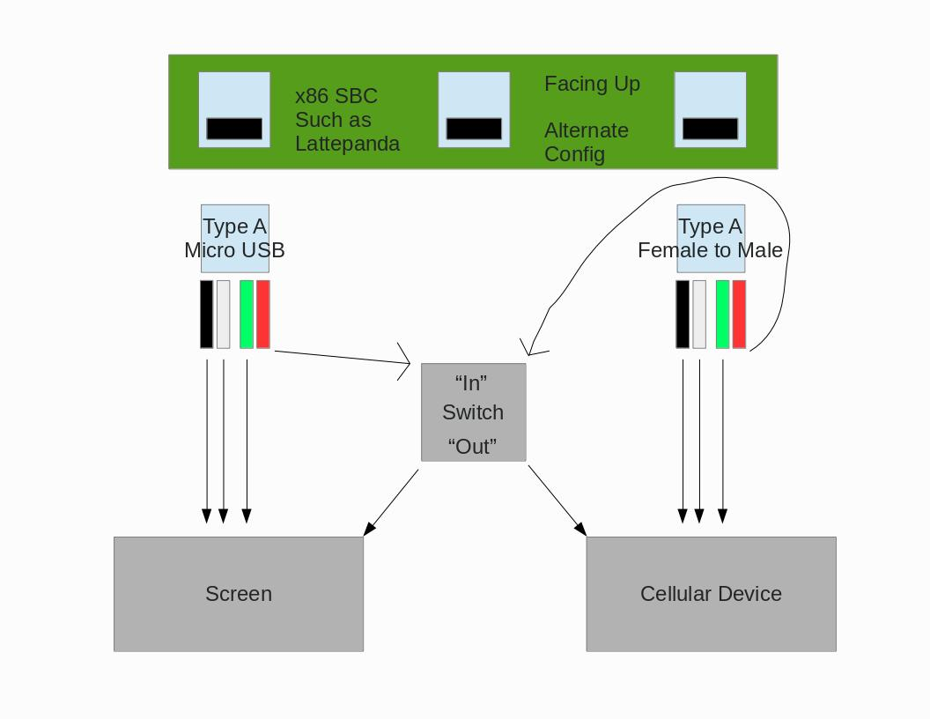
USB_WIRING_1.jpg
