bobbybudnick/SFS-Mobile-Internet-Device/USB_WIRING_2.jpg

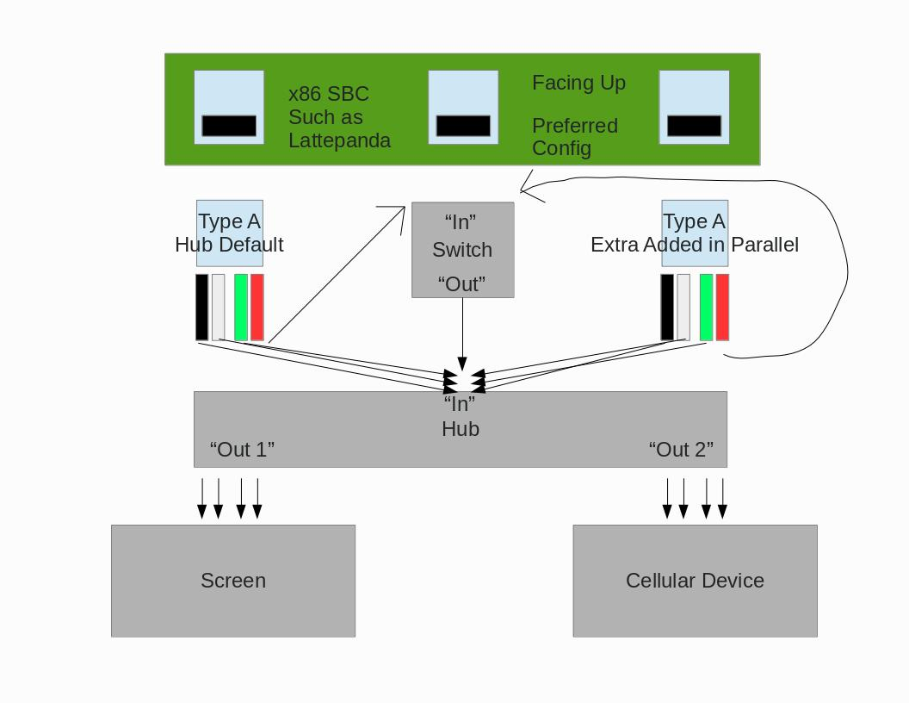
USB_WIRING_2.jpg
