bobbybudnick/SFS-Mobile-Internet-Device/(threads)

Thread 1 (2016-10-15):

No cellular call capability

bobbybudnick, 2016-10-15:
Description: There is no way to make cellular calls
Explanation: Huawei E303 is data only device
Workaround: Use VOIP instead
Models affected: all

Thread 2 (2016-10-15):

Rundown power failure

bobbybudnick, 2016-10-15:
Description: When LCD shows 0% device will not start
Explanation: Power board may track by mah used instead of voltage
Workaround: Recharge with micro USB or implement software controls with ADC

Fixed: closed because this problem has not been reproduced with the Geri dual USB power supply.

Closed 2017-06-07.

Thread 3 (2016-10-15):

No accurate time

bobbybudnick, 2016-10-15:
Description: Sporadic secure connection errors and incorrect displayed time
Explanation: Raspberry Pi 2 lacks a real time clock
Workaround: Add an RTC/set up NTP/use debug menu

Fixed: closed because adequate time utilities have now been added to the default installation.

Closed 2017-07-25.

Thread 4 (2016-10-15):

Screen startup power surge

bobbybudnick, 2016-10-15:
Description: Screen can remain in unusable state after start up
Explanation: Power surge caused by large power supply
Workaround: Always startup with the screen switched off
Models affected: 1/2/3

Fixed: Not seen in testing in a very long time.

Closed 2016-11-28.

Thread 5 (2016-10-15):

White screen

bobbybudnick, 2016-10-15:
Description: White screen always or white screen always after a few seconds
Explanation: Screen Hardware Failure - faulty cable at board side or decoding circuitry fault
Workaround: Replace screen

Fixed: closed because this is a transient hardware problem.

Closed 2017-06-07.

Thread 6 (2016-10-15):

Phantom power-on

bobbybudnick, 2016-10-15:
Description: No power-off and power-on during build with micro amplifier and large power supply
Explanation: Signal ground is connected to 3.7v ground causing power supply to partially enable
Workaround: Disconnect headphone jack and hold power button to power off
Models affected: 1 and 3

Fixed: Use spliced USB cable for power instead

Closed 2016-11-28.

Thread 7 (2016-11-10):

Inconsistent touch response across entire screen

bobbybudnick, 2016-11-10:
Description: Touch inputs are erratic on all areas of the screen
Explanation: Screen Hardware Failure - faulty cable at screen side
Workaround: Replace screen

Fixed: closed because this is a transient hardware problem.

Closed 2017-06-07.

Thread 8 (2016-11-10):

Digitizer separates from screen

bobbybudnick, 2016-11-10:
Description: Digitizer becomes loose from screen assembly
Explanation: Screen Hardware Failure - laminate breakdown
Workaround: Replace screen

Fixed: closed because this is a transient hardware problem.

Closed 2017-06-07.

Thread 9 (2016-11-10):

Inconsistent touch response in large area of screen and/or repeated calibration failure

bobbybudnick, 2016-11-10:
Description: Touch response poor or missing in large areas of the screen and/or calibration always fails
Explanation: Screen Hardware Failure - unknown non-laminate related cause - possible screen warping
Workaround: Replace screen

Fixed: closed because this is a transient hardware problem.

Closed 2017-06-07.

Thread 11 (2016-12-01):

Kopete message notification not working properly

bobbybudnick, 2016-12-01:
Description: Kopete lacks new message animated notification
Explanation: Possible upstream bug??? - https://bugs.kde.org/show_bug.cgi?id=228527
Workaround: Use the notification light or audio tone to alert to incoming messages or keep window open

Fixed: closed because the problem is not currently reproducible.

Closed 2017-08-12.

Thread 12 (2016-12-10):

Data dead zones with Huawei E303

bobbybudnick, 2016-12-10:
Description: In certain areas the Huawei E303 data does not work - signal is high
Explanation: Huawei signal reporting is not calibrated for north american towers - signal is truly poor
Workaround: Use signal booster or disassemble and rebuild into device that uses 313U or 340U

Fixed: closed because this is a duplicate of #21.

Closed 2017-06-07.

Thread 13 (2016-12-19):

Frequent data disconnections with USB "EMI" warning in system log

bobbybudnick, 2016-12-19:
Description: Data disconnections, slowdowns, or instability with USB errors in system log
Explanation: Shorted or crossed wires in USB cable
Workaround: Replace or repair USB cable

Fixed: closed because this is a transient hardware problem.

-----

Model 21/23 Specific

issue - cellular failures with 340 and 313
always a problem with signal or usb issues at remote sites
may need a direct connect cellular prototype

may be cellular device problem - unlikely - only because it transmits powerfully
may be sbc problem - unlikely
may be cable problem - very likely

try same type of cable - unlikely                                     
try different type of cable - unavailable - only other cable is unshielded as well
try to route cable differently - not working
try to wrap existing cable with foil tape and then electrical tape

evaluation of the switch of cellular device from usb 3 port to microphone usb 2 port
positive - screen switch convenience
positive - screen switch power savings
positive - working cellular device
positive - freed up usb 3 port
negative - screen switch bulk        
negative - screen switch cable modification labor
negative - screen usb shielding compromised

definitely not a bad connection in cable
evidence: other sbc/cable has done the same thing and neither was abused
evidence: works with usb 2 port

340 signal marginal at site 1
340 signal very marginal at site 2
repair completed ->
model 23 seemed to work very well - 4/5 - maybe some very minor packet loss at site 3
model 21 seemed to work very well - 4/5 - maybe some very minor packet loss at site 3

Proposed mechanism for interference is feedback from the radio into the unshielded and untwisted data pair lines in the USB cable.

model 21 - experienced failure but cable replaced and rerouted - failure fixed
model 21 - now custom shielded cable installed
model 23 - experienced failure but custom shielded cable installed - failure fixed

Incredibly by wrapping the USB cable to the cellular device with foil tape then electrical tape this problem has been entirely eliminated.  Be sure to wrap the outside of the female USB connector with the foil tape as well.  Hopefully that will make a connection with ground.

See this link as well:
https://forum.odroid.com/viewtopic.php?t=6340

It is important to distinguish this issue from the USB brownout issue due to a bad power supply or connections:
https://github.com/bobbybudnick/SFS-Mobile-Internet-Device/issues/29

It is also important to distinguish this issue from the 340 random restart issue.  This is apparently caused by a bug in the 340 device itself.  A firmware update or check of a different 340 device might be a good idea.

Closed 2019-08-15.

Thread 16 (2017-05-15):

Linphone does not fit on screen in XFCE at 800x480 resolution

bobbybudnick, 2017-05-15:
Description: at a resolution of 800x480 some of the Linphone window is off screen and can not be resized.
Explanation: GTK does not respect window resizing applications.
Workaround: this necessitated the change back to KDE because Kwin has no problem force resizing windows.

Fixed: Closed because of the switch back to KDE.

Closed 2017-05-15.

Thread 20 (2017-05-24):

Text messages reappear after being deleted

bobbybudnick, 2017-05-24:
Description: deleted text messages in modem-manager-gui reappear after closing and reopening the program.
Explanation: modem-manager-gui normally runs as a normal user.  Normal users do not have permission to delete text messages.  The main thread was set this way because sometimes modem-manager-gui will segfault when run with kdesudo.
Workaround: close modem-manager-gui and reopen with kdesudo.

Fixed: main thread updated.

Closed 2017-06-07.

Thread 21 (2017-05-24):

E303 blinks green with verified good SIM card and SIM placement

bobbybudnick, 2017-05-24:
Description: Huawei E303 blinks green even after verifying SIM credentials and proper placement in the device.
Explanation: The signal is so poor that the device cannot register with the network even at a low level.
Workaround: No available workaround with this device.  If potential fixes do not help then 3G services in your area are simply insufficient.  Upgrade to a 4G device.

Fixed: closed because testing of this device is complete

Also see:
https://github.com/bobbybudnick/SFS-Mobile-Internet-Device/issues/12

potential fixes: signal booster - performance is still erratic and slow 5 feet away
potential fixes: modify shell to expose the antenna - did not help
potential fixes: try flipping e303 around - impractical due to cable connector
potential fixes: replace e303 with different e303 - worse performance
potential fixes: flip replaced e303 - impractical due to cable connector
potential fixes: replace e303 with entirely different device

Closed 2019-02-22.

Thread 22 (2017-06-06):

KDE: black border around objects

bobbybudnick, 2017-06-06:
Description: window decorations cause a black border around many objects
Explanation: unknown upstream bug possibly related to:
https://bugs.kde.org/show_bug.cgi?id=361477
https://bugs.kde.org/show_bug.cgi?id=361154
Workaround: disable desktop effects or switch to the oxygen theme to minimize the flaws

Fixed: no longer seen with kernel version 4.10.10-v8+

Closed 2017-06-07.

Thread 24 (2017-06-08):

"Network Setup" phase of boot is slow and unreliable with E303

bobbybudnick, 2017-06-08:
Description: when the main thread gets to the network initialization phase it must use mmcli to "enable" the modem and this process drags on and is fraught with failure with the E303 device.
Explanation: poor interaction between modem manager and E303.
Workaround: the main thread works around this by waiting until success or until 60 seconds is up and simply rebooting.

Fixed: closed because the main thread works around this and the Sierra 308 is a good alternative with similar dimensions.

Closed 2017-07-19.

Thread 25 (2017-06-08):

High pitched noise from speaker

bobbybudnick, 2017-06-08:
Description: a high pitched chirping noise from the speaker that varies with CPU load
Explanation: insufficient shielding allows in CPU interference to the audio path.  Twisting the speaker wires does not help.
**Workaround: NONE**

Fixed: closed because the build instructions describe a procedure for removing the audio ground loop.

Closed 2017-08-12.

Thread 26 (2017-11-01):

Audio unresponsive with Adafruit MAX98357 i2s amplifier

bobbybudnick, 2017-11-01:
Description: This amplifier can get into a state where there are no errors but no audio plays.  Explanation: The solution is to power cycle the device.
Workaround: When attached directly to the power supply this means power must be cut to the power supply for the amplifier to reset.

Fixed: closed because a valid workaround is available.

Closed 2017-11-01.

Thread 29 (2018-07-14):

Screen dims and/or USB controllers experience brownout

bobbybudnick, 2018-07-14:
Description: Screen dims and glitches out and touch fails
Explanation: Overall voltage drop through system causes negative effects
Workaround: Replace power supply with one that delivers 2A reliably
Models affected: 16

-----

model 16 specific

info: can once again reproduce on main device with 308
info: could never reproduce on backup device
info: 5% voltage drop should be 4.75v
info: wall plug fixed problem
info: same problem happens after reboot

wiring proposal 1 - implemented - failure
switch terminal 1 to power supply positive
switch terminal 2 to screen main positive
screen type a connector with disconnected positive
ground connections normal
the idea being that screen will take power direct from supply

wiring proposal 2 - implemented - failure
switch terminal 1 to power supply positive
switch terminal 2 to screen main and alternate positive
screen type a connector with disconnected positive
ground connections normal
the idea being that alternate connection could have less resistance

wiring proposal 3 - implemented - failure
micro usb is worse than even one type a connector
odroid c0 was better because it avoided micro usb
odroid c0 was worse because it used a weak onboard 5v regulator
with raspberry pi even direct 5v is irrelevant due to poor usb logic
use odroid c0, odroid c2 or lattepanda with direct 5v connection
36 awg - standard jumper wire gauge
32 awg??? - gauge of cable connected to micro usb connected to lattepanda
24 awg - best/maximum possible jumper wire gauge
36 awg - 0.127mm
24 awg - 0.508mm
huge difference in wire gauge size
voltage drop at 3.7 volts and 2 amps on 1 foot cable length
36:
Voltage drop: 1.66
Voltage drop percentage: 44.85%
Voltage at the end: 2.04
24:
Voltage drop: 0.10
Voltage drop percentage: 2.78%
Voltage at the end: 3.6
hardware 1: premade 24 awg jumper cable soldered to type a
hardware 2: female dupont pin crimped to 24 awg cable soldered to type a
usb 3.0 cable may have better conductors
many type a connectors have small gauge wire
many type a connectors use aluminum which is 60% as conductive
connect directly to 5v power pins

remove/resolder/replace switch
remove custom screen wiring
standard micro usb connection to screen touch input
if not working then hub to aux usb and then to screen power input
this should give the best chance of working
something is terribly wrong if this does not work
not the problem because cellular device still experiences brownouts

wire both screen wires direct to power supply
would still need to go through switch
not the problem because cellular device still experiences brownouts

replace power supply entirely
micro power supply is just too weak
small power fluctuations are hard to see on voltmeter
voltage stays strong until suddenly it is not
the only solution is to put 2 x micro power supplies in parallel
this results in much better stability that could be called perfect
the backup device may have slightly different power supply tolerances

future improvements - 1 brief black flash was noticed in testing
remove shields and install heatsinks
try adafruit powerboost x 2 power supply
try future power supply

-----

model 17 specific

info: screen went blank when playing audio

wiring proposal 1
fix by upgrading cabling
this improves voltage drop
connection is direct so not possible

wiring proposal 2
fix by turning power switch on
this puts onboard 5v regulator in parallel with secondary power supply
this ultimately did not fix the problem

wiring proposal 3
fix by setting display settings to 25/25/50
this also did not fix the problem

troubleshooting:
works with wall power supply
also works when connected to secondary power supply
provisionally the system itself is stable with just the mini jst connected
stability can improved by replacing and resoldering mini jst
stability can be improved by a y connector from secondary power supply
no usb initialization errors were detected
if this happened it would require a switched connection on both connectors
may only happen when screen gets power but no signal on touch connector

-----

Model 21 Specific

Model 21 and 23 uses direct micro USB connection from power supply to SBC.

No major problems with screen dimming or USB brownouts with these devices.

It is important to clarify that the USB bus interference issue is a different one and is classified here:
https://github.com/bobbybudnick/SFS-Mobile-Internet-Device/issues/13

Closed 2019-08-15.

Thread 31 (2019-02-04):

No audio output while in sleep mode

bobbybudnick, 2019-02-04:
Description: Audio does not play when sleep switch has been flipped
Explanation: Sleep switch cuts power to screen which houses amplifier
Workaround: Use external amplifier or other form of notification or use Model 23
Models affected: 16/21

Closed 2019-08-15.

Thread 32 (2019-02-04):

Uncertain cellular device behavior

bobbybudnick, 2019-02-04:
Description: Sierra 340 device is untested
Explanation:
E303 no longer works the same way with wvdial leading to uncertainty
Other devices may use different USB IDs with newer kernels
Other devices may use differing connection methods with newer kernels
Support has been repaired for e303, 308, and 313
Workaround: None currently researched
Models affected: 16

Fixed: closed because most devices have explicit support now.  There is no reason to think 340 will not work.  In addition 313 works well enough.

Closed 2019-02-24.

Thread 33 (2019-02-19):

wvdial/modemmanager does not detect a connected cellular device

bobbybudnick, 2019-02-19:
Description: /dev/ttyUSB* ceases to exist and modem manager and wvdial cannot find a working cellular device
Explanation: udev forgets configuration possibly because after a physical disconnect it thinks the cellular device is a new one.  This causes the custom udev rule not to match up with the device ID and usb_modeswitch_dispatcher is not run which loads the configuration which allows the device to switch to modem mode.
Workaround: These commands will force udev to rescan and hopefully sync configuration to installed devices:
sudo udevadm control --reload
sudo udevadm trigger

Fixed: closed because a fix has been incorporated into the codebase

Closed 2019-02-19.

Thread 34 (2019-02-19):

Qupzilla video streaming errors

bobbybudnick, 2019-02-19:
Description: With Qupzilla browser Youtube videos give an obscure error after a long loading delay and even wikipedia sample ogv movies have problems playing
Explanation: Qupzilla is incompatible with youtube
Workaround: Use Firefox/Iceweasel
Models affected: 16

Fixed: closed because a workaround has been incorporated into the codebase

Closed 2019-02-24.

Thread 35 (2020-09-22):

Voltage drops considerably when off charger

bobbybudnick, 2020-09-22:
Description: When on battery power or at high load the battery voltage drops precipitously.
Explanation: Battery is overloaded.  Only a small decrease in voltage drop occurs with a larger 3.7v battery.  There is very little voltage drop even with a small 12v battery.  This is because the higher power is more efficient and results in less heat buildup within the wiring and battery.
Workaround: At least a 50000mah 3.7v battery or just a simple 12v battery of any kind is required to avoid significant voltage drop.
Models affected: all except model 29.

Fixed: closed because all models incorporate at least a 2s (8.4v max) battery system

Closed 2021-08-28.

Thread 36 (2020-09-22):

Linphone SMS messages are sent to nowhere

bobbybudnick, 2020-09-22:
Description: Outgoing Linphone SMS do not go through
Explanation: Linphone is bugged
Workaround: Use a newer version of Linphone, a different SIP client, the VOIP SMS web interface, or a different cellular device with native cellular SMS capability
Models affected: all

Thread 37 (2020-09-22):

No notifications in deep sleep/standby/suspend

bobbybudnick, 2020-09-22:
Description: Notifications do not come through when the device is suspended
Explanation: Device CPU is totally stopped and USB power is off when suspended
Workaround: Do not suspend when expecting notifications
Models affected: all

Thread 38 (2020-09-22):

ARM MID hardware failures catchall

bobbybudnick, 2020-09-22:
New Issue Report

Description:
failure investigation 1
still seeing flickering after device warms up
test with power supply on usb-c connector at 7.5v - flickering
test with power supply on usb-c connector at 11.2v - flickering worse
we can see that unfortunately using the usb-c does not help much if at all
again it does not seem to affect stability
youtube seems to be worst case scenario for flickering
one radical fix might be to tap 5v from gpio and wire to screen micro usb power
gpio power boost made no difference so this means device 5v conversion is poor
for thin devices one with a flickering screen is better than a slow one like model zero
ultimately more investigation is needed                                      

failure investigation 2
an exploded device was built with identical components and works fine
the original device will flicker even when using ethernet
possible reasons for failure
heat from tighter design - the clone has less heatsinks so this is unlikely
check screen settings and match - negative because exploded device works with screen
defective screen - negative because it works with exploded device and ac power supply
defective stock usb cable - negative because it works with exploded device
defective hub causing higher 5v load - negative because it works with exploded device
one usb port may be stronger than the other - exploded device works fine both ways
wear and tear/difference between individual vim 3 - definitely the sbc itself
there is only the very slightest flicker occasionally with the exploded device

Explanation:
The individual VIM 3 is defective and not all VIM 3 units are defective.

Workaround:
To summarize ARM MID usage - at least on VIM 3 a power switch for components is not needed because these are powered off when sleeping. This makes interference naturally less of a problem. For now it seems ok to have the screen directly connected to one port on VIM 3 and on the other port a hub connected to the cellular device and another device like a keyboard or microphone.

-----

Mid Level Issue Report

Description: 4.3" screen flickers when watching a youtube video
when volume is increased and cores enabled the screen flickering is more noticeable
should not be reaching the battery current limit because current is well below 1 amp
does not seem to affect stability but the flickering is too unusable
Explanation:
control test with battery and right angle hub switched to left angle to expose usb-c
works fine

test with power supply on usb-c connector at 7.5v and 11.2v
voltage boosted slightly from average to account for wiring voltage drop
not necessary now but good to use in the future

one fix might be to put the usb-c connector in parallel with the vin connector
especially given the usb-c connector is not useful for legacy devices as it is in parallel with the vin
not necessary now but good to use in the future

3s may be more reliable
it seems there were not many power problems earlier at least with the 4.3" screen
the alpha and delta do not generally have brownout issues and they have a 3s system

Workaround:
remove all power draining accessories
replace hub
attach usb-c connector in parallel with battery wiring
change from a 2s battery system to a 3s system

Models affected: 38

-----

Earlier Issue Report

Description: At KDE login power usage peaks and device resets
Explanation: The 5v current limit is reached due to the additional power draw of the 5" screen
Workaround: Turn off screen at login time
Models affected: 30

Fixed: closed because ARM devices are not used anymore.

Closed 2022-10-23.

Thread 39 (2020-09-22):

No accurate battery reporting with VIM3

bobbybudnick, 2020-09-22:
Description: Battery state of charge shows full always
Explanation: VIM3 has no built in analog to digital converter
Workaround: Use voltmeter and/or charger to estimate state of charge or add ADC to GPIO pins and edit main thread
Models affected: all

Thread 40 (2020-09-22):

No accurate signal reporting with ZTE MF861

bobbybudnick, 2020-09-22:
Description: Signal strength is always full with this cellular device.
Explanation: ZTE MF861 is a next generation device without classical AT dialup support.  The device uses CDC ethernet protocols and can be managed at 192.168.1.1.
Workaround: Use management web interface to check or scrape signal.
Models affected: 27/30

Fixed: closed because the groundwork has been laid for USB ethernet device signal reporting through HTML reverse engineering.

Closed 2022-10-23.

Thread 41 (2020-09-22):

5" screen unresponsive at boot

bobbybudnick, 2020-09-22:
Description: The screen fails to respond to touch at boot.
Explanation: This device has firmware issues that cause it to stop attempting to communicate with the driver when it receives no data signal for some time, such as during a reboot.
Note that this is a different level of responsiveness than the no signal immediately at boot as sometimes seen with some SBCs.  That is a problem with the speed of HDMI signal decoding and this is a problem with the onboard screen USB controller.
Workaround: Shutdown and startup instead of rebooting.
Models affected: 30

Fixed: closed because the model 48 power scheme bypasses this since all USB hardware is reinitialized upon system wakeup.

Closed 2022-10-23.

Thread 42 (2020-09-22):

Cellular SMS not working with ZTE MF861

bobbybudnick, 2020-09-22:
Description: Modem manager does not run with this device and thus there is no way to send and receive SMS.
Explanation: This device is a next gen device with no traditional AT dialup support.  Administrative SMS only are received within the web management interface.
Workaround: Use VOIP based SMS.
Models affected: all

Thread 43 (2021-08-28):

Reliability issues with 8bitDo Zero 2 Bluetooth controller

bobbybudnick, 2021-08-28:
Description:

**This controller can work as a USB controller if all else fails.**

**Quirk:**
hangs retroarch at start and running games on xinput mode
either switch from xinput mode or turn off and connect after start
switching to dinput is easier than keeping the overlay turned on

**Zero 2 controller saga**
this is what the controller was doing at first after resting for several months
the controller ALWAYS attempts to reconnect to a previous device and asks for a pin
will not work with delta or alpha
antenna position is red herring
unsoldering and trying to discharge and resoldering battery is a red herring
controller not consistently found when in kde
test controller is consistently found
hcitool lescan failure is red herring but does work consistently on alpha
controller found after bluetooth/dbus restart and bluetoothctl power on/scan at vterm
org.bluez.error.authenticationcanceled caused by multiple device contention
still connection errors on delta and alpha after doing all this
only macos mode works on windows 8 test device
the fix was to downgrade firmware from version 1.05 to 1.03
switch mode - shows as pro controller - connect fails
dinput mode - shows as 8bitdo zero 2 gamepad - connect works
xinput mode - shows as 8bitdo zero 2 gamepad - connect works
macos mode - shows as wireless controller - connect works
keyboard mode - shows as 8bitdo zero 2 gamepad - connect works

**Zero 2 ongoing failures**
this is what the controller was doing after finally getting it to work as seen above
continuous disconnects with lattepanda delta
try charging zero 2 - fail
try hciconfig hci0 reset - fail
try reboot - fail
try steel series controller as control and backup config - works perfect
try relocating antenna - zero 2 still fails

Explanation: Suspect hardware failure in the controller.

Workaround: Replace controller

Models affected: All

Fixed: closed because this was not a problem with the project at all and simply one with the hardware.

Closed 2022-10-23.

Thread 44 (2021-08-28):

Battery bulges and/or device fails after some time

bobbybudnick, 2021-08-28:
Description:  When left on battery power for an extended time running a moderate (desktop idle) to high (gaming) load the battery can experience bulging, internal shorts and possibly even present a safety incident.  After a power failure or poweroff the device may not respond and there may be no apparent power from the battery.

Explanation:  So far the blue batteries have only experienced this.
1 large blue battery bulged but not shorted
1 small blue battery bulged and shorted
1 small blue battery bulged and shorted
to check for internal shorts power off completely and check for heat and discharge
there should be no heat and no power loss while battery is switched off
if there is heat and power loss while switched off recycle battery

Workaround:  When finished using the Mobile Internet Device please put the device to sleep.  This allows the battery to charge while cool instead of being heated by the device internals.  Obviously this has the very real limitation of no notifications while charging.

A thicker device could be built to insulate the battery from the device internals.  Alternatively the screen power could be manually switched off but doing this would remove audio notifications just as sleep would??? and additionally there is no way to know currently if the device is charging to automatically handle turning screen power off and finally signal cannot be cut to the 5" without it repeating a no signal screen.

A commercial smartphone handles this by slowing the rate of charge based on the battery temperature and dimming the screen to reduce charge requirements and heat and generally has less power usage in general because of the lack of peripherals and weak processor and LED backlit screen.

Thread 45 (2021-08-28):

No notifications while charging

bobbybudnick, 2021-08-28:
Description:

https://github.com/bobbybudnick/SFS-Mobile-Internet-Device/issues/44

Explanation:

https://github.com/bobbybudnick/SFS-Mobile-Internet-Device/issues/44

Workaround:

Do not suspend when expecting notifications.  These charging issues appear over time and not from a single charging session.

Models affected: All

Fixed: closed because this issue is essentially the same as this one:
https://github.com/bobbybudnick/SFS-Mobile-Internet-Device/issues/37

Closed 2022-10-23.

Thread 46 (2021-08-28):

MID hardware failures catchall

bobbybudnick, 2021-08-28:
Description:

Typical problems
screen backlight flickers
screen display cuts in and out
frequent issues with touch input
cellular issues with good signal
usb emi errors in kernel log

Existing test configuration
4.3" screen and cellular connected to hub and hub 5v input is switched
this caused the usual problems
problem stopped when screen connected to external power
problem got much worse after plugging in another hub and keyboard

Explanation:

The first series of tests and brainstorming was put into action for this problem.

idea 1
switch hub at output instead of input and put type a power in parallel
too complicated and still uses up 2 type a connectors
not implemented

idea 2
screen gets type a and cellular gets type a with common 5v switch
implemented with failure
exposes much of the data lines to interference
less simple in practice than theory to create
high potential for loose and shorted connections
results in damage and sacrifice of wiring
a mess to integrate
was somewhat unreliable with hub before but now far worse
totally unusable this way to a maximum degree
yet we will see that in some configurations this works ok

idea 3
direct wire screen usb to hub output
probably not going to be satisfactory
kind of a band aid fix
also breaks shielding in hub wiring
not implemented

None of those ideas were successful so we move on to an expanded range of troubleshooting possibilities.

strategy 1
improve loose and broken wiring at hub switch
largely fixed but there is not much room to work

strategy 2
use of the hub in general
the hub is actually shielded from emi
it may have power backfeed features that also help
only the hub power lines need to be modifed and data does not
shielding is left largely intact
only modification is on the hub input side and no others
wiring is kept simpler
shielded cables can be used downstream
being usb 2 may help because cellular tries to connect at usb 3 speeds otherwise

strategy 3
use of second type a connector positive wire for hub switch
takes up a second port but leaves one free
a booster if screen dimming is still a problem

strategy 4
use of external power microusb connected to second type a and hub switch
hopefully touch will still work this way - there is a concern about external power port
another booster if screen dimming is still a problem

strategy 5
use of 5" screen
4.3" screen seems more susceptible to interference
constant errors may take out all usb devices
5" naturally expands and reduces emi zone
test existing model with 5" screen

keyboard wiring
if strategy 1/2 is a success then use unmodified microusb in second port
if strategy 3 is a succcess then the third port would be needed
if strategy 4 is a success then custom wiring can be used

The results for each individual strategy will be discussed here.

strategy 1/2
screen is still in brownout flickering state
already very much more stable as far as dmesg errors and touchscreen failures
some screen disconnections after a while

strategy 3
some disconnect and flickering and usb emi errors still
also total system freeze
is ground attached to second type a port??? - ground was not attached

strategy 3 with second type a ground connected
control test with second type a not connected
failures begin when we went to open the web browser and load up 5v with cellular
----- set max efficiency 7w in bios - turbo mode keep on - force 5w in software
repeat test again after bios change
strategy 3 with second type a ground connected
control test with second type a not connected
flickering and standard failures

strategy 3 with second type a ground connected
non control test with second type a connected
works noticeably better than ever before

strategy 4 - not tested yet
external power connected - may not initialize touch correctly

strategy 5 - not tested yet
admit defeat and go with the 5" screen

extended strategy - not tested yet
look heavily into bios options and consider emi from alpha model is just too great
very telling that delta/5" is still stable after wiring change

conclusions
interesting that delta/5" with the same idea 2 wiring as alpha 4.3" is more reliable
seems that it took 2 type a driving the hub in parallel WITH grounds connected
none of the old wiring "ideas" worked but strategy 3 seems to work ok
was the problem rooted in brownout or interference or both???
backlight flicker character has changed from intermittent to a constant high speed

final keyboard wiring
will certainly be more reliable to dedicate keyboard to type a port instead of wiring
wiring for keyboard could be a contributing factor to idea 2 wiring instability
given that delta/5" has similar wiring but no keyboard wiring and seems to work well

fate of delta/5"
add dedicated type a cable for keyboard wiring to eliminate any stability problems
not wired for keyboard currently anyway
is represenative of a failure to standardize devices

hub input wiring
second type a is wired in parallel
red wire is broken for switch
black wire and all others and metal ground connections are kept connected
additional shielding or wire twisting is not used
black wire is stripped but not broken for connection to second type a
hub direct to cellular and typical right/right angle microusb used for screen

Workaround:

final results
delta/5"/340/2 type a with switch in parallel/no keyboard wiring - stable
alpha/4.3"/zte/2 type a with switch in parallel/keyboard wiring - unstable
alpha/4.3"/zte/hub with switch on input/no keyboard wiring - unstable
alpha/4.3"/zte/hub with 2 type a no ground on 2nd&switch/no keyboard wiring - unstable
alpha/4.3"/zte/hub with 2 type a switch on input/no keyboard wiring - stable

To summarize x86 MID usage - you may be able to use any wiring you want with the 5" screen.  If you use the 4.3" screen, then use a hub with 2 type a inputs bonded together for more power.  You may be able to get away with using any wiring even on the 4.3" screen because this is highly dependent on the exact configuration of the device.

To summarize ARM MID usage - at least on VIM 3 a power switch for components is not needed because these are powered off when sleeping.  This makes interference naturally less of a problem.  For now it seems ok to have the screen directly connected to one port on VIM 3 and on the other port a hub connected to the cellular device and another device like a keyboard or microphone.

Models affected: All

Thread 47 (2021-08-28):

Bluetooth trouble with Android devices

bobbybudnick, 2021-08-28:
Description:

Sending files from alpha to android device fails

Explanation:

pairing works fine but connections fail
hcitool/gattool/bluetoothctl all will not connect
all file transfer programs show connection refused code 111
could test with delta
could test with vim 3
could test with receiving files from android device

Workaround:

None available

Thread 48 (2021-08-28):

Battery pack charging affects system

bobbybudnick, 2021-08-28:
Description:

SBC shuts down hard when connecting or disconnecting charger or usb devices
Was a problem with blue batteries but less so

Explanation:

Special parameters are needed to prevent voltage transients from occuring
Unknown if the battery protection circuity or sbc is the problem
Any movement of the device can trigger a hard shutdown
Problem seems to be in the charger wiring perhaps at the connector

Workaround:

Connect - only while sleeping with 300ma out on/off OR low load with 300ma out on
Disconnect - only while sleeping with 300ma out on/off OR at low load with out off

Models affected:  All

Fixed: closed because this problem is not seen anymore for a long time.  The problem likely was centered on the barrel connector which is troublesome anyway and not used anymore.

Closed 2022-10-23.

Thread 49 (2021-08-28):

Various Lattepanda Alpha hardware problems

bobbybudnick, 2021-08-28:
Description:

Lattepanda Alpha may seem like it has died, or the power button no longer works, or the antenna was lost or broken.

Explanation:

Power issues may cause the no boot problem or physical damage may affect the power button or antennas

Workaround:

No boot fix - disconnect power/remove cmos battery/hold power/reconnect power
Power button fix - use pc power button and a certain sized jst cable
Antenna fix - use aux antenna for bluetooth

Fixed: closed because these issues all have a sufficient solution.

Closed 2021-08-28.

Thread 51 (2021-08-28):

Gmail login failures with Claws Mail

bobbybudnick, 2021-08-28:
Description:

Gmail does not seem to work with Claws Mail when checking or sending mail even though configuration is correct

Explanation:

Google feels that Claws Mail is somehow not acceptable

Workaround:

Check for security message in email account - not likely
Set to allow less secure apps - moderate chance
Use displayunlockcaptcha page - required every time

Models affected:  All

Fixed: closed because this problem is unique to Gmail.  All the above-board email providers work fine.  Gmail is broken.  For example, Microsoft Outlook works fine.

Closed 2022-10-23.

Thread 54 (2021-08-28):

Boot hang

bobbybudnick, 2021-08-28:
Description:

The system boot hangs for around 30 seconds near mount time

Explanation:

Somehow a swap device was specified in fstab
Also specified in /etc/initramfs-tools/conf.d/resume

Workaround:

edit fstab
edit /etc/initramfs-tools/conf.d/resume
update-initramfs -u required to save changes

Fixed: closed because this is presumably a one time occurence.

Closed 2021-08-28.
